jodancain/independent-cellular-ai-glasses/README.md

# 独立蜂窝智能眼镜开发需求

**v0.1 公开讨论稿 · 来源核验日期 2026-11-02**

本项目整理可独立联网的智能眼镜需求，供硬件供应商、系统开发者和集成方共同评审。优先面向汽车服务场景中的现场作业与远程协作，并预留面向车主的功能路线。

目标是找到一套**脱离手机和手机热点、使用机内 SIM 或 eSIM 蜂窝网络、由 ARM 应用主处理器运行自研业务软件**的可维护方案。应用、账号和云服务由项目方自主建设，不以第三方消费级品牌的账号、AI 或云服务作为核心功能前提。

本仓库是需求、证据和方案讨论的协作入口，**不是可直接量产的硬件设计，不是性能承诺、采购订单或最终冻结规格**。具体配置、费用、认证、供货与维护责任须另行确认。

## 从哪里开始

| 文档 | 内容 |
| --- | --- |
| [开发需求](docs/requirements.md) | 硬性边界、场景、硬件选项、系统交付和验证方法 |
| [芯片候选](docs/chips.md) | 已讨论平台的公开信息、项目判断及待核实项 |
| [工程判断](docs/engineering-assessment.md) | 选型依据、系统集成风险及证据边界 |
| [串流终端方向](docs/streaming-direction.md) | v0.7.6：眼镜有脑、有小脑、有手、有脚（脚 = 蜂窝 / Wi-Fi 7 / BLE / USB-C 连接，决定 #25）；默认无线、依赖网络而非手机的串流 AR 眼镜；联网全功能 / 断网手表模式、光波导 + 光机、手机级视频通话与虚拟形象、6DoF 真实画面交互、开放云、8 小时混合续航、续航优先、佩戴无感的重量分配、芯片组合 |
| [技术路线](docs/technical-roadmap.md) | 四颗主芯片按角色分工（主 SoC 与显示与重投影处理器是小脑，RedCap 是脚，常驻 BLE 与听音的低功耗 MCU 是常醒的小脑兼管脚的 BLE）各子系统主选 / 备选与切换条件、软件栈与开放协议、M0 验证 → M1 桌面功能样机 → M2 完全版样机 → M3 优化样机 |
| [在线浏览](https://glasses.youngtuo.win/) | 本仓库文档的网页版与动态架构图，公网可直接访问 |
| [系统架构图](docs/system-architecture.md) | 11 张图：系统全景（脑 / 小脑 / 手 / 脚）、硬件框图（两张）、显示数据通路（含看板态）、软件栈、协议通道、功耗状态机、通话与虚拟形象、部署视图、显示模式与小脑调度、投屏与多路信号；动态版见 `visuals/architecture-motion` |
| [设计开发要求](docs/design-requirements.md) | 218 条可验收要求（SYS / HW / PWR / DISP / NET / SW / HOST / PROT / CALL / APP / CLOUD / ERGO / SEC / DEV），每条含来源、优先级、验证方法、阶段，附 25 条决定追溯表与脑 / 小脑 / 手 / 脚角色映射 |
| [原型经验](docs/prototype-learnings.md) | 应用原型里验证过的核心技术：第一视角投屏与专家标注回传、远程视频通话（路线收敛、六档带宽自适应、会议入会）、头姿与相机–IMU 时间对齐、显示–相机标定、采集质量门、Agent 边界与来源标注 |
| [现成硬件验证计划](docs/validation-plan.md) | 自研前用现成设备做的 6 组验证：串流延迟与兼容、6DoF 交互、RedCap 联网与睡眠、手表模式功耗、视频通话与虚拟形象、佩戴无感基线；含设备清单、步骤、通过标准与记录表 |
| [第 1、3、6 组设备准备清单](docs/equipment-groups-1-3-6.md) | 先做的三组验证的候选设备、共用关系与核实项（不含价格） |
| [测试工具](tools/README.md) | 第 1、3、6 组的计时页、延迟统计、RedCap AT / 测速 / 电流分析、人体工学统计脚本（标准库，含单元测试） |
| [供应商回复模板](docs/supplier-response.md) | 可复制的技术方案回复与偏差表 |
| [硬件初版 v0.1](hardware/v0.1/README.md) | 两块板的 KiCad 原理图与初版 PCB（MCU 常驻板全真实器件、已布线、剩 4 处断线；主板主 SoC 等为占位、只有布局），网站 [硬件页](https://glasses.youngtuo.win/hardware.html) 用 three.js 三维查看；还不能下单 |
| [完整来源](docs/sources.md) | 官方资料、公开参考项目及核验日期 |
| [贡献指南](CONTRIBUTING.md) | Issue、Pull Request 和公开资料边界 |

## 当前合作重点

1. 对比 W527、W5 系列蜂窝SKU及供应商已有量产经验的替代方案，不预先锁定单一芯片。
2. 对基础 HUD 文字箭头与空间 AR 分两档提案和报价，不将 6DoF 作为统一硬性要求（本条针对[开发需求](docs/requirements.md)的轻量眼镜；[串流终端方向](docs/streaming-direction.md)需求方已确认需要 6DoF）。
3. 在相同负载下验证整机功耗、温升、续航、音视频、显示和蜂窝并发能力。
4. 确认 BSP、驱动、系统接口、权限、签名、OTA、许可和长期维护能实际交付。

## 如何公开协作

- 对需求、资料或结论有补充，可先开 Issue，说明具体问题、来源和影响。
- 供应商可复制[回复模板](docs/supplier-response.md)，通过 Pull Request 提交可公开的技术方案；也可直接提出文档修订。
- 每次修改应区分公开事实、项目判断、建议目标和待确认项。参数变化须附来源版本、测试条件或明确的待验证说明。
- Pull Request 由维护者评审后决定是否合并。提交建议不代表获得直接写入权限、方案被选用或采购承诺。
- 商业报价、合同、保密资料和个人联系方式不放入公开 Issue 或 PR，另用双方确认的非公开渠道交流。

## 公开内容边界

本仓库只维护可公开的文本需求和引用。不接收固件、SDK 二进制、解包文件、私钥、令牌、真实设备标识、内部日志或客户数据。不要上传本方内部需求文件的原始副本。

## 许可状态

本项目暂未选择仓库许可证。不要把公开可读或接受 PR 理解为已授予 MIT、Apache 或其他开源许可。引用的第三方项目和资料分别遵循其自身许可与使用条件；本仓库不改变这些条件。
