jodancain/independent-cellular-ai-glasses/docs/chips.md

# 芯片候选与选择依据

**v0.1 公开讨论稿 · 来源核验日期 2026-11-02**

推荐顺序是本项目的工程判断，不是厂商对智能眼镜适用性的认证。优先让供应商对 W527、W5 系列加蜂窝及其成熟替代方案提交同负载整机数据，不提前锁定单一芯片。

## 候选对比

| 候选 | 已核实的公开信息 | 本项目判断与待确认项 |
| --- | --- | --- |
| W527 优先询价 | ARM 1×A75 加 3×A55；LPDDR3/4X、eMMC 5.1；LTE Cat4、VoLTE；1080p30 编解码。[S1](sources.md#s1) | 较贴近独立蜂窝应用主机需求。询问真实可采购 RAM/存储、摄像与显示 BSP。4GB 加 32GB 是询价目标，没有已验证量产配置证据。 |
| W5 与 W5+ Gen 1 优先询价 | SW5100 四核 A53；W5+ 配套 M55 协处理器。公开 LTE Cat1/4；TurboX 板实例为 2GB 加 32GB、Nano SIM。[S2](sources.md#s2)[S3](sources.md#s3) | 须区分 SW5100 蜂窝与 SW5100P 版本。参考板 eSIM 标为 Reserved，不能当成已实现；确认摄像显示并发能力、BSP 和整机热功耗。 |
| RV1126B 功能原型 | 四核 A53、3 TOPS、H.264/H.265、DSI；Luckfox Aura 有 1/2/4GB 板级选项与 Linux 资料。[S4](sources.md#s4)[S5](sources.md#s5) | 便于摄像与 Linux 功能验证；蜂窝需另行集成。不能据开发板认定轻眼镜低功耗，官方 8M30FPS 典型功耗仍为 TBD，不能套用旧 RV1126 数字。 |
| AR1 与 AR1+ 有条件评估 | 公开连接信息以 Wi-Fi、蓝牙为主；提供面向眼镜的媒体和端侧 AI 能力。[S6](sources.md#s6)[S7](sources.md#s7) | 离线小模型能力不等于原生 LTE。独立蜂窝需供应商证明完整架构；RAM、系统开放度、modem 集成和持续并发能力待核实。 |
| W5+ Gen 2 备选询价 | 四核 A53、4nm、LPDDR4，公开有 LTE 平台信息。[S8](sources.md#s8) | 不能自动按 Gen 1 推定 Cat4、RAM 容量或摄像编解码能力。询问供货、BSP、蜂窝版本及是否有可展示的目标整机。 |
| Wear Elite 跟踪新平台 | 3nm、LPDDR5、LTE 与 RedCap、双 CSI；公开 Android 与 Linux 支持信息。[S9](sources.md#s9) | RAM 容量、视频编码能力、持续整机功耗及可获得的 BSP 仍需询证。公开 CPU 信息不支持自行补写核型和核数。 |
| BES2800BP 辅助路线 | 双 M55 加双 STAR-MC1；共享 8.3MB SRAM；PSRAM/Flash 为配置项；公开 Wi-Fi、蓝牙和 DSI。[S10](sources.md#s10) | 更偏 MCU 级路线。未获得官方 LTE、ISP、H.264 完整证据，不宜直接当成所需 ARM 应用主机；采用时须证明外接媒体与蜂窝方案。按方案决定 #24，它是低功耗 MCU 的 B 案候选（片内蓝牙可常驻收手机的气泡 / 看板描述，音频强），与 A 案 STM32N657 + 小 BLE 芯片在 M1 并行评估，见[技术路线](technical-roadmap.md)第 1.5 节。 |
| BES6100 成熟度待核实 | 2026年10月23日三季报披露已进入客户送样阶段。[S11](sources.md#s11) | 不能写成已量产。主核、RAM、系统、视频链路、蜂窝及量产时间均需官方规格和供应商书面确认。 |
| STM32N657 辅助路线 | M55 MCU、4.2MB SRAM，具 ISP 与 H.264 能力。[S12](sources.md#s12) | 不是 Android 应用主机，不能以 SRAM 取代本项目所需应用 RAM。可评估专项采集或辅控，但不直接替代主方案。 |

## 配置与证据边界

- 芯片能力、开发板实例和最终眼镜是三个层级。板上 2GB 或 4GB 既不等于芯片容量上限，也不证明供应商能在目标功耗和结构中交付同等配置。
- W527 的 4GB 加 32GB、Android 的 4GB 加 32–64GB 都只是询价候选，不是已验证的统一量产配置。
- 参考板标注的 eSIM 预留不能写成整机已实现；蜂窝必须同时确认 modem、射频、天线、卡方案、运营商和认证。
- RV1126B 的公开典型功耗项仍为 TBD，不能用旧 RV1126 的数值代替。
- ESP32 系列不满足本项目 ARM 应用主核方向，可作为局部连接或控制参考，不进入主处理器优先名单。
- 任何方案仍需验证目标眼镜上的持续蜂窝上行、音视频、显示并发、功耗、热和资源趋势。

## 供应商补充证据

每条路线请补充可采购型号与版本、RAM/存储选项、媒体和显示能力、系统及 BSP 交付范围、第三方许可、供货及维护状态，以及同口径整机测试。参数缺少证据时标注待确认，不根据相近型号或上一代平台自动补齐。

完整官方链接和参考项目见 [sources.md](sources.md)。
