jodancain/independent-cellular-ai-glasses/docs/design-requirements.md

# 设计开发要求

**v0.3.3 · 2026-11-09 · 依据 方案 v0.7.6（含第 3.11、4.5 节投屏与多路信号）、技术路线 v0.1.4（含第 1.11 节充电盒、第 1.12 节制造与打样、第 2.4 节原型验证的链路与算法）、[原型经验](prototype-learnings.md) v0.1**

本文件把 [方案](streaming-direction.md) v0.7.6 第 0.1 节需求方已确认的 25 条决定、[技术路线](technical-roadmap.md) v0.1.3 的四颗主芯片结构、接口、功耗预算、软件栈、开放协议与 M0–M3 阶段，以及 [验证计划](validation-plan.md) 的闸门 G1–G6，转写为可验收的设计开发要求。除明确标注的公开参照外，不引入仓库外事实；不新增产品需求，不补造数字。

## 0 证据边界与读法

### 0.1 依据与范围

- 产品需求依据只来自上述三份文档；公开边界与仓库约束按任务要求执行（SEC-08、DEV-13）。[系统架构图](system-architecture.md) v0.1.2 与本文件同时发布，图中的接口、通路和状态机与本文件 HW / PWR / PROT / CALL 各节对应；两者冲突时以本文件和技术路线为准。
- 本文件覆盖完全版样机（M2）及之前的开发要求；M2 直接用光波导。更大视场光波导、蜂窝 chip-down、ASIC 替代 FPGA、取消独立显示处理器等属于第二代架构，不在 v0.2 验收范围。
- M1 可在桌面功能样机上验证；M2 在眼镜形态复验；M3 只在 M2 冻结架构内优化功耗、重量和散热，并做认证预测试。

### 0.2 证据边界

文中所有数值均为【设计目标】，**未实测**。厂商公开数字（包括芯片峰值、延迟、功耗宣传值）未经本项目复现，不能当作整机实测结果，也不能替代验收。源文档未给数值、明确写“待定”或写“首轮测基线后确定”的，本文件统一写「待定（M1 定案）」；M1 用验证计划基线定案，定案前不得写成已冻结指标。源文档之间的冲突不在本文件中自行裁决，另在交付说明中列出。

本文件不是冻结规格、性能承诺、采购订单或交期承诺。开发板、商用眼镜和模组评估板的结果只能说明趋势，不能直接当作目标整机数据。

### 0.3 三个编号体系不要混用

| 记号 | 含义 | 用在哪里 |
| --- | --- | --- |
| P0 | 必须；完全版样机必须具备，或放行前必须完成的交付/流程要求 | 本文件“优先级”列 |
| P1 | 应该 | 本文件“优先级”列 |
| P2 | 可选 | 本文件“优先级”列 |
| P1–P4 | 续航方案：P1 机身混合使用、P2 镜腿热插拔电池、P3 线控模块/口袋电池、P4 主机供电 | 方案 §5.3；本文件只在引用续航方案时写“续航 P1”等 |
| M0–M3 | 阶段：M0 现成硬件验证、M1 桌面功能样机、M2 完全版样机（EVT）、M3 优化样机（DVT） | 本文件“阶段”列 |

**优先级 P1 只表示“应该”，与续航方案 P1 无关。** 引用续航方案时必须带“续航”二字，避免与优先级混淆。阶段列只写要求最晚满足的 M1、M2 或 M3。

### 0.4 来源与验证写法

- 「决定#n」指方案 §0.1 的 25 条决定；「方案§x」指 [方案](streaming-direction.md)；「路线§x」指 [技术路线](technical-roadmap.md)；「验证计划 Gx」或「验证计划第 x 组」指 [验证计划](validation-plan.md)。
- 验证方法只使用四类：**测试**（仪器/台架/整机测量）、**分析**（计算、预算、架构核对）、**检查**（审阅文档、配置、清单、供应商答复）、**演示**（在样机上执行可观察的功能流程）。
- 延迟类测试按验证计划 §0.3：p95 用 nearest-rank，每组至少 30 个有效样本；网络类 RTT 至少 300 个样本。测试条件、设备和版本必须记录，原始数据不进公开仓库。

### 0.5 公开边界

本文件只写可公开技术信息，不写公司内部信息、价格、供应商联系人或密钥。测试原始视频、录音、日志、账号、真实设备序列号、SIM 卡号、IMSI/IMEI 和受试者个人信息按验证计划 §0.1 脱敏，不进入公开仓库。

---

## 1 系统与模式（SYS）

| 编号 | 要求 | 来源 | 优先级 | 验证方法 | 阶段 |
| --- | --- | --- | --- | --- | --- |
| SYS-01 | 产品定义两级功能模式：有可用网络且能连上主机或云时为全功能（联网）；无网络，或网络可用但所有主机和云都连不上时为手表模式（断网）。 | 决定#6；方案§2.1 | P0 | 演示：M1 桌面样机分别构造联网、断网、网络在但主机/云不可达三种条件，检查模式进入与功能保留/关闭是否符合定义。 | M1 |
| SYS-02 | 模式判定依据是能不能连上服务，不是有没有连手机；不依赖手机或手机热点完成全功能联网。 | 决定#3、#6；方案§1、§2.1 | P0 | 测试：关闭手机和热点，仅用机身蜂窝/Wi-Fi 建立会话；再断开主机/云，确认进入手表模式。 | M1 |
| SYS-03 | 模式切换无感：断网时当前串流画面淡出并提示“已切换到离线模式”；恢复联网后自动回到上次主机和会话。 | 方案§2.1 | P1 | 演示：M1 桌面样机执行断网→恢复，记录提示、画面淡出和回连结果；M2 整机复验。 | M1 |
| SYS-04 | 默认形态为无线：眼镜本体靠自带电池、机身蜂窝和 Wi-Fi 独立完成全功能；线控模块是可选配件，用于更长续航和更高带宽 5G，不是使用前提。 | 决定#3、#11；方案§1；路线§1.10 | P0 | 演示：M2 整机不接线控模块完成全功能；再接模块验证扩展。 | M2 |
| SYS-05 | 第一版样机为完全版，至少包含有线 A1/A2、Wi-Fi、机身蜂窝、6DoF 交互、视频通话 V1–V3、手表模式与同步接口、分级睡眠、BLE 气泡、看板态、常驻听音、虚拟形象；眼动摄像头当前版本只做预留、不装配。BLE 气泡 / 看板态属于联网或待机通路，断网时手机经 BLE 代为联网待确认（方案 §10），确认前不算手表模式功能。线控模块和换电电池作为配件同步打样。 | 决定#10、#20、#24；方案§9、§10；路线§3 | P0 | 检查：对照 M2 样机配置清单和演示记录逐项核对；确认眼动只预留、未装配；确认 BLE 气泡未算进手表模式；缺项不得判 M2 出口通过。 | M2 |
| SYS-06 | PC、手机、车机、云四类主机全部支持；多主机可用时按“有线 > 同局域网 > 云”优先，断线后自动回到上次主机。 | 决定#4；方案§3.4 | P0 | 演示：M1 依次接入四类主机（可用开发板/云主机替代），演示优先级和回连。 | M1 |
| SYS-07 | 6DoF 追踪、空间锚定、手势交互、平面/物体识别是基础能力；目标是 VR 级能力 + 光学透视 AR 效果，不追求完整 VR 游戏。 | 决定#5；方案§3.1 | P0 | 测试：验证计划第 2 组测锚定漂移、手势成功率/误触；M2 整机复验。 | M1 |
| SYS-08 | 手表模式只保留看时间、拍照、录像、录音和极小本地程序；串流、6DoF 叠加、软件兼容层、云 AI 及其他功能关闭。 | 决定#6；方案§2.1 | P0 | 演示：M1 断网后逐项检查保留/关闭功能；确认不能绕过进入串流或 6DoF。 | M1 |
| SYS-09 | 交互架构按“脑 / 小脑 / 手”分工：眼镜 + 云端 LLM 是脑，理解意图、决定派哪只手、决定显示什么；眼镜自身算力只当小脑，做姿态追踪、解码、多图层合成、重投影、光波导畸变校正、轻量卡片、条件反射、手表模式和显示分配；手机、PC、车机、云主机都是手。渲染规则：手渲染自己的内容；轻内容由小脑本地画；合成 / 锚定 / 重投影由小脑做，目标 ≤5 ms【设计目标】；不属于任何手的重内容交最近的有 GPU 的手（PC 优先，其次云）；重渲染永远不在眼镜上。 | 决定#22；方案§1.1 | P0 | 演示：M1 用手机看板、PC 应用、云虚拟形象各跑一条链路，检查内容由对应手渲染、眼镜只做合成 / 重投影；分析：核对各链路没有把重渲染放回眼镜。 | M1 |
| SYS-10 | 四个角色加器官贯穿全部设计：脑（眼镜 + 云端 LLM）、小脑（眼镜自身算力）、手（所有主机）、**脚（连接：机身蜂窝、Wi-Fi 7、常驻 BLE、有线 USB-C、可选线控模块 5G）**；器官为摄像头、麦克风、扬声器 / 耳机、光波导。每个硬件模块、软件模块、协议通道和验证项都要能说清自己属于哪个角色；脚的选路按“有线 > 同局域网 > 云”，细步（意图、气泡、看板描述）走 BLE、大步（视频、投屏）走 Wi-Fi / 蜂窝 / 有线；四条腿都走不到任何一只手时退化为手表模式。 | 决定#6、#22、#25；方案§1.1 | P0 | 检查：评审时按 §18 角色映射表逐项核对硬件框图、软件栈、协议和验证计划，每项都有角色归属且没有越位（例如重渲染不进小脑、派手不由脚决定）。 | M1 |

---

## 2 硬件（HW）

### 2.1 主 SoC（HW-SOC）

| 编号 | 要求 | 来源 | 优先级 | 验证方法 | 阶段 |
| --- | --- | --- | --- | --- | --- |
| HW-SOC-01 | 眼镜本体按四颗主芯片分工：AR 级主 SoC（联网全功能与 6DoF）、显示与重投影处理器（有线直通与上屏）、RedCap 蜂窝（独立联网）、低功耗 MCU（手表模式、睡眠、BLE 常驻与电源管理）。A 案在 MCU 外另加一颗小 BLE 芯片，B 案蓝牙在 BES2800BP 片内。 | 路线§0、§1；决定#24 | P0 | 检查：审阅硬件框图与接口表，确认四颗主芯片职责、A 案 BLE 芯片、接口和电源域与路线 §1.6 一致。 | M1 |
| HW-SOC-02 | 主 SoC 主选 Snapdragon AR2 Gen 1；AR1+ Gen 1 只在同时满足两个条件时作为备选：显示处理器负责把画面放大到光机分辨率；显示处理器用重投影把 60 Hz 内容补到 90 Hz 以上上屏。 | 路线§1.1 | P0 | 检查：审阅主选/备选评估报告和供应商答复，逐条核对两个条件；不满足不得切 AR1+。 | M1 |
| HW-SOC-03 | 主 SoC 门禁一：能在没有手机或 PC 时独立运行 AOSP 系统、6DoF 和云串流客户端；M1 结束前拿到供应商书面答复或实测结果。 | 路线§1.1 | P0 | 检查：审阅供应商书面答复；用开发板断开手机/PC，启动 AOSP、跑 6DoF 和云串流客户端。 | M1 |
| HW-SOC-04 | 主 SoC 门禁二：支持 H.265 硬解；AV1 是加分项。 | 路线§1.1 | P0 | 检查：核对芯片规格书，并在开发板上用 H.265 码流验证硬解；AV1 只记录是否支持。 | M1 |
| HW-SOC-05 | 主 SoC 门禁三：能把解码帧以 1080p 级、60 Hz 以上送给显示处理器；最终上屏分辨率和刷新率由显示处理器负责。 | 路线§1.1 | P0 | 测试：在开发板上测解码帧输出分辨率、帧率和送显通路；达不到即门禁不通过。 | M1 |
| HW-SOC-06 | 门禁不通过时按顺序切换：AR2 → AR1+（两个条件成立）→ “眼镜 + Reality Elite 计算盒”。走到计算盒形态会改变决定#11（默认无线），必须重新确认，不得直接实施。 | 路线§1.1、§4 | P0 | 检查：审阅切换决策记录；触及决定#11 时核对需求方重新确认记录。 | M1 |
| HW-SOC-07 | 主 SoC 并发能力门禁：主显示 1 路全帧率硬解、通话上行编码、两路追踪相机与主摄 ISP 同时运行；能同时硬解几路、编码解码并发上限以供应商书面答复或 M1 实测为准，不满足按路线 §1.1 切换。 | 方案§3.11；路线§1.1 | P0 | 测试：M1 参考平台跑“主显示解码 + 通话编码 + 两路追踪 + 主摄”并发 30 分钟，记录掉帧、温度与降频；分析：核对供应商规格。 | M1 |

### 2.2 显示与重投影处理器（HW-DP）

| 编号 | 要求 | 来源 | 优先级 | 验证方法 | 阶段 |
| --- | --- | --- | --- | --- | --- |
| HW-DP-01 | DP 接收桥主选龙迅 LT7911UXC 一类芯片：Type-C/DP1.4a 输入，MIPI DSI/CSI 输出，带 DSC 解码；备选为同类 DP 接收桥接芯片。 | 路线§1.2 | P0 | 检查：核对桥接芯片规格与 Linux 驱动；在评估板上打通 DP 输入到 MIPI 输出。 | M2 |
| HW-DP-02 | 原型用 FPGA 按最新姿态对整帧做扭曲，同时完成畸变与色差校正、缩放和 60→90 Hz 以上补帧；FPGA 只用于原型快速迭代，量产形态第二代再定。 | 路线§1.2 | P0 | 测试：M1 用 FPGA 板接现成光波导模组 / 光机评估板，测扭曲、校正、补帧和帧计数。 | M1 |
| HW-DP-03 | A1 有线原始画面支持两档：A1-3DoF 时主 SoC 休眠，显示处理器直读 IMU 只做旋转稳定；A1-6DoF 时主 SoC 运行 VIO 并提供 6DoF 姿态。DP 二维画面按平面虚拟屏合成，3D 内容改走 L1 OpenXR。 | 路线§1.2 | P1 | 演示：M1 分别演示 A1-3DoF 与 A1-6DoF，检查主 SoC 休眠/运行状态和虚拟屏稳定性。 | M1 |
| HW-DP-04 | A2/B/C 编码串流由主 SoC 解码，经 MIPI 交显示处理器扭曲后上屏；扭曲始终放在离屏幕最近的一级，保证头动感知延迟不受网络影响。 | 路线§1.2；方案§3.5 | P0 | 测试：M1 在 A2/B/C 链路测解码→MIPI→扭曲→上屏，确认头动感知延迟与网络延迟解耦。 | M1 |
| HW-DP-05 | 手表模式通过显示开关把显示切到 MCU 的低速显示接口，主 SoC 和显示处理器可断电；面板需支持低刷新、局部点亮。 | 路线§1.2、§1.6 | P0 | 演示：M1 切手表模式，确认主 SoC/显示处理器断电后 MCU 仍能驱动低刷新显示。 | M1 |
| HW-DP-06 | 可选（P2 / M1 次要评估项，不阻塞 M1 出口）：视频与显示处理器带硬解时，串流解码、重投影、上屏由该处理器完成，主 SoC 降为低功耗网络态（GPU / 视频解码 / 显示管线可关闭；CPU 网络部分是否可关取决于方案），只在 6DoF、AI、通话时唤醒。**降级理由：视频不再是主要场景，重渲染仍在手上，眼镜侧 GPU 要求只降不升。** | 路线§1.2、§4、§5#8；决定#24 | P2 | 检查：M1 只在有余力时核对 HX77 类候选的 H.265 / AV1 硬解、收流协议栈位置和双目输出规格；不作为 M1 出口条件，M2 再评估串流功耗收益。 | M1 |
| HW-DP-07 | 显示处理器多层叠加：至少把“DP 画面层 + 1 个叠加层”合成后再扭曲上屏；叠加层由 MCU 或主 SoC 经低速接口 / MIPI 送入，A1 时主 SoC 可睡也能出气泡。 | 方案§4.5；路线§1.2 | P1 | 测试：M1 在 A1-3DoF 下让 MCU 送一个气泡叠加层，检查合成结果与上屏延迟。 | M1 |

### 2.3 光学与显示（HW-OPT）

| 编号 | 要求 | 来源 | 优先级 | 验证方法 | 阶段 |
| --- | --- | --- | --- | --- | --- |
| HW-OPT-01 | 完全版样机（M2）采用**光波导**，且只用光波导；birdbath、自由曲面棱镜等其他方案已放弃，不再考虑。主选几何反射式（阵列）光波导，候选 Lumus Z-30 系列：30° 视场、演示机 720×720、几何反射式；新一代更薄（最薄 0.8 mm）、约轻 30%，70° 宽视场原型未公布量产时间。备选衍射式光波导：开源样机已用单绿衍射波导做出可戴样机（S59），全彩衍射波导仍待调研。 | 决定#21；路线§1.3；S49、S50、S59 | P0 | 检查：审阅光波导选型报告和供应商书面答复，核对主选/备选与量产状态；确认 M2 BOM 只含光波导方案。 | M2 |
| HW-OPT-02 | 显示走光学透视：人眼直接看真实世界，虚拟内容叠加其上，全彩；不以摄像头透视替代。 | 方案§3.1；路线§1.3 | P0 | 演示：M2 在真实桌面上放置虚拟屏，检查透视、遮挡关系和全彩叠加。 | M2 |
| HW-OPT-03 | 显示目标：双目光波导，视场 30–50°（以光机与波导组合定案）；分辨率以所选光机为准（待定，M1 定案）；入眼亮度目标约 4000 尼特以满足户外可读【公开资料】[S52](sources.md#s52)；刷新率 60 Hz 起，显示处理器可补帧到 90 Hz 以上（待光机确认）。 | 决定#21；方案§3.6；路线§1.3；S52 | P0 | 测试：M2 整机测视场、入眼亮度、分辨率、刷新率、全彩显示和双目一致性；分辨率在 M1 定案后回填。 | M2 |
| HW-OPT-04 | 光波导前框重量用验证计划第 6 组测得的鼻托受力基线约束；M2 用实物测鼻托受力，超标时按路线 §4 G6 处理。 | 路线§1.3、§4；验证计划第 6 组 | P0 | 测试：M2 用头模测光波导实物鼻托受力，与对标产品实测值比较。 | M2 |
| HW-OPT-05 | 光机主选 LCoS 或全彩 microLED，M1 定案。LCoS 参照 Meta Ray-Ban Display（Lumus 光波导 + LCoS）【公开资料】[S51](sources.md#s51)；全彩 microLED 参照 JBD Hummingbird（0.13 英寸、640×480、30° 视场可在 25–45° 定制、1.0 g、典型功耗约 260 mW）【公开资料】[S53](sources.md#s53)；高亮度小尺寸 micro-OLED（索尼 0.44 英寸 1080p、10000 尼特）【公开资料】[S46](sources.md#s46) 仅作亮度参照。切换条件：入眼亮度、分辨率、功耗、重量四项。 | 路线§1.3；S46、S51、S53 | P0 | 检查：M1 取得候选光机供应商书面答复，按四项条件评审并定案；记录未选路线的原因。 | M1 |
| HW-OPT-06 | 接受光波导的代价：当前视场明显小于已放弃的 birdbath 方案，虚拟屏面积变小，“Quest 级大屏观影”体验下降；换来前框更轻更透，符合“佩戴无感”（决定#18/#19）。该取舍已由需求方接受，不再把 birdbath 作为备选。 | 决定#18、#19、#21；方案§3.6、§7；路线§1.3 | P0 | 检查：M2 评审虚拟屏尺寸、观影体验与前框重量，确认取舍记录与需求方确认记录一致。 | M2 |
| HW-OPT-07 | 单绿 microLED 光机（640×480）+ 单绿衍射光波导只作 M0 / M1 早期验证件，用来先跑通通知层 / 看板态 HUD 和结构试装；不进 M2 BOM，不替代 HW-OPT-05 的全彩主选，不用于验证视频投屏。 | 路线§1.3；S59 | P2 | 检查：确认 M2 BOM 不含单绿光机；M1 用早期验证件跑通看板态上屏并记录结论。 | M1 |

### 2.4 蜂窝（HW-CELL）

| 编号 | 要求 | 来源 | 优先级 | 验证方法 | 阶段 |
| --- | --- | --- | --- | --- | --- |
| HW-CELL-01 | 机身蜂窝最低要求是满足串流最低网络要求，按 5G RedCap 选型；LTE Cat4 只在实测持续速率满足第 6.3 节三档时作为备选。 | 决定#9；方案§6.3 | P0 | 测试：验证计划第 3 组在强/弱信号下测持续速率和 RTT p95，对照 NET-01–NET-03。 | M1 |
| HW-CELL-02 | 原型主选 Quectel RG255C-GL（基于 Snapdragon X35）；对照/备选 RG255G-GL 或 LTE Cat4。切换条件：持续速率或 RTT 不满足方案 §6.3，或模组本身休眠电流不可接受。 | 路线§1.4 | P0 | 检查：核对模组规格与评估板；按第 3 组用例测速率、RTT 和休眠电流，触发条件时换对照模组。 | M1 |
| HW-CELL-03 | SIM 以 eSIM 为主，M2 期间保留实体卡槽，方便插运营商测试卡。 | 路线§1.4 | P1 | 检查：核对 M2 主板卡槽/eUICC 设计与样机配置。 | M2 |
| HW-CELL-04 | 蜂窝、Wi-Fi、蓝牙三套天线在镜腿内的布局、隔离度、灵敏度下降和 SAR，在 M2 画板前完成天线方案，M2 整机实测，不留到认证阶段。 | 路线§1.8 | P0 | 测试：M2 整机测共存、隔离度、灵敏度和 SAR 摸底；检查画板前天线方案。 | M2 |
| HW-CELL-05 | 机身蜂窝休眠电流是待机功耗最大风险，选型前必须实测；eDRX/PSM 是否生效以电流波形为准，不以 AT 返回“已设置”为准。若换模组仍不达标，高带宽场景交线控模块，机身降为“消息 + 语音 + 低码率”，并需重新确认决定#9。 | 方案§5.2；路线§1.4、§4 | P0 | 测试：验证计划第 3 组测 PSM/eDRX 休眠电流和波形；检查降级方案是否触发决定#9 重新确认。 | M1 |

### 2.5 低功耗 MCU（HW-MCU）

| 编号 | 要求 | 来源 | 优先级 | 验证方法 | 阶段 |
| --- | --- | --- | --- | --- | --- |
| HW-MCU-01 | MCU 按 A/B 两案并行评估，M1 定案：A 案 = STM32N657（Cortex-M55、4.2 MB 片上 SRAM、ISP、H.264）+ 外挂 PSRAM + 小 BLE 芯片，保留已论证的拍照 / 录像通路，代价是多一颗芯片；B 案 = BES2800BP 主选（S10：双 M55 + 双 STAR-MC1、8.3 MB SRAM、Wi-Fi、蓝牙、DSI，音频强），ISP/H.264 证据不完整，手表模式拍录像需短时唤醒主 SoC。主 SoC 平台自带低功耗岛只在开放给自研程序、能单独驱动摄像头和显示时作为共同备选。 | 决定#24；路线§1.5；S10、S12 | P0 | 检查：审阅 A/B 两案的开发板、BOM、重量、功耗和供应商开放性对比；按 HW-MCU-06 闸门定案。 | M1 |
| HW-MCU-02 | MCU 能独立完成拍照、录像、录音和手表模式小程序，不唤醒主 SoC；录像时可按需短时唤醒主处理器 ISP。 | 方案§2.2；路线§1.5 | P0 | 测试：验证计划第 4 组在 MCU 开发板上跑拍照、1080p 录像、录音和小程序，记录是否唤醒主 SoC。 | M1 |
| HW-MCU-03 | 内存预算按 1080p YUV420 一帧约 3.1 MB 计算；4.2 MB 片上 SRAM 放不下录像缓冲加参考帧，录像缓冲必须放外挂 PSRAM。 | 路线§1.5 | P0 | 分析：按录像分辨率、缓冲帧数和参考帧做内存预算；检查 PSRAM 方案。 | M1 |
| HW-MCU-04 | MCU 系统主选 Zephyr RTOS，不满足板级支持门禁则退回 FreeRTOS；MCU 统一调度 S0–S3、看板态、PMIC 和各路负载开关。 | 路线§1.5、§1.9、§2.1 | P0 | 测试：在开发板上跑 Zephyr/FreeRTOS，验证 S0–S3、看板态状态机和电源域通断。 | M1 |
| HW-MCU-05 | MCU 侧常驻收 BLE：手机这只手的气泡与看板描述主要走 BLE，主 SoC 睡着时也要收得到。A 案由外加小 BLE 芯片承担，B 案由 BES2800BP 自带蓝牙承担；STM32N657 本身无无线射频。 | 决定#24；方案§5.4、§6.2；路线§1.5、§1.6 | P0 | 测试：主 SoC 睡眠，手机经 BLE 发气泡和看板描述，确认 MCU 收到并能直接上屏或按需唤醒主 SoC。 | M1 |
| HW-MCU-06 | MCU A/B 闸门：主 SoC 睡眠时，BLE 送来的气泡 ≤0.1 s 上屏【设计目标】；同时评估 B 案手表模式拍录像是否需短时唤醒主 SoC、A 案多一颗芯片的重量与成本。达不到闸门的方案不得定案。 | 决定#24；方案§6.2；验证计划第 4 组 | P0 | 测试：按验证计划第 4 组“BLE 气泡上屏延迟（主 SoC 睡眠）”测 p95，至少 30 个样本；检查 B 案拍录像的唤醒时序与 A 案 BOM。 | M1 |

### 2.6 音频：常驻“耳朵 + 嘴巴”（HW-AUD）

| 编号 | 要求 | 来源 | 优先级 | 验证方法 | 阶段 |
| --- | --- | --- | --- | --- | --- |
| HW-AUD-01 | 唤醒词与人声检测常驻 MCU；麦克风阵列能直接接 MCU，主 SoC 睡着时也能听；主 SoC 醒来后按需接管音频。 | 决定#24；方案§5.4；路线§1.5、§1.6 | P0 | 测试：主 SoC 睡眠时用唤醒词和人声样本触发，记录唤醒率、误唤醒和唤醒到响应时间；检查麦克风阵列直连 MCU 的通路。 | M1 |
| HW-AUD-02 | 音频升级为常驻“耳朵 + 嘴巴”：麦克风负责语音输入与通话上行，扬声器 / 耳机负责下行；开放式扬声器做防漏音，蓝牙耳机切换可用。 | 决定#24；方案§1.1；路线§2.1 | P0 | 测试：M1 测扬声器漏音、耳机切换和通话上下行；检查主 SoC 睡眠时提示音 / 唤醒反馈是否可用。 | M1 |
| HW-AUD-03 | 麦克风阵列、扬声器、蓝牙耳机的器件型号待选型（M1 定案）；不写未核实的型号和指标。 | 决定#24；方案§3.6 | P0 | 检查：审阅选型清单和供应商答复；未定案前不得写成已冻结型号。 | M1 |
| HW-AUD-04 | 下行音频混音：通话 > 助手回复 > 提示音 > 媒体，高优先级到来时低优先级压低音量；回声消除以混音后的输出作参考信号；蓝牙耳机与开放式扬声器切换不丢通话。 | 方案§3.11 | P1 | 测试：M1 同时播放媒体与通话、插入提示音，检查压低与恢复；通话中切蓝牙耳机，检查回声与断音。 | M1 |
| HW-AUD-05 | 下行音频合路：常驻侧（MCU 或其蓝牙音频芯片）与主 SoC 各一路下行，用音频通道选择开关合成一路送功放；默认接常驻侧，主 SoC 醒来接管投屏 / 通话音频时切换，睡前切回；切换不得有明显爆音。 | 路线§1.5；S59 | P1 | 测试：M1 反复让主 SoC 睡眠 / 唤醒，录下扬声器输出，检查切换爆音与切换时延；确认主 SoC 断电时常驻侧音频不中断。 | M1 |

### 2.7 传感器与 6DoF（HW-SENS）

| 编号 | 要求 | 来源 | 优先级 | 验证方法 | 阶段 |
| --- | --- | --- | --- | --- | --- |
| HW-SENS-01 | 2 颗全局快门单色追踪相机放在前框左右两角，6DoF 与手部追踪共用；IMU 为 6 轴、采样率 ≥1 kHz，同时接显示处理器和主 SoC，或由显示处理器转发。 | 路线§1.7、§1.6 | P0 | 测试：M1 开发板验证追踪相机与 IMU 同步、采样率和 6DoF 输入。 | M1 |
| HW-SENS-02 | 1 颗 RGB 主摄，实时编码 1080p30 起，带防抖；本地录像可更高。 | 方案§3.6；路线§1.7 | P0 | 测试：验证计划第 5 组用主摄替身测 1080p30 实时编码、防抖和本地录像。 | M1 |
| HW-SENS-03 | 眼动硬件只做预留（P0）：保留前框结构空间、柔性板走线与连接器、主 SoC 侧 MIPI 接口与电源域；当前版本不装配、不实现，注视交互不在当前版本。装配与功能为 P2 后续版本选配，届时启用预留接口。 | 决定#20；方案§3.6、§3.8；路线§1.7 | P0 | 检查：核对结构图、柔性板走线、连接器及 MIPI / 电源域预留；确认 M2 / M3 未装配眼动相机。测试：后续版本启用时再按眼动功能验收。 | M2 |
| HW-SENS-04 | 佩戴检测用接近或电容传感器接 MCU；主摄用 MIPI CSI 二选一开关，I2C、时钟、复位、电源随开关一起切换，由 MCU 仲裁，同一时刻只给 MCU 或主 SoC 一方使用。 | 路线§1.6、§1.7 | P0 | 测试：M1 验证佩戴检测唤醒；切换主摄归属，确认不会同时被两颗芯片占用。 | M1 |
| HW-SENS-05 | 6DoF/手势算法主选 SoC 厂商随 BSP 提供的感知栈；备选开源 Basalt VIO（Monado 维护分支）+ 开源光学手部追踪；Monado 追踪仍标实验性，移植工作量另评。 | 路线§1.7 | P1 | 测试：M1 分别跑厂商感知栈和备选方案，记录精度、功耗和移植工作量。 | M1 |
| HW-SENS-06 | 虚拟屏锚定漂移、手势成功率、误触率的通过阈值待定（M1 定案）；M1 用验证计划第 2 组建立基线后定案，不得先写成已冻结指标。 | 验证计划第 2 组、§2.6 | P0 | 测试：按第 2 组测静态/转头/走动漂移、点选/拖拽/缩放成功率和误触；M1 评审定阈值。 | M1 |

### 2.8 USB-C 与无线（HW-IO）

| 编号 | 要求 | 来源 | 优先级 | 验证方法 | 阶段 |
| --- | --- | --- | --- | --- | --- |
| HW-IO-01 | A1 有线原始画面：USB-C 4 路 DP，眼镜作为 DP 接收端 + USB 2.0 设备（UVC/UAC 通话）+ 受电。 | 路线§1.8 | P0 | 测试：M1 用 DP 源接眼镜/评估板，确认 4 路 DP、USB 2.0 设备枚举和受电。 | M1 |
| HW-IO-02 | A1 带宽按最终光机分辨率与刷新率核算（M1 定案）；4 路 HBR3 为高分辨率双目留余量，是否需 DSC 也在 M1 核算；主机 DP 不支持 4 路时改为 2 路 DP 加 DSC。 | 路线§1.8 | P0 | 分析：按 M1 定案的光机规格核算带宽；M2 用 4 路和 2 路+DSC 两种配置测显示稳定性。 | M2 |
| HW-IO-03 | A2 有线编码：USB 3 设备（串流 + UVC/UAC）+ 受电，不走 DP；接线控模块用 USB 3（视模块版本加 DP），受电，数据角色由模块决定。 | 路线§1.8 | P0 | 测试：M1 跑 A2 USB 3 串流与 UVC/UAC；M2 接模块验证数据角色和供电。 | M1 |
| HW-IO-04 | 充电由 PD 协商，眼镜作为受电端。 | 路线§1.8 | P0 | 测试：M2 用 PD 电源测充电协商、功率和温升。 | M2 |
| HW-IO-05 | 无线用 Wi-Fi 7，优先用 AR2/AR1+ 平台配套连接芯片；6 GHz 国内可用性必须核实，用不了按 5 GHz 160 MHz 设计；蓝牙 5.3 起，连接耳机、手柄、戒指。 | 路线§1.8 | P1 | 检查：核对连接芯片规格和国内 6 GHz 结论；M2 测 Wi-Fi 7/5 GHz 160 MHz 和蓝牙连接。 | M2 |

### 2.9 电源与电池（HW-PWR）

| 编号 | 要求 | 来源 | 优先级 | 验证方法 | 阶段 |
| --- | --- | --- | --- | --- | --- |
| HW-PWR-01 | 两块电芯分置左右镜腿耳后段，左右重量差 ≤3 g。 | 路线§1.9；方案§7.3 | P0 | 测试：M2 左右镜腿分别称重，差值 ≤3 g；同时记录总重和分段重量。 | M2 |
| HW-PWR-02 | 机身电池按 5–7 Wh 设计；实测超预算时按续航优先加到 8–10 Wh，全部放在耳后，约增加 10–15 g 重量。 | 决定#19；方案§7.2；路线§1.9 | P0 | 测试：M2 测续航 P1 剖面电量；不足时按 8–10 Wh 方案重做重量与热预算。 | M2 |
| HW-PWR-03 | 以下电源域分别可断电，由 MCU 控制：显示、显示处理器、主 SoC；Wi-Fi、蜂窝；追踪相机、眼动相机（仅预留电源域）、主摄。 | 路线§1.9 | P0 | 测试：M1 逐路断开已装配电源域，确认其他域不受影响，MCU 能控制通断；眼动电源域只核对预留。 | M1 |

### 2.10 配件：充电盒（HW-ACC）

| 编号 | 要求 | 来源 | 优先级 | 验证方法 | 阶段 |
| --- | --- | --- | --- | --- | --- |
| HW-ACC-01 | 充电盒（可选配件）同时承担：给眼镜充电 / 备用电池、BLE 输入回传（按键 + 摇杆，走 PROT 的输入回传通道，不另开协议）、显示眼镜电量与连接状态；不增加眼镜本身重量。是否做在 M2 之后定。 | 路线§1.11；S60 | P2 | 演示：M2 之后如立项，用充电盒给眼镜充电、经 BLE 操作看板态、显示电量；检查输入回传与手机走同一协议。 | M2 |

### 2.11 制造与打样（HW-MFG）

| 编号 | 要求 | 来源 | 优先级 | 验证方法 | 阶段 |
| --- | --- | --- | --- | --- | --- |
| HW-MFG-01 | 主板优先评估一块 HDI 板（盘中孔 + 激光盲孔）；与“两块板靠板对板连接器叠起来”的方案比较厚度与成本后定案。M1 末取得 8 层 1 阶、10 层 2 阶两个版本的报价。 | 路线§1.12；S59、S61 | P0 | 检查：M1 末审阅两版报价、叠层与镜腿厚度估算，记录定案理由。 | M1 |
| HW-MFG-02 | 跨铰链的显示链路（MIPI / eDP）FPC 与天线馈线 FPC 必须阻抗受控，交给能做阻抗控制或软硬结合板的 FPC 厂；不支持 FPC 阻抗控制的通用打样厂只做非高速 FPC。 | 路线§1.12；S63 | P0 | 检查：审阅 FPC 厂书面能力答复与阻抗测试报告；测试：M2 测显示链路眼图或误码、铰链弯折后复测。 | M2 |
| HW-MFG-03 | 贴片选标准档工艺（最小 01005、BGA 间距 0.3 mm、带 X-ray）；主 SoC、蜂窝模组、DP 桥接芯片、光机、主摄模组按客供料送贴片（立创 / 嘉立创对部分料有封装条目但无现货），M1 结束前确认采购渠道。 | 路线§1.12；S62 | P0 | 检查：M1 末审阅核心料采购渠道清单；M2 首批贴片审阅 X-ray 报告。 | M1 |
| HW-MFG-04 | NDA 芯片的引脚、封装和参考设计不进公开仓库；公开的原理图和 PCB 对这些芯片只用占位。 | 路线§1.12；本文件§0.5 | P0 | 检查：每次推送公开仓库前核对硬件目录，确认没有 NDA 资料。 | M1 |

---

## 3 功耗、睡眠与续航（PWR）

| 编号 | 要求 | 来源 | 优先级 | 验证方法 | 阶段 |
| --- | --- | --- | --- | --- | --- |
| PWR-01 | 串流使用（1 h）整机平均功耗 ≤2.0 W，对应电量 2.0 Wh。 | 路线§1.9 | P0 | 测试：M2 整机按续航 P1 剖面串流 1 h，功耗分析仪积分取平均；同时记录温度和降频。 | M2 |
| PWR-02 | 视频通话/会议（0.5 h）整机平均功耗 ≤3.0 W，对应电量 1.5 Wh。 | 路线§1.9 | P0 | 测试：M2 整机按续航 P1 剖面通话 0.5 h，含虚拟形象和蜂窝上行，记录平均功耗。 | M2 |
| PWR-03 | 6DoF 叠加交互（0.5 h）整机平均功耗 ≤2.0 W，对应电量 1.0 Wh。 | 路线§1.9 | P0 | 测试：M2 整机按续航 P1 剖面跑 6DoF 叠加 0.5 h，记录平均功耗。 | M2 |
| PWR-04 | 轻度联网（3 h，通知、语音、间歇显示）整机平均功耗 ≤0.4 W，对应电量 1.2 Wh。 | 路线§1.9 | P0 | 测试：M2 整机按续航 P1 剖面跑轻度联网 3 h，记录平均功耗。 | M2 |
| PWR-05 | S0' 手表模式（1 h）整机平均功耗 ≤0.08 W，对应电量 0.08 Wh。 | 方案§5.1；路线§1.9 | P0 | 测试：验证计划第 4 组测手表模式平均功耗；M2 整机在续航 P1 剖面复测。 | M2 |
| PWR-06 | S1/S2（2 h）整机平均功耗 ≤0.08 W，对应电量 0.16 Wh。 | 路线§1.9 | P0 | 测试：M2 整机在 S1/S2 各测平均功耗，按 2 h 合计核对 0.16 Wh。 | M2 |
| PWR-07 | 续航 P1 剖面功耗预算合计约 5.9 Wh。 | 路线§1.9 | P0 | 分析：把 PWR-01–PWR-06 逐项相加，核对约 5.9 Wh；M2 用整机实测替换假设。 | M2 |
| PWR-08 | 续航 P1 混合使用剖面冻结为：串流 1 h、视频通话/会议 0.5 h、6DoF 叠加 0.5 h、轻度联网 3 h、手表模式 1 h、S1/S2 2 h，合计 8 h。 | 决定#17；方案§5.3 | P0 | 测试：M2 整机按六个时段连续执行 8 h，逐段记录功耗、电量和温度。 | M2 |
| PWR-09 | 机身 5–7 Wh 电池按续航 P1 剖面达到 8 小时；M2 整机 8 小时实测是续航最终闸门，不足时按 PWR-17 处理。 | 决定#15、#17；方案§5.3；路线§3 | P0 | 测试：M2 整机按 PWR-08 剖面跑满 8 h；未达标不得判 M2 出口通过。 | M2 |
| PWR-10 | S0 全功能：主处理器与协处理器工作，蜂窝/Wi-Fi 保持连接；功耗由串流、通话、6DoF 等负载决定。 | 方案§5.1 | P0 | 测试：M1 进入 S0，分别跑串流/通话/6DoF，记录主处理器、协处理器和射频功耗。 | M1 |
| PWR-11 | S1 浅睡（摘下/熄屏）：主 SoC 低功耗活跃（关屏、停解码、停追踪），控制连接由 Wi-Fi 芯片保活或蜂窝模组维持；戴上、触摸、按键唤醒；戴上后画面恢复 ≤1 s。 | 决定#1；方案§5.1 | P0 | 测试：M1 桌面/M2 整机触发 S1 后戴上，测戴上到画面恢复时间，至少 30 次取 p95；目标 ≤1 s。 | M1 |
| PWR-12 | S2 待机：主 SoC 挂起到内存；MCU 只跑佩戴检测、IMU、唤醒词；蜂窝 eDRX/PSM；Wi-Fi 关闭或低功耗；戴上、唤醒词、消息推送唤醒。 | 决定#1；方案§5.1 | P0 | 测试：M1 进入 S2，测唤醒源、唤醒时间和待机电流；M2 整机复测。 | M1 |
| PWR-13 | S3 深睡/运输：主 SoC 关闭，MCU 只留实时时钟，射频关闭；长按或充电唤醒；存放数周仍有电，具体时长待定（M1 定案）。 | 决定#1；方案§5.1 | P1 | 测试：M1 进入 S3 测静态电流和唤醒；M2 做存放数周的电量保持测试。 | M1 |
| PWR-14 | S1 会话保持：主 SoC 不完全挂起；服务端保留会话和最后一帧；醒来先显示缓存帧，再重连、等新关键帧；超过保活时间则断开重连。 | 方案§5.1、§5.2；路线§1.9 | P0 | 测试：M1 在 S1 保持会话，唤醒后检查缓存帧、重连和关键帧恢复；超时场景单独测。 | M1 |
| PWR-15 | 机身蜂窝休眠电流必须实测；eDRX/PSM 是否真正生效以电流波形出现与协商周期一致的休眠窗口为准，仅 AT 返回“已设置”不算生效。 | 方案§5.2；验证计划§3.5.1 | P0 | 测试：验证计划第 3 组用 µA 级功耗分析仪记录 PSM/eDRX 波形，覆盖至少 10 分钟和 ≥3 个周期。 | M1 |
| PWR-16 | 自研串流服务加入后台白名单，避免熄屏断网或后台服务被杀；验收必须覆盖这一点。 | 方案§5.2 | P0 | 测试：M1 熄屏/切后台后保持串流控制连接，确认服务不被杀、唤醒可回连。 | M1 |
| PWR-17 | 实测超预算时先压功耗（降刷新率、追踪帧率、调蜂窝策略）；仍不够再按决定#19把电池加到 8–10 Wh，全部放耳后；不得放宽 8 小时指标。 | 方案§5.3；路线§1.9 | P0 | 分析：M2 用实测功耗代入预算，按“先压功耗、再加电池”的顺序出方案；检查是否擅自放宽 8 h。 | M2 |
| PWR-18 | 新增看板态低功耗通路：只显示看板时，主 SoC 只做“按描述画卡片 + 重投影”，降刷新率、关解码、关追踪；只有气泡时走 MCU 现有低速显示通路，主 SoC 可睡。 | 决定#24；方案§5.4；路线§1.9 | P0 | 测试：按验证计划第 4 组“看板态功耗”分别测只看板、只气泡、看板 + 气泡三种状态的主 SoC / MCU 电流和上屏延迟。 | M1 |
| PWR-19 | 按新使用方式重算功耗剖面：新增看板（预计时长最多）、实时拍照 / 识别（摄像头上行 + ISP）、气泡待机；调低串流 / 视频时长。具体时长和功耗待定（M1 定案），不得先填数字。 | 决定#24；方案§5.5；路线§1.9 | P0 | 分析：M1 用实测值填新剖面；检查是否与旧剖面混用、是否出现未标注来源的数字。 | M1 |
| PWR-20 | 5–7 Wh 是否够按决定 #19 重新核算：新剖面替代旧续航 P1 剖面做预算；不足时先压功耗，再按续航优先加电池到 8–10 Wh。旧剖面已算好的数字不改，作为对照保留；M1 定案前旧剖面仍是验收口径。 | 决定#19、#24；方案§5.3、§5.5；路线§1.9 | P0 | 分析：M1 用新剖面重算电量，给出“够 / 不够 / 待定”结论；不够时按 PWR-17 处理。 | M1 |

---

## 4 显示与延迟（DISP）

| 编号 | 要求 | 来源 | 优先级 | 验证方法 | 阶段 |
| --- | --- | --- | --- | --- | --- |
| DISP-01 | A1 有线原始画面延迟预算：编码无；传输线路级；解码无；重投影 + 显示 ≤5 ms；头动感知延迟由本地追踪 + 重投影决定。 | 方案§3.5 | P0 | 测试：验证计划第 1 组用高速相机/光电传感器测 A1 显示链路；运动到光子按第 1 组方法测。 | M1 |
| DISP-02 | A2 有线编码延迟预算：编码 ≤5 ms；传输 ≤2 ms；解码 ≤5 ms；重投影 + 显示 ≤5 ms。 | 方案§3.5 | P0 | 测试：第 1 组用 USB 网络 + Moonlight 近似 A2，逐环节记录；结论标注“近似，不外推为 A2 已验证”。 | M1 |
| DISP-03 | B Wi-Fi 7 延迟预算：编码 ≤5 ms；传输 ≤5 ms（p95）；解码 ≤5 ms；重投影 + 显示 ≤5 ms。 | 方案§3.5 | P0 | 测试：第 1 组在 Wi-Fi 链路逐环节测 p50/p95，至少 30 个样本；30 分钟看 p95 漂移和降频。 | M1 |
| DISP-04 | C 蜂窝延迟预算：编码 ≤5 ms；传输依网络、待测；解码 ≤5 ms；重投影 + 显示 ≤5 ms。 | 方案§3.5 | P0 | 测试：第 1 组/第 3 组在强弱信号下测蜂窝链路，传输段单独记录，不把 RTT 当端到端内容延迟。 | M1 |
| DISP-05 | 头动感知延迟与网络延迟解耦：叠加内容不随网络抖动漂移；端到端内容延迟合计阈值待定（M1 定案），不得把各环节预算相加冒充实测总延迟。 | 方案§3.5；验证计划§1.6 | P0 | 测试：用转台/头模给角运动阶跃，测运动到光子；内容延迟按 p50/p95 记录，M1 定合计阈值。 | M1 |

---

## 5 网络指标（NET）

| 编号 | 要求 | 来源 | 优先级 | 验证方法 | 阶段 |
| --- | --- | --- | --- | --- | --- |
| NET-01 | 云串流（1080p60，H.265/AV1）：下行持续 ≥30 Mbps、上行持续 ≥2 Mbps、RTT p95 ≤50 ms，三项同时满足。 | 方案§6.3 | P0 | 测试：验证计划第 3 组强/弱信号各测 60 s 持续下行/上行和 RTT p95（≥300 样本）；M2 整机复测。 | M1 |
| NET-02 | 视频通话/会议（1080p30 上行）：下行持续 ≥5 Mbps、上行持续 ≥5 Mbps、RTT p95 ≤100 ms，三项同时满足。 | 方案§6.3 | P0 | 测试：第 3 组按通话档测持续速率和 RTT；第 5 组在真实通话软件上复验。 | M1 |
| NET-03 | 串流 + 通话并发：下行持续 ≥35 Mbps、上行持续 ≥8 Mbps、RTT p95 ≤50 ms（取较严的云串流值）。 | 方案§6.3 | P0 | 测试：第 3 组做双向并发 60 s，同时记录下行、上行、RTT p95 和丢包；M2 整机复测。 | M1 |
| NET-04 | 三档都必须同时看下行、上行、RTT，不用单一速率指标代替；以 60 s 持续速率和 p95 RTT 为准，峰值只作参考，强/弱信号分别报告。 | 方案§6.3；验证计划§3.5.5、§3.8 | P0 | 分析：逐档核对三项指标；检查报告是否用峰值或最好一次代替持续值。 | M1 |
| NET-05 | 弱信号下是否允许降级、降级后是否仍算满足方案 §6.3，待定（M1 定案）；弱信号结果单独报告，不与强信号混合。 | 验证计划§3.5.5 | P0 | 检查：M1 评审弱信号数据和降级策略，形成书面结论；未定案前不得宣称弱信号达标。 | M1 |

---

## 6 眼镜端软件（SW）

| 编号 | 要求 | 来源 | 优先级 | 验证方法 | 阶段 |
| --- | --- | --- | --- | --- | --- |
| SW-01 | 眼镜主 SoC 系统采用 SoC 厂商 BSP 中的 AOSP；Android XR 仅在取得合作资格后评估，不作为 v0.2 前提。 | 路线§2.1 | P0 | 检查：核对 BSP 的 Android/内核版本和开发者资格；确认系统镜像能在目标开发板启动。 | M1 |
| SW-02 | 自研空间合成器：把各路串流、本地卡片、通话画面作为虚拟屏锚定在真实空间，交显示处理器上屏。 | 路线§2.1 | P0 | 演示：M1 在桌面样机摆放多块虚拟屏、本地卡片和通话画面，检查空间锚定和上屏。 | M1 |
| SW-03 | OpenXR 运行时用厂商方案；备选基于 Monado；Monado 追踪仍标实验性，移植到眼镜 SoC 的工作量另评。 | 路线§2.1、§1.7 | P1 | 测试：M1 跑厂商 OpenXR 运行时和一个最小 OpenXR 场景；备选方案只做可行性评估。 | M1 |
| SW-04 | 串流客户端支持硬解、最新帧优先、关键帧恢复。 | 路线§2.1 | P0 | 测试：M1 在丢包/抖动下验证最新帧优先和关键帧恢复，记录恢复时间。 | M1 |
| SW-05 | 当前版本虚拟形象驱动不用眼动：本地用语音驱动口型与表情，并结合 IMU / 6DoF 头部姿态；眼动软件只保留接口定义，不开发。后续版本启用眼动时，眼部图像仍只在本地处理，只上传参数。 | 决定#20；路线§2.1；方案§3.8 | P0 | 测试：M1 用语音和头部姿态驱动虚拟形象，检查口型、表情和点头/转头；检查眼动仅有接口定义、无驱动实现。 | M1 |
| SW-06 | 兼容层包含 L3 看板（语义卡片）渲染、L4 看板兜底（像素 / 图片）接收端。 | 路线§2.1；方案§4.2 | P1 | 测试：M2 用可读界面结构的应用和只能画面捕获的应用各测一条路径。 | M2 |
| SW-07 | 特殊投屏算法：主机渲染 + 视频 + 眼镜薄解码；ROI 在原始分辨率上先裁剪再缩放；不在眼镜做重渲染。 | 方案§4.1 | P0 | 演示：M1 演示主机渲染、眼镜薄解码和 ROI 局部放大，确认眼镜不做重渲染。 | M1 |
| SW-08 | 串流纪律：只保留最新帧；同时只有一块数据在传；对端忙丢帧不排队；回执逐项核对累计值；采集、编码、发送、解码、上屏分别计数；不以“已发送”当成“已显示”；断流不显示花屏，等关键帧恢复。 | 方案§4.1 | P0 | 测试：M1 在人为拥塞/丢包下检查丢帧不排队、逐环节计数和关键帧恢复；检查诊断记录。 | M1 |
| SW-09 | 语义转化为主、像素转化为兜底；导航、字幕、状态等矢量与画面分开，眼镜本地绘制，视频断开时仍能显示。 | 方案§4.1 | P0 | 演示：M1 断开视频面，确认导航/字幕/状态仍由本地绘制显示。 | M1 |
| SW-10 | 兼容分层以 L0 系统级虚拟显示器为主路（对应投屏 / 接管），L1 OpenXR、L2 标准投屏 / 车机协议、L3 看板、L4 看板兜底按场景使用。 | 方案§4.2 | P0 | 测试：M1 按 L0 主路跑软件类别清单；其他层只做对照，不混入同一通过率。 | M1 |
| SW-11 | DRM/HDCP 内容、反作弊、安全窗口为已知边界，不承诺可用、不绕过。 | 方案§4.2 | P0 | 检查：核对兼容清单中的“预期失败”项和测试记录，确认没有绕过尝试。 | M1 |
| SW-12 | 诊断以 JSON 记录各环节计数与时间戳，不保存画面内容。 | 方案§4.3 | P0 | 检查：抓取诊断日志，确认字段含计数/时间戳、无画面内容；检查日志脱敏。 | M1 |
| SW-13 | 兼容率按“软件类别清单 + 实测通过率”衡量；具体通过率待定（M1 定案）。 | 方案§4.2；验证计划§1.5.6 | P1 | 测试：第 1 组按办公、开发、影音、游戏、手机应用、安全窗口分类测通过/部分通过/失败/预期失败；M1 定通过率。 | M2 |
| SW-14 | 小脑调度器：维护六种显示模式的状态机，决定谁产出、谁上屏、何时出现；同屏最多 1 个主显示 + 最多 2 个气泡（30–50° 视场）【设计目标】。 | 决定#23；方案§3.9 | P0 | 演示：M1 在桌面样机依次进入六种模式，检查状态机和同屏数量。 | M1 |
| SW-15 | 六种显示模式：看板（含气泡）、图片、视频、投屏、实时拍照、视频通话；各模式的产出方、上屏方、出现条件和链路按方案 §3.9 表。投屏只在用户要求接管时出现。 | 决定#23；方案§3.9 | P0 | 演示：M1 逐模式跑通；检查投屏只在接管时出现，不默认打开。 | M1 |
| SW-16 | 显示优先级：视频通话 > 投屏（接管）> 视频 > 实时拍照 > 看板 > 气泡；高优先级到来时，低优先级缩到边上或收成气泡。 | 决定#23；方案§3.9 | P0 | 演示：M1 从低到高逐级触发，记录缩边 / 收气泡行为；检查没有同时出现两个主显示。 | M1 |
| SW-17 | 气泡 → 看板 → 投屏就地变形，不关一个再开一个；焦点跟语音走，说到哪张哪张到前面。 | 决定#23；方案§3.9 | P0 | 演示：M1 走“打开 QQ”典型流程，检查气泡变看板、看板变投屏的连续性和焦点切换。 | M1 |
| SW-18 | 检测到行走时主显示缩小移到边缘，不遮挡前方；行走检测用 IMU / 6DoF，不新增专用传感器。 | 决定#23；方案§3.9 | P0 | 演示：M1 在行走台架或佩戴状态下触发，检查主显示缩边和恢复。 | M1 |
| SW-19 | 安全页黑屏：投屏中遇到付款、密码等安全页，眼镜上显示黑屏并提示到手机上处理；不在眼镜上渲染、不采集、不转发。 | 决定#23；方案§3.9；SEC-06 | P0 | 演示：M1 在投屏中打开安全页，确认黑屏提示、手机侧可继续；检查没有画面留痕。 | M1 |
| SW-20 | 看板描述光栅化：小脑按手发来的描述（文字、头像、按钮、布局）本地画卡片；描述表达不了时显示手发来的图片兜底；KB 级描述优先，不默认传整屏像素。 | 决定#22、#23；方案§3.9、§4.1 | P0 | 测试：M1 用手机发一条描述和一条兜底图片，检查光栅化结果、带宽和断网时已缓存看板的显示。 | M1 |
| SW-21 | 脑的端侧部分：眼镜上提供语音（唤醒词后）与手势的意图入口，把意图交给云端 LLM；按手的能力位和脚的可达性生成派手决定（发给哪只手、用手协议的哪个目标），显示决定交给小脑调度器执行；派手与显示两类决定分别写审计记录，不记录画面内容。断网时只保留端侧极小意图集（时间、拍照、录像、录音）。 | 决定#6、#22、#25；方案§1.1、§3.9 | P1 | 演示：M1 走通“打开 QQ”全流程，检查意图 → 派手 → 看板 → 确认 → 发送各步的审计记录；断网时检查只剩端侧意图集。 | M1 |
| SW-22 | 多路信号调度：实时视频只解 1 路全帧率（主显示），被挤到边上或收成气泡的流改用手发来的低帧率缩略图图层；主摄一次采集分给取景、识别、通话编码；IMU 同时供显示处理器与主 SoC；多只手可同时连接，视频会话同一时刻只服务主显示的那只手。 | 方案§3.9、§3.11 | P0 | 演示：M1 投屏中来视频通话，检查投屏降为缩略图、通话成为主显示、全帧率解码不超过 1 路；主摄同时供取景与通话。 | M1 |
| SW-23 | 投屏处理链路与操作回传：投屏图层支持 ROI、对比度适配、空间锚定与安全页黑屏；手势指针、点击、滚动、文字转成带时间戳与帧序号的输入事件经控制面回传，按眼镜所见帧坐标换算回虚拟显示坐标；有线时可作为 USB HID。操作回传延迟阈值待定（M1 定案）。 | 方案§4.5 | P0 | 测试：M1 在 PC 投屏上点选、滚动、输入文字，测“手势到主机画面变化”的延迟（p50 / p95，≥30 样本）；检查坐标换算误差。 | M1 |
| SW-24 | 头姿与时间对齐：IMU 方向进环形缓冲（球面插值），能求「任一帧拍下时 → 现在」的头部旋转，供重投影和锚定使用；相机–IMU 时间偏移用陀螺角速度与图像运动互相关估计；新板上线先做轴向三步自检（转头 / 点头 / 歪头）。 | 原型经验§3.4；路线§1.7、§2.4 | P0 | 测试：M1 用转头样本核对轴向；估计时间偏移并与人工标注比对；把旋转喂给重投影，对比有 / 无时间对齐时的画面抖动。 | M1 |
| SW-25 | 显示–相机标定：佩戴者对准屏上若干点，求焦距、主点、旋转、平移（DLT 初值 + Huber 鲁棒 LM，主点弱先验，剔除离群点）；标定结果用于把相机坐标里的框、圈、专家标注换算到显示坐标，消除相机与人眼视差。双目各标一次。 | 原型经验§3.4；路线§2.4 | P1 | 测试：M1 每人标定后在 0.5 / 1 / 2 m 放标记，测叠加框与实物的偏差；记录重标定频率。 | M1 |
| SW-26 | 采集质量门：自动拍照或上传前先判模糊、再判遮挡（模糊在任何模式下都不合格）；陀螺静止门判定头部稳定后才触发自动拍；轻量对准用 CLAHE 光照归一化 + ORB 特征 + 单应投影，作为厂商感知栈之外的备选（看板态、主 SoC 睡眠时）。 | 原型经验§3.1–3.3；路线§2.4 | P1 | 测试：M1 用糊图、遮挡、晃动样本集测误拍率与漏拍率；在不同光照下测对准成功率。 | M1 |
| SW-27 | 结果来源与 Agent 边界：每个识别或结果标明「实时 / 含模拟 / 预录」，AI 只出「候选」由人确认；接入的 Agent 只能说文字、显示卡片、结束、继续听，不能直接拍照、发消息、改设置；一句话一个请求，绝不自动重试；有超时时限，超时留在当前步骤并给出明确备选，不静默替换。 | 原型经验§3.1、§4、§5；方案§1.1；路线§2.4 | P0 | 检查：审阅看板卡片与日志的来源字段；测试：模拟 Agent 返回操作指令、超时与失败，确认眼镜不执行、不重试、提示清楚。 | M1 |

---

## 7 主机侧软件（HOST）

| 编号 | 要求 | 来源 | 优先级 | 验证方法 | 阶段 |
| --- | --- | --- | --- | --- | --- |
| HOST-01 | 主机侧统一串流服务覆盖 PC、手机、车机、云，使用同一套协议；不是四套互不兼容的实现。 | 决定#4；方案§3.4；路线§2.1 | P0 | 检查：核对四类主机的服务端代码/配置和协议版本；M1 按路线 §2.2 表逐格跑通，M2 整机复验。 | M1 |
| HOST-02 | 四类主机虚拟显示：Windows 间接显示驱动（IddCx）、Linux 合成器、Android VirtualDisplay、macOS 扩展显示。 | 路线§2.1 | P0 | 测试：M2 逐平台安装虚拟显示驱动，确认眼镜作为显示器/虚拟屏出现。 | M2 |
| HOST-03 | 编码与发送调用硬件编码（NVENC/AMF/QSV/手机硬编），并实现方案 §4.1 的串流纪律。 | 路线§2.1 | P0 | 测试：M1 在 PC 上分别用 NVENC/AMF/QSV 编码，核对丢帧不排队和逐环节计数。 | M1 |
| HOST-04 | OpenXR 运行时在主机侧做远端渲染，供 L1 空间应用使用。 | 路线§2.1 | P1 | 测试：M1 用 ALVR/WiVRn 或厂商运行时跑一个 OpenXR 场景，记录延迟和稳定性。 | M1 |
| HOST-05 | V1 通话接入：虚拟摄像头 + 虚拟麦克风驱动；有线时眼镜本身作为标准 UVC/UAC 设备。 | 路线§2.1、§2.2 | P0 | 测试：第 5 组在 PC 上验证虚拟摄像头/麦克风被通话软件识别；有线 UVC 单独测。 | M1 |
| HOST-06 | 虚拟形象渲染在主机/云 GPU 上完成，输出一路视频；V1 作为虚拟摄像头，V2/V3 作为视频轨。 | 路线§2.1；方案§3.8 | P0 | 测试：第 5 组用 Audio2Face 类链路渲染并接入通话软件，检查 V1 和 V2/V3 两种输出。 | M1 |
| HOST-07 | 主机发现与切换：有线 > 同局域网 > 云；断线后自动回到上次主机。 | 方案§3.4；路线§2.3 | P0 | 演示：M1 同时提供有线和 Wi-Fi 主机，断开当前链路，确认按优先级切换并回连。 | M1 |
| HOST-08 | 四类主机通话主路：PC V1；手机 V2/V3；车机 V2；云 V3；任何通话软件至少有一条能走通的路径。V1 实测清单含微信 PC、腾讯会议、Teams、Zoom；全走不通的软件列入兼容清单并向需求方说明。 | 路线§2.2；验证计划第 5 组 | P0 | 测试：第 5 组逐软件测 V1；手机/车机/云按主路补测；M2 整机复验。 | M2 |
| HOST-09 | L2 标准投屏/车机协议接收端作为可选补充，不替代 L0 主路；协议授权、认证硬件和厂商条款须另行确认，本仓库不提供这类实现。 | 方案§4.2 | P2 | 检查：只做协议可行性与授权边界评审，不在本仓库实现或分发受限制的协议代码。 | M2 |
| HOST-10 | 手机这只手主选参考 Mika（Apache-2.0，Kotlin）的改造版：用虚拟显示后台操作、无障碍树读屏、目标化输入注入、统一执行入口（守卫 → 锁屏检查 → 不可逆检查 → 确认）；提供远程 MCP / REST 任务接口（发目标、查状态、等待、回答、引导、取消）。 | 决定#22；方案§3.10 | P0 | 检查：审阅 Mika 改造方案、许可证和远程接口清单；演示：M1 手机后台打开一个应用并生成看板。 | M1 |
| HOST-11 | 眼镜通道：Mika 没有蓝牙，在其 Channel 接口挂一个“眼镜通道”，用 BLE 发意图、气泡、看板描述；必要时走蓝牙 PAN 或 Wi-Fi 到 Mika 的局域网接口；视频 / 投屏走 Wi-Fi。 | 决定#22、#24；方案§3.10；路线§2.3 | P0 | 测试：M1 用 BLE 发一条意图和一条看板描述，确认 Mika 收到并回状态；再测 Wi-Fi 视频。 | M1 |
| HOST-12 | 安全：发消息前也要在眼镜上确认（Mika 的 ask 模式只在付款前问，需加强）；远程发起的任务不能批准付款和确认；付款、密码页只在手机上完成。 | 决定#22；方案§3.10；SEC-06 | P0 | 演示：M1 远程发起发消息任务，确认眼镜上出现确认；尝试远程批准付款 / 确认，确认被拒。 | M1 |
| HOST-13 | 手侧的多路合一：PC 多块虚拟屏打包成一路视频并附每块位置信息；多人通话宫格由主机或云合成一路；被降级的流改发低帧率缩略图；按输入回传事件在虚拟显示上注入输入。 | 方案§3.11、§4.5 | P1 | 演示：M1 PC 开三块虚拟屏，眼镜只解一路并拆成三层分别锚定；会议多人宫格只解一路。 | M1 |

---

## 8 开放协议（PROT）

| 编号 | 要求 | 来源 | 优先级 | 验证方法 | 阶段 |
| --- | --- | --- | --- | --- | --- |
| PROT-01 | 串流会话控制面：能力位握手（分辨率、刷新率、编码格式、追踪模式）；主机发现与切换，顺序为有线 > 局域网 > 云；传输用 QUIC 可靠流，或 TCP + TLS。 | 方案§4.3；路线§2.3 | P0 | 测试：M1 用协议一致性用例测握手、能力位和主机切换；抓包确认传输类型。 | M1 |
| PROT-02 | 视频面必须走不可靠传输：QUIC DATAGRAM（RFC 9221）或 RTP/UDP；按帧可选前向纠错，不做整帧重传；不能用 QUIC 的普通流，普通流可靠有序会被队头阻塞，违背“最新帧优先”。 | 路线§2.3 | P0 | 测试：M1 抓包确认视频面为 DATAGRAM/RTP/UDP；人为丢包下验证不重传整帧、不队头阻塞。 | M1 |
| PROT-03 | 姿态上行：6DoF 姿态 + 时间戳，供主机做预测渲染；和视频面一样走不可靠传输，单独作为高频小包通道。 | 路线§2.3 | P0 | 测试：M1 抓包确认姿态通道独立、不可靠、带时间戳；测高频小包吞吐和丢失行为。 | M1 |
| PROT-04 | 时钟同步：类似 NTP 的往返测量，持续估算主机与眼镜时钟偏差；精度目标在 M1 用实测确定。 | 路线§2.3 | P0 | 测试：M1 做往返测量，记录偏差分布；M1 评审确定精度目标。 | M1 |
| PROT-05 | 矢量通道：导航、字幕、状态、L3 看板走控制面，由眼镜本地绘制。 | 路线§2.3；方案§4.3 | P0 | 测试：M1 断开视频面，确认矢量通道仍能更新并在本地绘制。 | M1 |
| PROT-06 | 同步接口：上传目标插件走 HTTPS；只传用户选中的内容，记录同步日志，失败可重试。 | 路线§2.3；方案§2.4 | P0 | 测试：M1 用 WebDAV/S3 插件各跑一次上传、失败重试和日志检查。 | M1 |
| PROT-07 | 小程序分发：签名包 + 权限清单，走 HTTPS。 | 路线§2.3 | P0 | 测试：M1 分发一个签名包和一个未签名包，确认未签名被拒、权限清单随包生效。 | M1 |
| PROT-08 | 控制面和视频面至少要分开拥塞控制，避免视频突发把按键和模式切换拖慢。 | 路线§2.3 | P0 | 分析：M1 在视频面拥塞时测控制面按键/模式切换延迟，确认不受视频突发拖累。 | M1 |
| PROT-09 | 协议规范和参考实现一起公开；官方云与自建服务端用同一份规范；用一致性测试套件验证第三方实现。 | 路线§2.3；方案§4.4 | P0 | 检查：审阅公开的规范、参考实现和一致性测试套件；用套件跑一遍参考实现。 | M1 |
| PROT-10 | 协议 v0 在 M1 冻结。 | 路线§2.3、§3 | P0 | 检查：核对 M1 出口的协议版本、变更记录和冻结评审记录。 | M1 |
| PROT-11 | 视频面“最新帧优先 + 关键帧恢复 + 自适应码率”；Wi-Fi 与蜂窝下按 p95 延迟动态降分辨率或帧率。 | 方案§4.3；路线§2.3 | P0 | 测试：M1 在 Wi-Fi/蜂窝弱网下测码率/分辨率/帧率调整和关键帧恢复。 | M1 |
| PROT-12 | 看板描述 v0：手 → 小脑的结构化描述，含版本、看板 ID、元素类型（文本 / 图片 / 按钮 / 列表）、布局约束、增量 / 整版更新、过期时间、兜底图片引用；默认不传整屏像素。 | 决定#22；方案§3.9、§4.1；路线§2.3 | P0 | 检查：审阅 v0 规范和一致性用例；测试：M1 用手机和小脑各实现一份，互通一条看板。 | M1 |
| PROT-13 | 手协议 v0：发目标、查状态、等待、回答、引导、取消；含任务 ID、状态机、能力位、确认请求和审计字段；远程任务只能请求确认，不能代替用户批准付款 / 密码。 | 决定#22；方案§3.10；路线§2.3 | P0 | 检查：审阅协议草案；测试：M1 用 MCP / REST 发一个任务，走完状态机和确认边界。 | M1 |
| PROT-14 | BLE 控制面：低功耗常连，承载意图、气泡、看板描述；主 SoC 睡眠时由 MCU 收；视频 / 投屏不走 BLE。与串流控制面 / 视频面分离一致。 | 决定#22、#24；方案§3.10、§4.3；路线§2.3 | P0 | 测试：M1 抓包确认 BLE 只承载控制面；主 SoC 睡眠时仍能收气泡；视频走 Wi-Fi。 | M1 |
| PROT-15 | 输入回传通道：投屏接管时小脑 → 手的输入事件（指针、点击、滚动、按键、文字），带时间戳与帧序号；走控制面可靠传输，不走视频面；v0 字段在 M1 冻结。 | 方案§4.5；路线§2.3 | P0 | 检查：协议 v0 文档含字段定义；测试：视频面拥塞时输入事件仍按序送达。 | M1 |
| PROT-16 | 脚的带宽优先级：控制面与姿态 > 音频 > 通话视频 > 投屏 / 视频 > 同步上传；Wi-Fi 下用 WMM 队列，蜂窝下按码率自适应；视频突发不得拖慢控制面。 | 方案§3.11、§4.3 | P1 | 测试：M1 在受限带宽下同时跑投屏、通话和同步上传，检查控制面与音频不受影响、投屏先降码率。 | M1 |

---

## 9 视频通话与虚拟形象（CALL）

| 编号 | 要求 | 来源 | 优先级 | 验证方法 | 阶段 |
| --- | --- | --- | --- | --- | --- |
| CALL-01 | 视频通话拉满：像正常手机视频电话、视频会议一样，包括投屏视频；不是只做语音或单向视频。 | 决定#12；方案§3.7 | P0 | 演示：M2 用主流通话软件完成双向视频、会议和投屏视频，按手机通话体验对照。 | M2 |
| CALL-02 | 看对方：来电视频和会议画面作为虚拟屏锚定在空间里，可放大、多人宫格。 | 方案§3.7 | P1 | 演示：M1 把通话画面锚定在桌面，演示放大和多人宫格。 | M1 |
| CALL-03 | 让对方看到我所见：眼镜前向摄像头作为通话摄像头，第一人称视角。 | 方案§3.7 | P0 | 演示：M1 把前向摄像头画面接入通话，对端确认看到第一人称视角。 | M1 |
| CALL-04 | 让对方看到我本人：默认使用虚拟形象；也可手动切换为主机摄像头。眼镜看不到佩戴者的脸，不能假装是真人人脸画面。 | 决定#13；方案§3.7、§3.8 | P0 | 测试：M1 默认虚拟形象通话，手动切主机摄像头；检查角标和切换行为。 | M1 |
| CALL-05 | 共享画面：共享眼镜里的任一虚拟屏，或“真实画面 + 叠加内容”的合成画面（投屏视频）。 | 方案§3.7 | P0 | 演示：M1 在通话中共享虚拟屏和合成画面，对端确认可见。 | M1 |
| CALL-06 | 通话音频与会议控制：多麦克风波束成形、降噪、回声消除；开放式扬声器；接听、挂断、静音、切摄像头、举手可用手势、语音、按键完成。 | 方案§3.7 | P0 | 测试：第 5 组测音频；M1 演示三种控制方式，记录误触和成功率。 | M1 |
| CALL-07 | V1 主机通话：通话软件在 PC 运行（手机主路为 V2 / V3，见 HOST-08），画面经 L0 虚拟显示器到眼镜；眼镜摄像头和麦克风注册为主机设备；有线 UVC，无线由主机端虚拟摄像头/虚拟音频驱动接收。 | 方案§3.7；路线§2.2 | P0 | 测试：第 5 组在 PC 上逐软件测虚拟摄像头/麦克风；手机 V1 可行性单独记录。 | M1 |
| CALL-08 | V2 眼镜独立通话：本地运行 WebRTC 通话客户端，直接经蜂窝或 Wi-Fi 通话，不需要主机。 | 方案§3.7；路线§2.1 | P0 | 测试：M1 用 WebRTC 客户端经蜂窝/Wi-Fi 通话，记录建立时间、延迟和断线恢复。 | M1 |
| CALL-09 | V3 云端通话：通话软件在云端主机运行，经蜂窝串流到眼镜，眼镜摄像头和麦克风回传云端。 | 方案§3.7；路线§2.2 | P0 | 测试：M1 用云主机跑通话软件，经蜂窝串流，验证上下行和延迟。 | M1 |
| CALL-10 | 上行视频 1080p30 起；弱网自动降到 720p/480p 保持流畅；音频优先于视频。 | 方案§3.7 | P0 | 测试：第 5 组限速到上行 2 Mbps、1 Mbps，记录分辨率、卡顿、断线和恢复。 | M2 |
| CALL-11 | 口到耳延迟和画面延迟按主流视频通话体验设定；具体阈值待定（M1 定案），M1 测基线并测一组普通手机视频通话对照。 | 方案§3.7 | P0 | 测试：第 5 组用拍手 + 双端录音、毫秒计时器测口到耳/画面延迟，p50/p95；M1 定阈值。 | M1 |
| CALL-12 | 通话 + 串流 + 6DoF + 蜂窝上行并发时不降频、不过热；这是整机最重负载，必须作为验收主场景。 | 方案§3.7 | P0 | 测试：M2 整机并发跑通话、串流、6DoF 和蜂窝上行，记录帧率、功耗、温度和降频。 | M2 |
| CALL-13 | 虚拟形象建模：首次用手机摄像头扫描或选模板生成本人形象；只允许本人或卡通形象，不允许用他人形象；画面角标注明“虚拟形象”。 | 方案§3.8 | P0 | 演示：M1 走完建模/模板、角标显示；检查是否允许导入他人形象。 | M1 |
| CALL-14 | 虚拟形象驱动信号：语音驱动口型与表情、6DoF/IMU 头姿；手势为可选。当前版本不用眼动，眼神、眨眼由语音驱动模型或程序化动画补足。 | 决定#20；方案§3.8 | P0 | 测试：M1 用语音和头部姿态驱动，逐项检查口型、表情、点头/转头和眨眼补足效果；确认未使用眼动。 | M1 |
| CALL-15 | 虚拟形象渲染：在主机或云端 GPU 上渲染为一路视频；V1 注册为主机虚拟摄像头，V2/V3 作为通话视频轨。 | 方案§3.8；路线§2.1 | P0 | 测试：第 5 组分别测 V1 虚拟摄像头和 V2/V3 视频轨。 | M1 |
| CALL-16 | 眼动隐私约束（预留）：当前版本不采集眼动图像；预留接口定义明确眼动图像只在本地处理，只上传眼动、头姿等轻量参数，不上传眼部图像；音频照常上传。 | 决定#20；方案§3.8；路线§2.1 | P0 | 检查：审阅预留接口定义，确认隐私约束写入；确认当前版本无眼动图像采集和上行。 | M1 |
| CALL-17 | 通话软件的端到端加密、账号、录制和第三方平台规则由各软件自身决定；V1 虚拟设备限制按清单实测，个别软件限制记录为已知边界。 | 方案§3.8 | P1 | 检查：核对兼容清单和测试记录；不承诺替第三方解密、录制或绕过平台规则。 | M2 |
| CALL-18 | 没有可用 GPU 主机或云时，虚拟形象降级为静态头像 + 口型动画；降级不改变“虚拟形象”标识和隐私边界。 | 方案§3.8；路线§2.1 | P2 | 演示：M2 断开 GPU 渲染，确认自动降级为静态头像 + 口型，角标仍显示。 | M2 |
| CALL-19 | 通话弱网自适应细化 CALL-10：按丢包、RTT、CPU、带宽估计分档降级，立即降、稳升（连续 3 次良好才升，降档后 20 秒内不升），起步不取最低档以免锁死；走 TCP 中继或过热时封顶；最低档仍差 10 秒转纯语音，不冻屏；ICE 断开 3 秒重启，信令自动重连；UI 线程不碰网络和编解码；眼镜只订阅一路远端视频。 | 原型经验§2.2–2.3；路线§2.4 | P0 | 测试：第 5 组按限速、丢包、延迟脚本逐级加压，记录档位变化、恢复时间、卡顿合计；5 分钟基线：进房与首帧 ≤ 3 s、卡顿合计 ≤ 1 s、丢包 ≤ 1%（原型基线，M1 按本机重定）。 | M1 |
| CALL-20 | 会议入会：会议编号（8 位，4-4 显示）与真实房间号分离；进房票据每次现签、短时效，上行权限写在票据里；编号有有效期与防爆破限速；眼镜入会支持扫码、说编号（离线识别后单击确认）、最近邀请三种；不开云端录制，只记编号、成员、进出时间与角色。媒体层「一条托管 RTC 主路线 + 一条会议应用保底」。 | 原型经验§2.1、§2.4；路线§2.4 | P1 | 测试：M1 三种入会方式各 10 次成功率与耗时；过期编号、错误编号、超人数被拒；检查日志无音视频内容。 | M1 |
| CALL-21 | 第一视角投屏（眼镜 → 观看端）：默认关闭，佩戴者开启；扫码 + PIN 配对，最多 3 个观看者，PIN 限速，30 分钟或退出自动关闭；无人观看不编码；只发最新帧不积压；分析优先——端侧分析帧率下降超过 15% 时先降投屏帧率、再降分辨率，分析档位不降。 | 原型经验§1；方案§3.7；路线§2.4 | P1 | 测试：按原型经验 §1.4 六项验收：玻璃到玻璃延迟 p50/p95、拥塞恢复、熄屏摘下折叠、1 / 3 人对分析帧率影响、30 分钟功耗温度、错 PIN 与第 4 人。 | M1 |
| CALL-22 | 远程专家标注回传：专家在观看页圈画、选预设短句，眼镜 HUD 显示圈和句子 8 秒并播语音；佩戴者单击暂停 / 恢复；摘下、折叠、离开时禁用，恢复后不重播旧标注；圈画坐标经 SW-25 标定换算，未标定时标注「位置为近似」；作为投屏图层的叠加层实现（HW-DP-07 扩展）。 | 原型经验§1.3；方案§4.5；路线§2.4 | P1 | 测试：M1 圈画位置偏差、8 秒消失、暂停恢复、摘下后不重播；与 DP 层 + 气泡层同时叠加。 | M1 |

---

## 10 手表模式与小程序、同步接口（APP）

| 编号 | 要求 | 来源 | 优先级 | 验证方法 | 阶段 |
| --- | --- | --- | --- | --- | --- |
| APP-01 | 手表模式内置程序至少包括：时钟/闹钟/计时/秒表、相机、录音/语音备忘、提词卡/离线备忘、离线扫码（只识别并显示内容，不打开网址）、状态（电量、存储、网络、待同步数量）。 | 方案§2.3；决定#7 | P0 | 演示：M1 在 MCU 开发板上逐项运行内置程序，检查离线可用和资源占用。 | M1 |
| APP-02 | 第三方小程序运行在 MCU 受限运行时；WebAssembly（如 WAMR）与 Lua 都支持，共用同一套权限、签名和设备接口，并对开发者开放 SDK、文档和模拟器。 | 决定#14；方案§2.3 | P0 | 测试：第 4 组用 WebAssembly 和 Lua 各实现计时器/清单小程序，验证启动、内存和权限。 | M1 |
| APP-03 | 小程序沙箱限制：不能联网；内存、存储、CPU 时间有上限；摄像头和麦克风需用户每次确认；签名后才能安装；联网时通过主 SoC 下发和更新。 | 方案§2.3 | P0 | 测试：第 4 组验证断网、内存超限、未签名安装、摄像头确认和联网更新。 | M1 |
| APP-04 | 提供显示、按键、触控、传感器和本地存储接口，让第三方能写计时、计数、清单、单位换算类小工具。 | 方案§2.3 | P1 | 检查：审阅 SDK 接口清单和示例；用两个示例小程序验证接口可用。 | M1 |
| APP-05 | 离线内容同步：默认不上传；首次让用户选择目标与方式。目标含不同步、局域网电脑/主机、用户云（WebDAV、S3 兼容）、官方云、自建同构服务端；方式含联网自动、仅 Wi-Fi、手动；统一上传目标插件；记录日志、失败重试；同步成功且用户允许后才删本地。 | 决定#8；方案§2.4 | P0 | 测试：M1 逐个目标/方式跑上传、失败重试、日志和删除策略；确认默认不上传。 | M1 |

---

## 11 云与自建（CLOUD）

| 编号 | 要求 | 来源 | 优先级 | 验证方法 | 阶段 |
| --- | --- | --- | --- | --- | --- |
| CLOUD-01 | 云服务全开放：用户可以用官方云，也可以自己搭建。 | 决定#16；方案§4.4 | P0 | 演示：M1 分别在官方云和自建服务端建立会话，确认功能同构。 | M1 |
| CLOUD-02 | 协议公开文档化：串流协议、同步接口、通话信令、设备管理、小程序分发接口规范全部公开。 | 方案§4.4 | P0 | 检查：审阅公开文档清单，逐项确认有规范、版本和示例。 | M1 |
| CLOUD-03 | 提供可自行部署的参考服务端容器镜像，功能与官方云同构；眼镜在设置里填写服务器地址即可切换，不锁定官方云。 | 方案§4.4 | P0 | 测试：M1 部署参考服务端，眼镜改服务器地址后完成串流/同步/通话。 | M1 |
| CLOUD-04 | 组件可替换：通话可接开源实时音视频服务（如 LiveKit，Apache-2.0）；同步可接 WebDAV/S3；云串流主机可用任何能跑串流服务端的 GPU 机器。 | 方案§4.4 | P1 | 检查：M1 用 LiveKit、WebDAV/S3 和另一台 GPU 主机各跑一次替换验证。 | M1 |
| CLOUD-05 | 官方云与自建服务端使用同一套开放身份接口；数据存放位置由用户选择；官方云不得成为使用眼镜的前提。 | 方案§4.4 | P0 | 检查：核对身份接口文档和设置项；断开官方云，仅用自建服务端完成全功能。 | M1 |
| CLOUD-06 | 官方云与自建均提供：云串流主机、V2/V3 通话、虚拟形象渲染、离线内容同步、小程序分发；自建小程序私有源需签名。 | 方案§4.4；路线§2.1 | P1 | 检查：对照服务表逐项验证官方/自建两条路径；私有源测签名校验。 | M2 |
| CLOUD-07 | 脑的云端部分：云端 LLM 端点可在设置里配置（官方或自建，与 CLOUD-01 同构），不锁定单一模型或厂商；端点不可达时眼镜不因此失去小脑与手表模式能力。 | 决定#16、#22；方案§1.1、§4.4 | P1 | 检查：切换官方 / 自建两个端点，各跑一次派手流程；断开端点，检查手表模式与本地气泡仍可用。 | M1 |

---

## 12 重量与人体工学（ERGO）

| 编号 | 要求 | 来源 | 优先级 | 验证方法 | 阶段 |
| --- | --- | --- | --- | --- | --- |
| ERGO-01 | 整机重量与目前主流产品相当，重量分配均匀、符合人体工学；总重量不设硬上限，以“佩戴无感”验收。 | 决定#18、#19；方案§7.2 | P0 | 测试：M2 称总重和分段重量，按 ERGO-03–ERGO-05 验收佩戴感，不用总重单独判失败。 | M2 |
| ERGO-02 | 重量与续航冲突时续航为主；电池按满足 8 小时剖面加余量配置；不因减重牺牲 8 小时指标。 | 决定#19；方案§7.2 | P0 | 分析：核对电池容量与 8 h 实测；检查是否用减重方案换续航。 | M2 |
| ERGO-03 | 鼻托受力 ≤ 对标产品实测值；用同一测量台对比本机与对标产品（如 Ray-Ban Meta、XREAL One）。 | 方案§7.3；验证计划 G6 | P0 | 测试：第 6 组头模测鼻托受力，5 次平均；M2 用光波导实物复测。 | M2 |
| ERGO-04 | 左右镜腿重量差 ≤3 g；处理器、射频、电池两侧对称分布。 | 方案§7.3；路线§1.9 | P0 | 测试：左右镜腿分别称重，0.1 g 精度；差值 ≤3 g。 | M2 |
| ERGO-05 | 连续佩戴 2 小时多人主观评分不低于对标主流产品；无明显鼻梁压痕、耳后疼痛。 | 方案§7.3 | P0 | 测试：第 6 组至少 5 人连续佩戴 2 h，每 30 分钟 5 分制评分，记录压痕和疼痛。 | M2 |
| ERGO-06 | 前框只放光学、显示和必要摄像头；主板、射频、电池全部后移到耳后；重心靠近耳朵支点；低头、抬头、走动时不下滑。 | 方案§7.3 | P0 | 测试：M2 测分段重量/重心和动态下滑距离；检查前框器件清单。 | M2 |
| ERGO-07 | 压力分散：镜腿耳后段加宽贴合头型、软质包覆、夹持力低且可调；评估镁合金、钛合金、碳纤维等轻质材料；至少两档镜框、瞳距适配、处方镜片插片。 | 方案§7.3 | P1 | 检查：M2 不同头型试戴、夹持力测量、材料与重量预算评审。 | M2 |
| ERGO-08 | 热舒适：主 SoC、蜂窝放镜腿外侧，远离太阳穴；电池充放电发热导向外侧；表面温度按适用标准设上限，具体阈值待定（M1 定案）。 | 方案§7.3 | P0 | 测试：M2 测前框、左右镜腿、显示面温度；M1 定适用标准和上限。 | M2 |
| ERGO-09 | M2 前做逐项重量预算；每超出 1 g 都要在重量预算表中说明用途。 | 方案§7.2；路线§6 | P0 | 检查：审阅重量预算表，逐项核对器件、电池、结构件和超重说明。 | M1 |
| ERGO-10 | 可选后脑软绑带，用于运动或长时间串流时增加稳定；不作为默认佩戴件。 | 方案§7.3 | P2 | 演示：M2 在运动/长时间串流场景试用绑带，记录下滑和主观舒适；默认形态不装。 | M2 |

---

## 13 隐私与安全（SEC）

| 编号 | 要求 | 来源 | 优先级 | 验证方法 | 阶段 |
| --- | --- | --- | --- | --- | --- |
| SEC-01 | 小程序调用摄像头、麦克风需用户每次确认；不能长时间占用摄像头和麦克风。 | 方案§2.3 | P0 | 测试：第 4 组在小程序里调用摄像头/麦克风，确认每次弹确认、拒绝后不可用、超时释放。 | M1 |
| SEC-02 | 眼动隐私（预留）：当前版本不采集眼动图像；预留接口定义要求眼动图像只在本地处理、不上传，只上传注视、眨眼、头姿等轻量参数。 | 决定#20；方案§3.8；路线§2.1 | P0 | 检查：审阅预留接口定义；抓包和日志确认当前版本无眼动图像上行。 | M1 |
| SEC-03 | 断网时录制的照片、录像、录音默认不上传；是否上传、传到哪里由用户选择；只传用户选中的内容。 | 决定#8；方案§2.4 | P0 | 测试：M1 默认配置下检查无上传；用户选择目标后只传选中内容。 | M1 |
| SEC-04 | 诊断 JSON 不保存画面内容；原始视频、录音、日志不进公开仓库；测试记录脱敏，不写序列号、SIM 卡号、账号、IMSI/IMEI、受试者个人信息。 | 方案§4.3；验证计划§0.1 | P0 | 检查：抽查诊断日志和公开仓库文件，确认无画面、无标识、无个人信息。 | M1 |
| SEC-05 | 小程序不能联网；内存、存储、CPU 时间受限；签名后才能安装；权限清单随包。 | 方案§2.3；路线§2.3 | P0 | 测试：第 4 组验证断网、资源超限被终止、未签名被拒、权限清单生效。 | M1 |
| SEC-06 | DRM/HDCP 保护内容、反作弊、安全窗口不绕过；按已知边界记录，不承诺可用。 | 方案§4.2；路线§1.8 | P0 | 检查：核对测试记录，确认没有绕过 DRM、反作弊或安全机制。 | M1 |
| SEC-07 | 通话软件的端到端加密、账号、录制和平台规则由软件自身决定；本方案不承诺替第三方解密、录制或改变其规则。 | 方案§3.8 | P1 | 检查：审阅通话接入说明和兼容清单，确认边界写清。 | M2 |
| SEC-08 | 公开仓库只写可公开技术信息；不写公司内部信息、价格、供应商联系人、密钥；不提交固件、SDK 二进制、私钥、令牌、真实设备标识、内部日志或客户数据。 | 任务约束；验证计划§0.1 | P0 | 检查：提交前扫描文件、附件和提交信息，确认无上述内容。 | M1 |
| SEC-09 | 局域网明文投屏只用于开发与演示，只在可信隔离网络、禁止公网转发；正式版对外投屏与远程协助走加密通话链路（CALL-19、CALL-20）；会话自动关闭；原图、哈希与来源留本地，日志不存图片、Base64、密钥或模型原始响应。 | 原型经验§1.5、§5 | P0 | 检查：审阅正式版构建里局域网投屏的开关与默认值；渗透测试公网转发不可用；抽查日志内容。 | M2 |

---

## 14 开发流程与交付（DEV）

| 编号 | 要求 | 来源 | 优先级 | 验证方法 | 阶段 |
| --- | --- | --- | --- | --- | --- |
| DEV-01 | 主 SoC 的 BSP 与开发者文档可获得：Android/内核版本、开发者资格、H.265/AV1 硬解、显示输出、6DoF/手部追踪、平台协处理器开放性；不能只凭公开资料。 | 路线§1.1、§5#1；方案§9 | P0 | 检查：审阅供应商书面答复和 BSP 文档；确认开发板能拿到并启动。 | M1 |
| DEV-02 | 关键选型必须有供应商书面答复或实测结果：主 SoC 三条门禁、DP 桥、光波导/光机、RedCap、MCU、视频与显示处理器、天线/射频；M1 结束前完成。 | 路线§1.1、§5 | P0 | 检查：建立问题清单和答复记录，逐项核对“书面答复/实测/未答复”。 | M1 |
| DEV-03 | DP 桥供应商确认：4 路/2 路 DP1.4a 输入、双目光波导/光机目标分辨率与刷新率输出（具体值 M1 定案）、DSC、延迟、Linux 驱动；光波导/光机/面板供应商确认视场、入眼亮度、分辨率、功耗、重量，以及低刷新/局部刷新、低速显示输入/显示开关。 | 路线§5#3、§5#4 | P0 | 检查：审阅供应商答复和评估板实测记录。 | M1 |
| DEV-04 | RedCap 供应商确认国内 5G SA 频段、eDRX/PSM AT 命令、休眠电流、发射峰值电流；MCU 供应商确认摄像头 MIPI 切换参考、外挂 PSRAM 1080p 录像参考、Zephyr 板级支持；天线供应商确认共存、隔离度、灵敏度下降、SAR 预估。 | 路线§5#5、§5#6、§5#7 | P0 | 检查：审阅三份供应商答复；缺项列为 M1 出口风险。 | M1 |
| DEV-05 | 协议规范和参考实现一起公开；官方云与自建服务端同一份规范；提供一致性测试套件验证第三方实现。 | 路线§2.3；方案§4.4 | P0 | 检查：审阅公开仓库中的规范、参考实现和测试套件；跑通参考实现。 | M1 |
| DEV-06 | 小程序签名与分发：签名包、权限清单、HTTPS 分发；未签名包拒绝安装；联网时经主 SoC 下发更新。 | 方案§2.3；路线§2.3 | P0 | 测试：M1 分发签名/未签名包，验证安装、权限和更新。 | M1 |
| DEV-07 | 系统/固件 OTA、回滚、救砖、镜像签名与安全启动：待定（M1 定案）。源文档只明确小程序签名/更新，系统 OTA 需在 M1 补定，不得写成已具备。 | 路线§2.1、§2.3 | P1 | 检查：M1 出口前补齐 OTA/回滚/救砖/签名方案；未补齐列为出口风险。 | M1 |
| DEV-08 | 开源许可：使用开源组件前核实许可证；LiveKit 为 Apache-2.0；Audio2Face 许可未核实前只做内部技术验证，不对外分发生成内容。 | 方案§4.4、§3.8；验证计划§5.8 | P0 | 检查：审阅许可证清单和使用边界；未核实许可的组件不得进入对外交付。 | M1 |
| DEV-09 | M1 出口：按路线 §2.2 表逐格跑通；A1 两档、A2、B、C 跑通；虚拟形象用语音 + 头部姿态驱动跑通；眼动接口预留核对；手表模式与 S0–S3 切换含 S1 会话保持；各电源域功耗实测；协议 v0 冻结；主 SoC 门禁定案；天线方案完成。 | 路线§3 | P0 | 检查：逐项核对 M1 出口清单和演示/测试记录。 | M1 |
| DEV-10 | M2 出口：全部功能在眼镜形态可用；续航 P1 剖面整机 8 小时；光波导实物鼻托受力对标；并发主场景温升；射频共存与 SAR 摸底。 | 路线§3 | P0 | 测试：M2 整机按出口清单逐项测试；8 h 和鼻托受力为硬闸门。 | M2 |
| DEV-11 | M3：只在 M2 冻结架构内优化功耗、重量和散热；做无线电型号核准、进网、SAR、电池安全预测试；认证预测试无阻断项。 | 路线§3 | P0 | 测试：M3 做认证预测试并记录阻断项；改架构项目不得放进 M3。 | M3 |
| DEV-12 | 文档：BSP/设备 API/协议/小程序 SDK 文档和模拟器对开发者开放；协议规范与参考实现公开；文档随版本更新。 | 方案§2.3、§4.4；路线§2.3 | P0 | 检查：审阅文档清单、版本号和开发者可访问性。 | M1 |
| DEV-13 | 仓库：设计文档、协议规范、参考实现、一致性测试套件纳入版本化公开仓库；变更可追溯；不放入内部资料。 | 方案§4.4；路线§2.3；任务约束 | P0 | 检查：核对仓库目录、版本记录和提交内容边界。 | M1 |

---

## 15 关键数字索引

| 关键内容 | 要求原文 | 对应编号 |
| --- | --- | --- |
| 网络三档 | 30/2 Mbps、RTT p95 ≤50 ms；5/5 Mbps、≤100 ms；35/8 Mbps、≤50 ms | NET-01、NET-02、NET-03 |
| 功耗预算 | 串流 ≤2.0 W、通话 ≤3.0 W、6DoF ≤2.0 W、轻度 ≤0.4 W、手表 ≤0.08 W、S1/S2 ≤0.08 W，合计约 5.9 Wh | PWR-01–PWR-07 |
| 电池与续航 | 5–7 Wh；超预算加到 8–10 Wh；8 小时续航 P1 混合剖面 | HW-PWR-02、PWR-08、PWR-09 |
| S1 唤醒 | 戴上恢复 ≤1 s | PWR-11 |
| 延迟预算 | 方案 §3.5 各环节 | DISP-01–DISP-05 |
| 显示 | 双目光波导，视场 30–50°；分辨率待定（M1 定案）；入眼亮度目标约 4000 尼特；刷新 60 Hz 起、可补帧到 90 Hz 以上 | HW-OPT-01、HW-OPT-03 |
| 人体工学 | 鼻托受力 ≤ 对标实测值；左右重量差 ≤3 g；2 小时主观评分不低于对标 | ERGO-03、ERGO-04、ERGO-05 |
| USB-C 通道分配 | A1 4 路 DP + USB 2.0 + 受电；A2 USB 3 + 受电；模块 USB 3（视版本加 DP） | HW-IO-01、HW-IO-02、HW-IO-03 |
| 主 SoC 三条门禁 | 独立运行、H.265 硬解、1080p 级 60 Hz 以上送显 | HW-SOC-03、HW-SOC-04、HW-SOC-05 |
| 协议视频面 | 必须不可靠传输：QUIC DATAGRAM 或 RTP/UDP | PROT-02 |
| 气泡上屏 | 主 SoC 睡眠时，BLE 气泡 ≤0.1 s 上屏【设计目标】 | HW-MCU-06、PWR-18、SW-15 |
| 小脑合成 | 多图层合成、锚定、重投影 ≤5 ms【设计目标】 | SYS-09、SW-02 |
| 同屏数量 | 最多 1 个主显示 + 最多 2 个气泡（30–50° 视场）【设计目标】 | SW-14、SW-16 |

---

## 16 需求变更规则

### 16.1 变更分级

| 级别 | 触发条件 | 确认要求 | 记录 |
| --- | --- | --- | --- |
| A 类：触及需求方决定 | 改变方案 §0.1 的 25 条决定之一 | **必须由需求方重新确认**；未确认前不得按新方向排期、采购或验收 | 记录确认日期、确认人、变更理由和影响范围 |
| B 类：改变要求但不触及 25 条决定 | 改变 P0/P1/P2、关键数字、验证方法、阶段或验收闸门 | 项目技术负责人评审；涉及对外交付的，需求方知会 | 版本号 +0.1，更新追溯表和验证计划 |
| C 类：文字/来源/编号修订 | 不改变要求含义和验收口径 | 编辑修订 | 记录修订说明，不改变编号 |

### 16.2 变更流程

1. 提变更单：写原要求编号、拟改内容、理由、依据、影响范围（硬件/软件/结构/验证/认证）、验证代价、是否触及 25 条决定。
2. 判定级别：A 类先停，交需求方重新确认；B 类交技术评审；C 类直接编辑。
3. 更新文件：修改要求表、关键数字索引和追溯表；版本行注明新版本和依据。
4. 通知与回读：通知硬件、软件、结构、验证和认证负责人；修改后回读确认没有遗漏旧编号。

**实测不达标不等于要求自动改变。** 先记录偏差、原因和候选对策，再按上表走变更；不得在验证报告里直接放宽指标。

### 16.3 路线 §4 中会改变决定的情形

| 路线 §4 的结果 | 路线变化 | 是否改变需求方决定 | 本文件处理 |
| --- | --- | --- | --- |
| G1 有线延迟达标、Wi-Fi 不达标 | 先调编码参数和信道再测；仍不达标，把游戏和空间应用优先放到有线 | **改变第 11 条（默认无线全功能）的体验范围，需要重新确认** | 暂停按“全场景无线优先”排期，走 A 类变更 |
| G2 锚定或手势不达标 | 先提高追踪相机规格或算法；仍不达标，考虑把 6DoF 简化为“虚拟屏锚定 + 简化手势” | **简化会改变第 5 条，需要重新确认** | 走 A 类变更，不得直接降级 |
| G3 RedCap 不达标 | 换对照模组；仍不达标，高带宽交给线控模块 | **改变第 9 条，需要重新确认** | 走 A 类变更，机身蜂窝降级方案不得直接实施 |
| G4（暂定）子系统功耗代入后超出路线 §1.9 预算 | 先压功耗，再按续航优先把电池加到 8–10 Wh；G4 只是早期预警，最终以 M2 整机 8 小时实测为准 | 不改变第 19 条（续航优先），但重量上升 | 走 B 类变更，更新重量预算和 PWR 要求 |
| G5 部分通话软件 V1 不通过 | 按路线 §2.2 改走 V2/V3 | 不改变第 12 条，前提是每个软件至少有一条路径；都不通的列入清单，向需求方说明 | 走 B 类变更；出现“全不通”时升级为 A 类说明 |
| G6 配重样架基线 | 只验证“重量后移”假设；光波导前框是否超标在 M2 用实物测；超标就前框换轻材料或调整重量分配 | 不改变 | 走 B 类变更，更新 ERGO 和重量预算 |
| 主 SoC 门禁不通过 | 按路线 §1.1 顺序切换；走到“眼镜 + 计算盒”形态时 | **改变第 11 条，需要重新确认** | 走 A 类变更，不得直接切成计算盒形态 |

---

## 17 追溯表：25 条决定 → 需求编号

| 决定# | 决定要点（摘自方案 §0.1） | 对应需求编号 |
| --- | --- | --- |
| 1 | 睡眠能力 = 低功耗待机 + 快速唤醒 + 恢复原状态 | PWR-11、PWR-12、PWR-13、PWR-14 |
| 2 | “特殊投屏算法”理解基本正确，细节可后续补充 | SW-22、SW-23、PROT-15、SW-07、SW-08、SW-09、SW-10 |
| 3 | 5G 放线控模块和做一体式“两种都要” | SYS-04、HW-CELL-01、HW-CELL-02 |
| 4 | 主要外部主机 PC、手机、车机、云全部要 | SYS-06、HOST-01、HOST-08、HOST-09 |
| 5 | 需要 6DoF，重点是 VR 级能力 + AR 效果，不强调完整 VR 游戏 | SYS-07、HW-SENS-01、HW-SENS-05、HW-SENS-06、DISP-05 |
| 6 | 断网退化为手表级设备，联网才是全功能，依赖网络不只依赖手机 | SYS-01、SYS-02、SYS-03、SYS-08、PWR-12 |
| 7 | 手表模式本地程序由项目方结合资料定 | APP-01、APP-02、APP-03、APP-04 |
| 8 | 断网录制内容保留一个接口，由使用者自己选择 | APP-05、SEC-03 |
| 9 | 机身蜂窝最低要求 = 满足串流最低要求 | HW-CELL-01、HW-CELL-02、HW-CELL-05、NET-01、NET-02、NET-03、NET-04、NET-05 |
| 10 | 第一版样机范围 = 完全版 | SYS-05 |
| 11 | 默认形态 = 默认无线 | SYS-04、HW-SOC-06、HW-CELL-02 |
| 12 | 视频通话拉满，包括投屏视频 | CALL-01、CALL-02、CALL-03、CALL-04、CALL-05、CALL-06、CALL-07、CALL-08、CALL-09、CALL-10、CALL-11、CALL-12、HOST-08 |
| 13 | 通话中让对方看到“我本人” = 虚拟形象（当前版本语音 + 头部姿态驱动，不用眼动） | CALL-04、CALL-13、CALL-14、CALL-15、CALL-16、CALL-17、CALL-18 |
| 14 | 小程序运行时 WebAssembly 与 Lua 都支持，对开发者开放 | APP-02、APP-03、APP-04 |
| 15 | 续航至少 8 小时，按机身混合使用计算（续航 P1） | PWR-08、PWR-09、HW-PWR-02 |
| 16 | 云服务全开放：可用官方云，也可自建 | CLOUD-01、CLOUD-02、CLOUD-03、CLOUD-04、CLOUD-05、CLOUD-06 |
| 17 | 8 小时混合使用剖面认可，冻结为续航验收条件 | PWR-08、PWR-09 |
| 18 | 重量与主流产品相当，重量分配均匀、符合人体工学 | ERGO-01、ERGO-03、ERGO-04、ERGO-05、ERGO-06、ERGO-07、ERGO-08、ERGO-09、ERGO-10 |
| 19 | 重量与续航冲突时续航为主；重量分配好，让人尽量无感 | ERGO-01、ERGO-02、HW-PWR-02、PWR-17 |
| 20 | 眼动追踪当前版本只做预留、不上：结构空间、走线、连接器、MIPI 接口与电源域预留；软件只保留接口定义 | SYS-05、HW-SENS-03、HW-PWR-03、SW-05、CALL-14、CALL-16、SEC-02、DEV-09 |
| 21 | 显示方案只用光波导，其他都不行；M2 直接用光波导 | HW-OPT-01、HW-OPT-02、HW-OPT-03、HW-OPT-04、HW-OPT-05、HW-OPT-06、HW-DP-02、ERGO-03、DEV-10 |
| 22 | 脑、小脑、手：眼镜 + 云端 LLM = 脑；眼镜算力只当小脑；所有主机都是手；谁的手谁渲染，重渲染不在眼镜；看板默认发描述 | SYS-09、SYS-10、SW-21、CLOUD-07、SW-14、SW-20、HOST-10、HOST-11、HOST-12、PROT-12、PROT-13、PROT-14 |
| 23 | 六种显示模式与小脑调度：1 主 + 2 气泡、优先级、就地变形、行走缩边、焦点跟语音；投屏只在接管时出现，安全页黑屏；L0 = 投屏、L3 = 看板、L4 = 看板兜底 | SW-22、HOST-13、HW-DP-07、SW-14、SW-15、SW-16、SW-17、SW-18、SW-19、SW-20、PROT-12 |
| 24 | 硬件跟随调整：MCU 常驻 BLE（A/B 两案）、看板态、音频常驻“耳朵 + 嘴巴”、新使用剖面；HW-DP-06 降为 P2 | SYS-05、HW-SOC-01、HW-DP-06、HW-MCU-01、HW-MCU-05、HW-MCU-06、HW-AUD-01、HW-AUD-02、HW-AUD-03、PWR-18、PWR-19、PWR-20、PROT-14 |
| 25 | 脑、小脑、手、脚：连接就是脚（机身蜂窝、Wi-Fi 7、BLE、有线 USB-C、可选线控模块 5G）；四个角色加器官贯穿全部设计 | SYS-02、SYS-06、SYS-10、SW-21、CLOUD-07、HW-CELL-01、HW-IO-01、HW-IO-05、HW-MCU-05、NET-01、HOST-07、PROT-01、PROT-14 |

---

## 18 角色映射：脑、小脑、手、脚 → 需求编号

按方案 §1.1（决定 #22、#25）把全部需求归到角色上。一条需求可以属于多个角色；SEC、DEV 贯穿全部角色，不单列。

| 角色 | 是什么 | 主要需求编号 |
| --- | --- | --- |
| **脑** | 眼镜 + 云端 LLM：理解意图、派哪只手、决定显示什么。没有独立芯片，端侧入口跑在小脑上 | SYS-09、SYS-10、SW-21、SW-27、CLOUD-07 |
| **小脑** | 主 SoC、显示与重投影处理器、MCU：追踪、解码、合成、重投影、轻卡片、条件反射、手表模式、显示分配 | HW-SOC-01–07、HW-DP-01–07、HW-MCU-01–04、HW-SENS-01–06、DISP-01–05、SW-01–05、SW-14–20、SW-22–SW-26、PWR-01–20、APP-01–05 |
| **手** | 手机、PC、车机、云主机：运行应用、按自己的界面渲染 | HOST-01–13、SW-06–13、CALL-01–22（主机侧与云侧部分）、CLOUD-01–06 |
| **脚** | 机身蜂窝、Wi-Fi 7、常驻 BLE、有线 USB-C、可选线控模块 5G：把脑带到手那里 | SYS-02、SYS-04、SYS-06、HW-CELL-01–05、HW-IO-01–05、HW-MCU-05–06、HW-ACC-01、CALL-19、CALL-20、NET-01–05、HOST-07、PROT-01–05、PROT-08、PROT-11、PROT-14、PROT-15、PROT-16 |
| **器官** | 摄像头（眼睛）、麦克风（嘴巴）、扬声器 / 耳机（耳朵）、光波导 + 光机（视网膜） | HW-OPT-01–07、HW-AUD-01–05、HW-SENS（主摄与眼动预留）、CALL（摄像头与音频上行） |
| **身体** | 电池、结构、重量分配、散热 | HW-PWR-01–03、ERGO-01–10、HW-MFG-01–04 |
| 手 ↔ 小脑之间的约定 | 看板描述、手协议与输入回传：手产出、脚运送、小脑画、脑发起 | PROT-12、PROT-13、PROT-15 |
| 贯穿全部角色 | 开放与交付：协议公开、v0 冻结、同步与小程序分发通道、隐私安全、开发流程 | PROT-06、PROT-07、PROT-09、PROT-10、SEC-01–09、DEV-01–13 |

【项目判断】**脑的需求最少**：脑的推理在云端，端侧只是意图入口和派手路由，所以集中在 SW-21 与 CLOUD-07；它的效果主要靠 M1 的“打开 QQ”全流程来验证。
