jodancain/independent-cellular-ai-glasses/docs/streaming-direction.md

# 串流终端方向：Quest 级体验的 AR 眼镜版

**v0.7.6 方向稿 · 2026-11-05 · 来源核验日期 2026-11-04**

本页把“自研眼镜”的目标整理成一套可评审的技术路线：**联网后靠网络获得 Quest 级串流体验；通过投屏转化兼容尽量多的软件；与人眼看到的真实画面交互；断网时退化为手表级设备；视频通话与会议达到手机水平；具备强睡眠能力。**

> **证据边界**：本页区分三类内容——【公开资料】有来源链接的厂商或项目公开信息；【项目判断】本项目的推理与取舍；【设计目标】希望达到但尚未测量的指标。厂商宣传数字（如延迟、功耗）未经本项目复现，不能当作整机实测结果。本页不是冻结规格。

与 [开发需求](requirements.md) 的关系：需求文档面向“独立蜂窝 + 现场作业”的轻量眼镜；本页是另一条**串流终端**产品方向，两者共用“ARM 应用平台 + 自主软件 + 可维护 BSP + 不依赖手机独立联网”的边界。冲突时以需求文档的硬性边界为准。

---

## 0 一句话方案

**眼镜依赖网络而不是依赖手机：机身自带蜂窝和 Wi-Fi，联网时把重渲染交给任意主机（PC、手机、车机、云），眼镜只做“看清真实世界 + 定位追踪 + 低延迟解码 + 叠加显示 + 交互”；断网时只保留时间、拍照、录像、录音和极小本地程序，像一块戴在脸上的智能手表；不用时深度睡眠、秒级唤醒。**

**用一句话概括整套架构：眼镜有脑、有小脑、有手、有脚。** 脑（眼镜 + 云端 LLM）理解意图、决定派哪只手、决定显示什么；小脑（眼镜自身算力）负责贴身、实时、条件反射的事；手（手机、PC、车机、云主机）运行应用并渲染自己的内容；脚（机身蜂窝、Wi-Fi 7、BLE、有线 USB-C）让脑不靠手机就能走到任何一只手那里。四个角色贯穿方案、硬件、软件、协议、功耗与验证，对照表见第 1.1 节。

### 0.1 需求方已确认的决定（2026-11-03，第 21 条补充于 2026-11-04，第 22–24 条补充于 2026-11-04，第 25 条补充于 2026-11-05）

| # | 问题 | 确认结果 | 对方案的影响 |
| --- | --- | --- | --- |
| 1 | 睡眠能力的含义 | 低功耗待机 + 快速唤醒 + 恢复原状态 | 第 5 节 |
| 2 | “特殊投屏算法”的理解 | 基本正确 | 第 4.1 节保留，细节可后续补充 |
| 3 | 5G 放线控模块还是做一体式 | **两种都要** | 机身内置蜂窝保证独立联网；线控模块提供大电池和更高带宽（第 1、6 节） |
| 4 | 主要外部主机 | **PC、手机、车机、云全部要** | 串流服务端做成多平台；主机发现与切换（第 3.4 节） |
| 5 | 是否需要 6DoF | **需要**，但不强调完整 VR 游戏；重点是 VR 级能力 + AR 效果，与人眼看到的画面交互 | 6DoF 追踪、空间锚定、手势交互成为基础能力（第 3 节） |
| 6 | 断网行为 | 断网时退化为手表级设备，其他功能全部砍掉；联网才是全功能；依赖网络，不只依赖手机 | 新增两级功能模式与双处理器设计（第 2 节） |
| 7 | 手表模式本地程序 | 由项目方结合资料定 | 内置程序清单 + 受限沙箱小程序接口（第 2.3 节） |
| 8 | 断网录制内容的上传 | **保留一个接口，由使用者自己选择** | 同步接口可选目标与方式，默认不上传，首次使用时让用户选（第 2.4 节） |
| 9 | 机身蜂窝最低要求 | **满足串流最低要求** | 定义串流最低网络指标，机身蜂窝按此选型（第 6.3 节） |
| 10 | 第一版样机范围 | **完全版** | 有线、Wi-Fi、蜂窝、6DoF、视频通话、手表模式全部进第一版样机（第 9 节） |
| 11 | 默认形态 | **默认无线** | 眼镜本体自带电池独立全功能；线控模块为可选配件（第 1 节） |
| 12 | 视频通话 | **拉满**：像正常手机视频电话、视频会议一样，包括投屏视频 | 新增视频通话与会议能力（第 3.7 节） |
| 13 | 通话中让对方看到“我本人” | **虚拟形象** | 语音 + 头部姿态驱动的虚拟形象；眼动摄像头仅预留 |
| 14 | 小程序运行时 | **WebAssembly 与 Lua 都支持**，对开发者开放 | 第 2.3 节 |
| 15 | 续航 | **至少 8 小时，按机身混合使用计算**（P1） | 第 5.3 节；连续全功能靠换电或线控模块补充 |
| 16 | 云服务 | **全开放**：可用官方云，也可自建 | 开放协议 + 可自建服务端（第 4.4 节） |
| 17 | 8 小时混合使用剖面 | **认可**第 5.3 节剖面 | 剖面冻结为续航验收条件 |
| 18 | 重量 | 与目前主流产品相当，重量分配均匀、符合人体工学 | 新增结构与人体工学要求（第 7 节） |
| 19 | 重量与续航冲突时 | **续航为主**；重量分配好，让人尽量无感 | 电池按满足 8 小时剖面加余量配置；重量不设硬上限，改以“佩戴无感”验收（第 7 节） |
| 20 | 眼动追踪 | **当前版本只做预留，不上** | 第 3.6、3.8 节 |
| 21 | 显示方案 | **只用光波导，其他都不行** | 第 3.6、7 节 |
| 22 | 脑、小脑、手怎么分 | **眼镜 + 云端 LLM = 脑；眼镜自身算力只当小脑；所有主机（手机、PC、车机、云主机）都是手**。脑理解意图、决定派哪只手、决定显示什么；小脑做姿态追踪、解码、多图层合成、重投影、光波导畸变校正、轻量卡片、条件反射、手表模式和显示分配；**“算法就是视频渲染”，谁的手谁渲染，重渲染永远不在眼镜上** | 第 1.1、3.9、3.10 节 |
| 23 | 显示模式与小脑调度 | **六种显示模式**（看板含气泡、图片、视频、投屏、实时拍照、视频通话）；同屏最多 1 个主显示 + 2 个气泡；优先级视频通话 > 投屏（接管）> 视频 > 实时拍照 > 看板 > 气泡；气泡→看板→投屏就地变形；行走时主显示缩到边缘；焦点跟语音走。投屏只在用户要求接管时出现，付款、密码等安全页黑屏 | 第 3.9 节；第 4.1、4.2 节 |
| 24 | 硬件跟随调整 | 四芯片骨架、光波导、蜂窝、Wi-Fi 7、USB-C、传感器和主 SoC 门禁都不改。改 4 处：MCU 侧常驻收 BLE（A/B 两案并行）；新增看板态低功耗通路；音频升级为常驻“耳朵 + 嘴巴”；按新使用方式重算功耗剖面。视频不再是主要场景，HW-DP-06 降为 P2 / M1 次要评估项 | 第 5.4、5.5、6.2 节；[技术路线](technical-roadmap.md)第 1.5、1.6、1.9 节 |
| 25 | 脚 | **眼镜有脑、有小脑、有手、有脚**（需求方 2026-11-05 提出“脑脚手”）。**脚 = 连接**：机身 RedCap 蜂窝、Wi-Fi 7、常驻 BLE、有线 USB-C（A1 / A2），以及可选线控模块的全功能 5G。脚让脑不靠手机就能走到任何一只手；选路按“有线 > 同局域网 > 云”，BLE 常连做细步（意图、气泡、看板描述），Wi-Fi / 蜂窝做大步（视频、投屏）；四条腿都断时等于没有脚，退化为手表模式 | 第 0、1.1、3.3、5、6.3 节；[技术路线](technical-roadmap.md)第 0、1.8 节 |

### 0.2 相对 v0.2 的变化（v0.3）

| 变化 | v0.2 | v0.3 |
| --- | --- | --- |
| 联网方式 | 5G 只在线控模块里 | **机身内置低功耗蜂窝（RedCap / LTE）+ Wi-Fi**；线控模块可选，增加电池和高带宽 5G |
| 功能分级 | 未定义断网行为 | **联网全功能 / 断网手表模式** 两级 |
| 处理器 | 单颗眼镜 SoC | **主处理器 + 低功耗协处理器**：断网模式和待机由协处理器负责 |
| 追踪 | 3DoF 起步，6DoF 另报 | **6DoF 为基础能力**，重点做真实场景锚定与手势交互，不追求完整 VR 游戏 |
| 主机 | 主机待定 | PC、手机、车机、云四类全部支持 |

### 0.3 v0.7.5 变化（2026-11-04）

- 新增需求方决定 #22–#24：脑 / 小脑 / 手、六种显示模式与小脑调度、4 处硬件跟随调整。
- 新增第 1.1 节“脑、小脑、手”，第 3.9 节“显示模式与小脑调度”，第 3.10 节“手的统一接入”。
- 第 4.1、4.2 节同步看板描述与 L0 / L3 / L4 的对应；第 5.4、5.5 节新增看板态与新使用剖面；第 6.2 节补 BLE 要求。
- 第 9、10 节补待验证与仍待确认。旧剖面与已算好的功耗数字不改，新剖面单列并标“待定（M1 定案）”。

### 0.4 v0.7.6 变化（2026-11-05）

- 新增需求方决定 #25：在“脑、小脑、手”之外正式加入**脚（连接）**，四个角色加器官贯穿全方案。
- 第 0 节加一句话总述；第 1 节框图标出各部分角色；第 1.1 节扩为“脑、小脑、手、脚”，新增脚的规则与“四个角色贯穿全方案”对照表。
- 第 3.3、5.2、6.3 节点明各自讲的是脚。
- 新增第 3.11 节“多路信号与并发”和第 4.5 节“投屏处理链路”：实时视频只解 1 路全帧率、多屏打包成一路、多人通话由手合成、一次采集多处使用、脚的带宽优先级、A1 时显示处理器叠加气泡、投屏操作回传。没有新增数字，原有数值不改；路数与延迟阈值待 M1。

---

## 1 整体架构

```
       ┌─────────────────── 外部主机（手，重渲染，可任选）───────────────────┐
       │   PC / 笔记本   │   手机   │   车机   │   云端渲染 / 远程桌面      │
       │ 虚拟显示器驱动 + 编码器 + 自研串流服务（多平台统一协议）             │
       └──────┬────────────────┬──────────────────┬──────────────────────┘
脚：① 有线 DP Alt / USB    ② Wi-Fi 7 / 6E       ③ 蜂窝（机身 RedCap / 模块 5G）
              │                │                  │
 ┌────────────▼────────────────▼──────────────────▼─────────────────────────┐
 │ 眼镜本体：脑的端侧 + 小脑 + 器官 + 脚                                     │
 │  主处理器（小脑 · 联网全功能时工作）                                         │
 │   • 视频入口：DP 接收 或 硬件解码（H.265 / AV1，视芯片）                       │
 │   • 6DoF 追踪 + 手势 + 本地重投影：叠加内容锚定在真实世界                       │
 │   • 光学透视显示（AR 效果）：人眼直接看真实画面，虚拟内容叠加其上                │
 │   • 脚：Wi-Fi 7 + 机身蜂窝（RedCap / LTE，eSIM 或 SIM）                      │
 │  低功耗协处理器（小脑常驻 · 始终在线）                                       │
 │   • 断网手表模式：时间、拍照、录像、录音、极小本地程序                           │
 │   • 睡眠与唤醒：佩戴检测、IMU、按键、唤醒词                                    │
 │   • 脚的 BLE 常驻 + 耳 / 嘴的音频前级：收气泡、听唤醒词                          │
 │  小电池（保证手表模式与短时联网）                                            │
 └──────────────────────────────┬────────────────────────────────────────────┘
                                │ USB-C（供电 + 数据 + 视频）
                  ┌─────────────▼──────────────┐
                  │ 可选线控模块（扩展仓）        │
                  │ 大电池 + 高带宽 5G 模组       │
                  │ 可选：主机 USB-C 直通、存储    │
                  └────────────────────────────┘
```

【项目判断】**默认形态是无线**：眼镜本体靠自带电池、机身蜂窝和 Wi-Fi 独立完成全功能；线控模块只是可选配件，用于更长续航和更高带宽，不是使用前提。

为什么这样分：

- **依赖网络，不依赖手机**：机身自带蜂窝和 Wi-Fi，任何能上网的地方都能直接连云端或远程主机；手机只是主机之一。
- **机身蜂窝选低功耗档**：RedCap / LTE 足够做独立上网、消息、语音和中等码率云串流，功耗和发热比全功能 5G 小；需要高码率云串流、长时间户外使用时再接线控模块。
- **断网与睡眠交给协处理器**：主处理器、解码、追踪、显示都可以断电，只留协处理器跑手表模式，这是续航和睡眠能力的关键。
- **代价**：默认无线意味着机身要同时放蜂窝天线、两颗处理器、摄像头和足够的电池，重量、散热和成本上升；无线全功能（尤其是串流 + 视频通话并发）的续航是本方向最大的工程风险，必须用整机实测证明可接受。

### 1.1 脑、小脑、手、脚（决定 #22、#25）

需求方确认：**眼镜 + 云端 LLM = 脑；眼镜自身算力只当小脑；所有主机都是手**（决定 #22，2026-11-04）；**连接就是脚**（决定 #25，2026-11-05）。这不是把算力全部搬走，而是把“理解、决策、重渲染”、“必须贴身、对延迟敏感的事”和“怎么走到那只手”三件事分开。

| 角色 | 由谁承担 | 负责什么 | 不负责什么 |
| --- | --- | --- | --- |
| **脑** | 眼镜 + 云端 LLM | 理解意图、决定派哪只手、决定显示什么 | 不做逐帧渲染，不承担头动补偿 |
| **小脑** | 眼镜主 SoC + 显示处理器 + MCU | 姿态追踪、解码、多图层合成、重投影（头动补偿）、光波导畸变校正、画轻量卡片、条件反射（例如立刻弹“正在打开”气泡）、手表模式、显示分配 | 不做重渲染 |
| **手** | 手机、PC、车机、云主机 | 运行应用、产出内容、按自己的界面渲染；云端 GPU 是手，云端 LLM 是脑 | 不替脑决定“显示什么”的最终语义 |
| **脚** | 机身 RedCap 蜂窝、Wi-Fi 7、常驻 BLE、有线 USB-C（A1 / A2）、可选线控模块 5G | 把脑带到手那里：发现主机、选路、保持会话、切换、断线回到上次主机；BLE 常连走细步，Wi-Fi / 蜂窝 / 有线走大步 | 不决定派哪只手（脑决定），不渲染内容（手渲染），不做头动补偿（小脑做） |

器官对应：

| 器官 | 器件 | 说明 |
| --- | --- | --- |
| 眼睛 | 摄像头 | 取景、拍照、识别；采集什么、是否上传由用户和场景决定 |
| 嘴巴 | 麦克风 | 语音输入、通话上行 |
| 耳朵 | 耳机 / 扬声器 | 听语音回复、通话下行、提示音 |
| 视网膜 | 屏幕（光波导） | 只负责把光送进眼睛，不做重渲染 |

渲染规则【项目判断】：“算法就是视频渲染”，谁是手谁渲染。

1. **手渲染自己的内容**：QQ 看板由手机渲染，PC 应用由 PC 渲染。
2. **轻内容由小脑本地画**：气泡、状态、简单卡片。
3. **多图层合成、锚定、重投影由小脑做**，目标 ≤5 ms【设计目标】。
4. **不属于任何一手的重内容**（虚拟形象、3D 标注）交给最近的有 GPU 的手：PC 优先，其次云。
5. **重渲染永远不在眼镜上。**

**脚的规则**【项目判断】（决定 #25）：

1. **依赖网络，不依赖手机**：脚长在眼镜身上。手机只是手之一，不是眼镜的腿；手机不在身边，眼镜照样走到云或 PC。
2. **选路**：有线 > 同局域网 > 云；断线后自动回到上次的手（第 3.4 节）。
3. **细步与大步分开**：意图、气泡、看板描述走 BLE 常连（主 SoC 睡着也能收，第 5.4 节）；视频、投屏走 Wi-Fi、蜂窝或有线。与第 4.3 节“控制面与视频面分离”是同一条规则。
4. **脚也要睡**：蜂窝 eDRX / PSM、Wi-Fi 保活、BLE 常驻的电流决定待机续航；机身蜂窝休眠电流是最大风险（第 5.2 节）。
5. **没有脚就是手表**：四条腿都走不到任何一只手时，按决定 #6 退化为手表模式；判断依据是“走不走得到服务”，不是“有没有连手机”。

**四个角色贯穿全方案**（器官单列）：

| 角色 | 硬件 | 软件 | 协议 / 链路 | 功耗状态 | 验证 |
| --- | --- | --- | --- | --- | --- |
| **脑** | 无独立芯片：端侧意图入口跑在小脑上（MCU 唤醒词、主 SoC），推理在云端 LLM | 意图识别、派手路由、显示决策 | 手协议的发起方（发目标、请求确认） | 断网时只剩端侧极小意图集（时间、拍照、录音） | M1 演示“打开 QQ”全流程 |
| **小脑** | 主 SoC、显示与重投影处理器、MCU | 空间合成器、小脑调度器、看板描述光栅化、MCU 状态机 | 看板描述的接收方；姿态上行 | S0 / S0'' / S1 由主 SoC 与 MCU 承担，S0' / S2 只剩 MCU | 第 2、4 组 |
| **手** | 手机、PC、车机、云主机（不在眼镜上） | 统一串流服务、虚拟显示、Mika 改造版、各类 agent | 手协议执行方；视频面发送方 | 不计入眼镜功耗 | 第 1、5 组 |
| **脚** | RedCap 模组 + eSIM、Wi-Fi 7 / 蓝牙、MCU 侧 BLE、USB-C、天线 | 主机发现与切换、会话保持、选路 | 控制面、视频面、BLE 控制面、有线 DP / USB | 蜂窝 eDRX / PSM、Wi-Fi 保活、BLE 常驻 | 第 1、3 组，第 4 组 BLE 气泡 |
| **器官** | 摄像头（眼睛）、麦克风（嘴巴）、扬声器 / 耳机（耳朵）、光波导 + 光机（视网膜） | 拍照取景、唤醒词、通话音频、上屏 | 摄像头和麦克风上行 | 常驻听音在 MCU | 第 4、5 组 |

【项目判断】**看板传输建议**：手决定看板内容与版式，默认发“看板描述”（文字、头像、按钮、布局，KB 级），小脑按描述光栅化；描述表达不了时，手直接发图片作为兜底。看板仍由手决定内容与版式，只是把“画像素”换成“发描述”，不违背“谁的手谁渲染”。这样省电，断网时已缓存的看板仍能显示。看板描述与第 4.1 节“矢量与画面分开”是同一条思路。

---

## 2 两级功能模式

### 2.1 模式定义

| 模式 | 进入条件 | 保留功能 | 关闭功能 | 主要运行硬件 |
| --- | --- | --- | --- | --- |
| **全功能（联网）** | 有可用网络（Wi-Fi、机身蜂窝或模块 5G）并能连上主机或云 | 串流显示、6DoF 叠加交互、全部软件兼容、云端 AI、远程协作，以及手表模式全部功能 | — | 主处理器 + 协处理器 |
| **手表模式（断网）** | 无网络，或网络可用但所有主机和云都连不上 | 看时间、拍照、录像、录音、极小本地程序（如计时、备忘、离线提示卡、简单计算） | 串流、6DoF 叠加、软件兼容层、云 AI、其他全部功能 | 主要由协处理器；拍录像时按需唤醒摄像与编码 |

【项目判断】规则：

- 判断依据是**能不能连上服务**，不是“有没有连手机”。网络在但主机和云都不可达，也按断网处理。
- 断网期间拍的照片、录像、录音存在本地，恢复联网后自动上传或同步（用户可关闭）。
- 模式切换要无感：断网时当前串流画面淡出并提示“已切换到离线模式”；联网恢复后自动回到上次的主机和会话。
- 极小本地程序需要一个受限运行环境（例如脚本或小型应用容器），有内存、存储和权限上限，不能访问网络，不能长时间占用摄像头和麦克风。

### 2.2 手表模式的硬件要求

| 功能 | 要求 | 说明 |
| --- | --- | --- |
| 时间 | 实时时钟 + 低功耗显示刷新 | 显示可只点亮局部，低刷新 |
| 拍照 | 摄像头 + ISP | 协处理器需带 ISP，或能快速唤醒主处理器的 ISP |
| 录像 | 硬件 H.264 / H.265 编码 | 协处理器带编码最好；否则录像时唤醒主处理器 |
| 录音 | 麦克风 + 音频编码 | 协处理器即可 |
| 本地程序 | 小型运行时 | 内存以 MB 计，不要求跑完整操作系统应用 |
| 存储 | 本地闪存 | 容量按录像时长定 |

公开参照：STM32N657 为 M55 MCU，具 ISP 与 H.264 能力【公开资料】[S12](sources.md#s12)；W5+ Gen 1 配套 M55 协处理器【公开资料】[S2](sources.md#s2)；AR1+ Gen 1 有双 ISP【公开资料】[S18](sources.md#s18)。这些说明“协处理器负责低功耗功能、主处理器按需唤醒”的分工有现成芯片参照，但本项目所需的具体组合仍需供应商证明。

### 2.3 手表模式的本地程序（项目建议）

【项目判断】结合手表模式“只保留最小功能”的原则和协处理器的资源（内存以 MB 计），建议分两类：

**内置程序（出厂自带）**

| 程序 | 用途 | 依赖 |
| --- | --- | --- |
| 时钟 / 闹钟 / 计时 / 秒表 | 基本手表功能 | 实时时钟 |
| 相机 | 拍照、录像，查看最近几张 | 摄像头、ISP、编码 |
| 录音 / 语音备忘 | 录音、按时间列表回放 | 麦克风 |
| 提词卡 / 离线备忘 | 显示预先同步到本地的文字（清单、提词、操作步骤） | 本地存储 |
| 离线扫码 | 识别二维码并显示内容（不打开网址） | 摄像头 |
| 状态 | 电量、存储、网络状态、待同步数量 | — |

**第三方小程序（受限沙箱）**

- 运行在协处理器上的受限运行时：**WebAssembly（如 WAMR）与 Lua 两者都支持**（需求方已确认），共用同一套权限、签名和设备接口，并对开发者开放 SDK、文档和模拟器。Halo 眼镜固件已采用 Lua 运行时承载设备端应用并支持 OTA【公开资料】[S14](sources.md#s14)；WAMR 是小体积的 WebAssembly 运行时【公开资料】[S29](sources.md#s29)。
- 限制：不能联网；内存、存储、CPU 时间有上限；摄像头和麦克风需用户每次确认；签名后才能安装；联网时通过主处理器下发和更新。
- 提供简单的显示、按键、触控、传感器和本地存储接口，让第三方能写计时、计数、清单、单位换算这类小工具。

### 2.4 离线内容同步接口（使用者选择）

需求方确认：断网时录制的照片、录像、录音，联网后是否上传、传到哪里，**保留一个接口，由使用者自己选择**。

【项目判断】设计：

- **默认不上传**。首次使用时让用户选择同步方式，之后可随时修改。
- 同步目标可选：不同步 / 局域网内的电脑或主机 / 用户自己的云存储（如 WebDAV、S3 兼容存储）/ 官方云 / 用户自建的同构服务端（第 4.4 节）。
- 同步方式可选：联网自动同步 / 仅 Wi-Fi 时自动同步 / 手动同步。
- 对外提供统一的**同步接口**（上传目标插件），第三方或企业可接自己的存储；接口只传用户选中的内容，记录同步日志，失败可重试。
- 本地内容在同步成功并经用户设置允许后才删除，避免断网录制内容丢失。

---

## 3 目标一：联网后的串流与真实画面交互

### 3.1 定位：VR 级能力，AR 效果

- 不追求完整 VR 游戏。重点是**和人眼看到的真实画面交互**：虚拟屏幕、信息卡、指引箭头、标注等稳定地“贴”在真实物体或空间位置上，用手势来操作。
- 需要的能力：**6DoF 追踪**（头在空间里移动，叠加内容不漂移）、**空间锚定**（内容固定在真实位置）、**手势交互**、**平面 / 物体识别**（知道桌面、墙、设备在哪）。
- 显示走**光学透视**：人眼直接看真实世界，虚拟内容叠加其上。与摄像头透视的头显相比，真实画面没有延迟和画质损失，但叠加内容的亮度、对比度、视场受光学方案限制。

### 3.2 算力分工

| 环节 | 在哪里做 | 原因 |
| --- | --- | --- |
| 6DoF 追踪、手势、重投影 | **眼镜本地** | 对延迟极敏感，不能走网络 |
| 场景理解（平面、物体识别） | 本地轻量 + 主机 / 云重计算 | 结果可以慢一点，但需要持续更新 |
| 内容渲染（虚拟屏、3D 内容） | **主机或云** | 重计算，串流回眼镜 |
| 合成上屏 | 眼镜本地 | 用最新姿态把串流画面贴到正确位置 |

公开参照：AR2 Gen 1 采用多芯片分布式架构，把感知与低延迟环节留在眼镜端、重计算交给主机，并宣称 Wi-Fi 7 持续延迟 < 2 ms【公开资料】[S17](sources.md#s17)。

### 3.3 连接方式

这一节讲的是**脚**（决定 #25）：四种连接就是脚的四条腿，BLE 常连控制面见第 3.10、5.4 节。

| 模式 | 链路 | 体验定位 | 主要前提 |
| --- | --- | --- | --- |
| **A1 有线原始画面** | USB-C DP Alt Mode | 最低延迟、无压缩画质；固定场景“超强体验”上限 | 主机支持 DP 视频输出 |
| **A2 有线编码串流** | USB 3.x 数据通道 | 接近 A1，兼容没有 DP 输出的手机或主机 | 主机能硬件编码 |
| **B Wi-Fi 串流** | Wi-Fi 7 / 6E | 日常移动使用 | 主机有线接路由器或直连 |
| **C 蜂窝串流** | 机身 RedCap / 模块 5G | 离开主机时连云端或远程主机 | 运营商上行带宽与时延；云端渲染资源 |

公开参照：XR2（第一代，Quest 2 所用平台）5G 为可选集成【公开资料】[S19](sources.md#s19)；XREAL One 系列以 USB-C DP 输入并在眼镜端芯片做稳定与畸变校正，宣称约 3 ms【公开资料】[S20](sources.md#s20)；ALVR、WiVRn 是成熟的开源 PC → 一体机串流方案【公开资料】[S24](sources.md#s24)[S25](sources.md#s25)；Sunshine / Moonlight 支持 H.264、HEVC、AV1 平面串流【公开资料】[S26](sources.md#s26)。

### 3.4 四类主机统一接入

| 主机 | 接入方式 | 适合内容 | 说明 |
| --- | --- | --- | --- |
| PC / 笔记本 | 虚拟显示器驱动 + 串流服务；或 DP 有线 | 办公、开发、游戏、3D 内容 | 体验上限最高 |
| 手机 | 手机这只手：Mika 改造版（任务接口 · 看板生成 · 虚拟显示 + 编码，见第 3.10 节）；或 DP 有线 | 手机应用、消息、导航 | 安卓与 iOS 能力不同，需分别评估 |
| 车机 | 车机侧串流服务或标准车机协议 | 导航、车辆信息、娱乐 | 行车安全需单独评估；不承诺驾驶中所有功能可用 |
| 云 | 云端渲染 + 蜂窝 / Wi-Fi 串流 | 离开本地主机时的全功能 | 时延和流量成本是主要约束 |

【项目判断】四类主机用**同一套串流协议**：会话握手带能力位、控制面与视频面分离、断线后自动回到上次主机；多个主机同时可用时按“有线 > 同局域网 > 云”的顺序优先。

按决定 #22，这四类主机都是**手**：手机负责移动应用、通知和 QQ 一类看板；PC 负责办公、开发、游戏和 3D 内容；车机负责导航和车辆信息；云主机负责云端 GPU 重内容和虚拟形象。手只渲染自己的内容，脑决定派哪只手、显示什么，小脑负责合成与上屏。手机这只手的接入细节见第 3.10 节。

### 3.5 延迟预算（设计目标，待实测）

| 环节 | A1 有线原始 | A2 有线编码 | B Wi-Fi 7 | C 蜂窝 | 说明 |
| --- | --- | --- | --- | --- | --- |
| 编码 | 无 | ≤ 5 ms | ≤ 5 ms | ≤ 5 ms | 无 B 帧、切片编码、帧内刷新 |
| 传输 | 线路级 | ≤ 2 ms | ≤ 5 ms（p95） | 依网络，待测 | 蜂窝时延波动最大 |
| 解码 | 无 | ≤ 5 ms | ≤ 5 ms | ≤ 5 ms | 视芯片硬解能力 |
| 重投影 + 显示 | ≤ 5 ms | ≤ 5 ms | ≤ 5 ms | ≤ 5 ms | XREAL 宣称约 3 ms，未见独立实测 [S20](sources.md#s20) |
| **头动感知延迟** | 由本地追踪 + 重投影决定 | 同左 | 同左 | 同左 | 与网络延迟解耦，叠加内容不随网络抖动漂移 |

【项目判断】以上只是拆账用的设计目标。测试方法：高速相机或光电传感器测运动到光子；内容延迟测 p50 / p95（每组 ≥ 30 样本）；30 分钟连续运行看 p95 漂移和温度降频；蜂窝链路在强弱信号下分别测。

### 3.6 眼镜端能力要求（含视频通话）

| 能力 | 要求 | 状态 |
| --- | --- | --- |
| 6DoF 追踪 | 追踪摄像头 + IMU，本地运行 | 待选型 |
| 手势交互 | 本地手部追踪；注视交互不在当前版本 | 待选型 |
| 视频解码 | 硬件 H.265 必选；AV1 优先 | 依芯片核实 |
| DP 输入 | A1 模式需 DP 接收与显示桥接 | 待选型 |
| 显示 | **双目光波导**，视场 30–50°（以光机与波导组合定案）；分辨率以所选光机为准（待定，M1 定案）；入眼亮度目标约 4000 尼特以满足户外可读【公开资料】[S52](sources.md#s52)；刷新率 60 Hz 起，显示处理器可补帧到 90 Hz 以上（待光机确认） | 主选几何反射式（阵列）光波导；备选衍射式（待调研） |
| 无线 | Wi-Fi 7 优先，蓝牙 5.3 | AR1+ / AR2 平台公开支持 Wi-Fi 7 [S17](sources.md#s17)[S18](sources.md#s18) |
| 机身蜂窝 | 满足串流最低网络要求（第 6.3 节），eSIM / SIM | 见第 6 节 |
| 通话摄像头 | 前向主摄支持 1080p30 起实时编码上行，带防抖；本地录像可更高 | 待选型 |
| 通话音频 | 多麦克风波束成形、降噪、回声消除；开放式扬声器；蓝牙耳机可选 | 待选型 |
| 眼动摄像头 | 当前版本只做预留、不装配：前框结构空间、柔性板走线与连接器、主 SoC 侧 MIPI 接口与电源域 | 预留 |

【项目判断】**光波导的代价要写清楚**：光波导当前视场明显小于已放弃的 birdbath 方案，虚拟屏面积会变小，“Quest 级大屏观影”体验会下降；换来的是前框更轻、更透，更符合“佩戴无感”（决定 #18/#19）。这是需求方已接受的取舍（决定 #21）。

### 3.7 视频通话与会议（拉满）

需求方确认：视频通话能力要拉满，包括投屏视频，**体验像正常手机视频电话、视频会议一样**。

**能力清单**

| 能力 | 做法 | 说明 |
| --- | --- | --- |
| 看对方 | 来电视频和会议画面作为虚拟屏锚定在空间里，可放大、多人宫格 | 走串流或本地解码 |
| 让对方看到我所见 | 眼镜前向摄像头作为通话摄像头（第一人称视角） | 适合远程协作、指导 |
| 让对方看到我本人 | **默认使用虚拟形象**（需求方确认），见第 3.8 节；也可手动切换为主机摄像头 | 眼镜看不到佩戴者的脸 |
| 共享画面 | 共享眼镜里的任一虚拟屏，或“真实画面 + 叠加内容”的合成画面 | 即“投屏视频” |
| 语音 | 波束成形麦克风 + 降噪 + 回声消除；静音、音量、耳机切换 | 开放式扬声器需防漏音 |
| 会议控制 | 接听、挂断、静音、切摄像头、举手，均可用手势、语音、按键完成 | — |

**三种通话接入方式（覆盖所有通话软件）**

| 方式 | 原理 | 覆盖 | 依据 |
| --- | --- | --- | --- |
| **V1 主机通话（兼容任何通话软件）** | 通话软件（微信、腾讯会议、Teams、Zoom 等）在 PC 上运行（手机上的通话软件一般不能选外接虚拟摄像头，手机主路为 V2 / V3，见[技术路线](technical-roadmap.md)第 2.2 节），画面经 L0 虚拟显示器到眼镜；**眼镜摄像头和麦克风注册为主机的摄像头和麦克风** | 主机上能跑的全部通话软件，不需要软件适配 | 有线时眼镜可作为标准 USB 摄像头（UVC），Linux USB gadget 已有 UVC 功能实现【公开资料】[S30](sources.md#s30)；无线时由主机端虚拟摄像头 / 虚拟音频驱动接收 |
| **V2 眼镜独立通话** | 眼镜本地运行 WebRTC 通话客户端，直接经蜂窝或 Wi-Fi 通话，不需要主机 | 自研通话、远程协作、支持网页接入的会议 | WebRTC 为开源实时音视频框架【公开资料】[S31](sources.md#s31) |
| **V3 云端通话** | 通话软件在云端主机运行，经蜂窝串流到眼镜，眼镜摄像头和麦克风回传云端 | 离开本地主机时使用任意通话软件 | 依赖云主机与上行带宽 |

**设计目标（待实测）**

- 上行视频：1080p30 起，弱网自动降到 720p / 480p 保持流畅；音频优先于视频。
- 口到耳延迟和画面延迟按主流视频通话体验设定，具体阈值需结合实测基线确定。
- 通话与串流、6DoF 同时运行（解码 + 编码 + 追踪 + 蜂窝上行并发）时不降频、不过热——**这是整机最重的负载，必须作为验收主场景**。

### 3.8 虚拟形象（通话中代表“我本人”）

需求方确认：通话中对方看到的“我本人”使用**虚拟形象**（决定#13 保留）。

【项目判断】眼镜看不到佩戴者的脸，所以虚拟形象要靠眼镜能采到的信号来驱动。当前版本（完全版样机 M2 及 M3）不用眼动，改为**语音驱动口型与表情 + IMU / 6DoF 头部姿态**：

| 驱动信号 | 来源 | 驱动什么 |
| --- | --- | --- |
| 口型与表情 | **语音驱动**：由通话音频推算口型和情绪 | 嘴部、下半脸表情 |
| 眼神、眨眼 | 语音驱动模型或程序化动画补足；眼动摄像头仅预留，当前版本不装配 | 眼神、眨眼、部分眉部动作 |
| 头部姿态 | 6DoF 追踪 / IMU | 点头、转头 |
| 手势 | 手部追踪 | 挥手、比划（可选） |

眼动追踪（向内眼动相机 + 红外补光）在当前版本只做预留：前框结构空间、柔性板走线与连接器、主 SoC 侧 MIPI 接口与电源域；软件只保留接口定义，不开发。注视交互不在当前版本；眼动作为后续版本选配，届时再启用预留接口。

链路：

1. **建模**：首次使用时用手机摄像头扫描或选择形象模板，生成用户本人的虚拟形象；只允许用本人的形象或卡通形象，不允许用他人形象。
2. **驱动**：眼镜上传头部姿态等轻量参数，音频照常上传；当前版本不采集、不上传眼动参数。
3. **渲染**：在主机或云端 GPU 上渲染虚拟形象，输出为一路视频：V1 模式注册为主机的虚拟摄像头，V2 / V3 模式作为通话的视频轨。
4. **标识**：画面角标注明“虚拟形象”，避免被误认为真人画面。

公开参照：NVIDIA 已于 2025 年开源 Audio2Face（语音驱动口型与情绪）SDK，为 C++ / CUDA 实现，需在带 NVIDIA GPU 的主机或云端运行；许可条款未经本项目核实【公开资料】[S32](sources.md#s32)。

**边界与代价**：语音驱动的表情不等于真实表情，眼神和眨眼只能靠语音驱动模型或程序化动画补足，效果有限；眼动摄像头当前版本不装配，相关功耗、重量和隐私处理留到后续版本（启用时眼部图像仍只在本地处理）；没有可用 GPU 主机或云时，降级为静态头像 + 口型动画。

**边界**：通话软件的端到端加密、账号、录制和第三方平台规则由各软件自身决定；V1 依赖主机能识别虚拟摄像头和虚拟麦克风，个别软件可能限制虚拟设备，需要按清单实测。

### 3.9 显示模式与小脑调度（决定 #23，2026-11-04）

**典型流程**：用户说“打开 QQ” → 小脑立即本地弹气泡“正在打开 QQ”（≤0.1 s，条件反射【设计目标】）→ 脑把请求派给手机这只手 → 手机后台打开 QQ、生成 QQ 看板（手渲染）→ 小脑把气泡就地变形为 QQ 看板 → 用户说“看张三那条 / 回他……”看板更新 → 用户说“我来操作”才切到投屏（接管）。

**六种显示模式**

| 模式 | 内容谁产出 | 谁画上屏 | 何时出现 | 链路 |
| --- | --- | --- | --- | --- |
| **看板** | 手产出内容与版式；小脑决定位置和大小 | 小脑按“看板描述”光栅化；描述表达不了时显示手发来的图片 | 打开应用、查信息时的主要形态 | BLE（描述 / 控制）；图片兜底走 Wi-Fi |
| **气泡**（看板的一种） | 小脑或手 | 小脑 | 正在打开、进度、通知、确认；自动消失 | BLE |
| **图片** | 手（聊天图片）或眼镜摄像头 | 小脑解码显示 | 聊天图片、拍摄回看 | Wi-Fi（手发来的图片）；摄像头图片本地处理 |
| **视频**（就是视频） | 手编码 | 小脑解码 | 播放视频、会议共享视频 | Wi-Fi 或蜂窝 |
| **投屏** | 手渲染整块应用画面（手上为眼镜开的虚拟显示） | 小脑贴进视野 | **只在用户要求接管时出现**；可直接操作；付款、密码等安全页显示黑屏并提示到手机上处理 | Wi-Fi（有线 A1 即有线投屏） |
| **实时拍照** | 眼镜摄像头 | 小脑本地画 | 取景、拍照；不联网；可把帧交给脑识别 | 本地，不上网 |
| **视频通话** | 摄像头和麦克风上行、对方画面下行；虚拟形象由有 GPU 的手渲染（PC 优先，其次云） | 小脑排布 | 来电、去电、会议 | Wi-Fi 或蜂窝 |

表中“气泡”是“看板”的子形态，不另算一种；六种模式为看板（含气泡）、图片、视频、投屏、实时拍照、视频通话。

**小脑调度规则**

- **同屏数量**：最多 1 个主显示 + 最多 2 个气泡（30–50° 视场）【设计目标】。
- **优先级**：视频通话 > 投屏（接管）> 视频 > 实时拍照 > 看板 > 气泡。高优先级来时，低优先级缩到边上或收成气泡。
- **就地变形**：气泡 → 看板 → 投屏就地变形，不关一个再开一个。
- **行走安全**：检测到行走时，主显示缩小并移到边缘，不遮挡前方。
- **焦点跟语音走**：说到哪张，哪张到前面。
- **交互参考**：“Muse 那样的交互逻辑”具体指什么，需求方尚未说明；本节不猜测、不据此设计，列入第 10 节“仍待确认”。

【项目判断】这套调度的关键是把“立刻有反馈”和“重内容稍后到”分开：气泡由小脑本地画，不等网络；看板由手产出、小脑按描述画；投屏是用户明确接管后的形态，不默认打开。这样既保住条件反射的时延，又避免眼镜承担重渲染。

### 3.10 手的统一接入（以手机这只手为主，决定 #22、#24）

手机是主要的手之一：它跑着用户日常的应用，也最适合在后台打开应用、读屏、生成看板。PC、车机、云主机按同一套“手协议”接入，只是能力位和渲染内容不同。

**参考项目**（[S57](sources.md#s57)、[S58](sources.md#s58)，2026-11-04 读源码评估；能力未在本项目复现）

| 项目 | 许可 | 可用能力 | 本项目用法 |
| --- | --- | --- | --- |
| **Mika** | Apache-2.0，Kotlin | 用虚拟显示后台操作、无障碍树读屏、目标化输入注入、统一执行入口（守卫 → 锁屏检查 → 不可逆检查 → 确认）；提供远程 MCP / REST 任务接口（发目标、查状态、等待、回答、引导、取消）；远程发起的任务不能批准付款和确认；局域网监听接受私网地址；自建中转经 WSS 外连，TLS 在网关终止、不是端到端加密；**没有蓝牙**，其 Channel 接口可挂一个“眼镜通道” | **主选参考**：改造为手机这只手的执行端，挂“眼镜通道”接 BLE |
| **dsh-Go** | AGPL-3.0 | 低层工具只在本机 127.0.0.1 / unix socket 提供；默认操作主屏；确认偏保守 | **只作参考**，不作为主选依赖 |

**控制面与视频面分开**（与第 4.3 节一致）：

| 通道 | 承载 | 用途 | 说明 |
| --- | --- | --- | --- |
| **BLE** | 控制面，低功耗常连 | 发意图、气泡、看板描述 | 主 SoC 睡着时由 MCU 收；见第 5.4、6.2 节 |
| 蓝牙 PAN 或 Wi-Fi 局域网 | Mika 的局域网接口 | 任务下发、状态查询、较大的看板描述 | 必要时使用；局域网监听只接受私网地址 |
| Wi-Fi | 视频面 | 视频、投屏 | 不把视频塞进 BLE |

**安全边界**【项目判断】：

- **发消息前也要在眼镜上确认**。Mika 的 ask 模式只在付款前问，不够；发消息、发文件、删除等不可逆动作都要在眼镜上出现确认。
- **远程发起的任务不能批准付款和确认**；付款、密码页只在手机上完成，眼镜上不渲染、不采集、不转发。
- 自建中转的 TLS 在网关终止，不是端到端加密；传输敏感内容时要在协议层另加保护，或明确告知用户边界。
- dsh-Go 只在本机回环 / unix socket 提供工具，默认操作主屏、确认偏保守，这些做法可借鉴，但不直接把 AGPL 代码并入主选链路。

### 3.11 多路信号与并发（小脑同时处理多少路）

眼镜同一时刻会有很多路信号：视频（投屏、视频、通话下行）、相机（两路追踪、主摄）、音频（麦克风阵列、通话下行、提示音、媒体）、传感（IMU、姿态上行）、控制（BLE 意图 / 气泡 / 看板描述、手协议任务）。这一节规定小脑怎么同时处理它们、脚怎么同时运送它们。【项目判断】，具体路数与带宽待 M1 按所选芯片实测。

**信号分类与去向**

| 信号 | 典型路数 | 谁产出 | 小脑怎么处理 | 走哪条脚 |
| --- | --- | --- | --- | --- |
| 视频（投屏 / 视频 / 通话下行） | 主显示 1 路实时视频 | 手编码 | 主 SoC 硬解 → 合成 → 显示处理器扭曲上屏；A1 有线原始画面不解码 | Wi-Fi、蜂窝、有线 |
| 看板、气泡、图片 | 最多 2 个气泡 + 若干缓存看板 | 手发描述或图片；小脑本地画 | 本地光栅化成图层，不占视频解码 | BLE、Wi-Fi |
| 追踪相机 | 2 路 | 眼镜 | 6DoF 与手势，本地处理，不上传画面 | 不出眼镜 |
| 主摄 | 1 路 | 眼镜 | 一次采集多处使用：取景显示、交给脑识别、通话上行编码 | 本地；上行走 Wi-Fi / 蜂窝 |
| 麦克风阵列 | 1 组 | 眼镜 | MCU 常驻听唤醒词；醒来后主 SoC 接管做波束成形、降噪、回声消除 | 上行走 Wi-Fi / 蜂窝；V1 时作为主机麦克风 |
| 下行音频 | 通话、助手回复、提示音、媒体 | 手或脑 | 小脑混音：通话 > 助手回复 > 提示音 > 媒体，高优先级来时低优先级压低音量 | Wi-Fi、蜂窝、BLE（蓝牙耳机） |
| IMU / 姿态 | 1 路高频 | 眼镜 | 同时给显示处理器（重投影）和主 SoC（6DoF）；姿态上行给手做预测渲染 | 不可靠小包，Wi-Fi / 蜂窝 |
| 控制 | 多只手同时 | 脑、手 | 手协议任务与看板描述按任务 ID 区分来源 | BLE、局域网、WSS |

**并发规则**

1. **实时视频只解 1 路全帧率**：只有主显示（第 3.9 节的 1 主）是全帧率实时视频。被高优先级挤到边上或收成气泡的视频，由手改发低帧率缩略图，走看板 / 图片通道，不占第二路全帧率硬解。具体能同时硬解几路，按主 SoC 规格在 M1 核实，见[技术路线](technical-roadmap.md)第 1.1 节门禁 4。
2. **多屏打包成一路**：PC 同时开多块虚拟屏时，手把多块屏打包进一路视频（分块排布，附带每块的位置信息）；小脑解一路，再拆成多个图层分别锚定、分别重投影。多块屏不变成多路解码。
3. **多人通话由手合成**：多人宫格由主机或云端合成成一路下行视频；眼镜只解一路。
4. **一次采集多处使用**：主摄画面在主 SoC 内复制给取景、识别、通话编码三个用途，不重复打开相机。
5. **多只手可以同时连，视频会话同一时刻只有一个**：BLE 常连手机、Wi-Fi 连 PC、蜂窝连云端 LLM 可以同时存在；视频面只服务当前主显示的那只手，其余手的视频会话暂停，切回时等关键帧恢复（第 4.1 节串流纪律）。
6. **脚的带宽按优先级分**：控制面与姿态 > 音频 > 通话视频 > 投屏 / 视频 > 同步上传。Wi-Fi 下用 WMM 优先级队列，蜂窝下按承载与码率自适应；视频突发不得拖慢控制面（第 4.3 节）。
7. **最重负载**：主显示视频解码 + 通话上行编码 + 两路追踪 + 主摄 ISP + 蜂窝上行同时运行，就是第 3.7 节说的整机验收主场景。

---

## 4 目标二：通过投屏转化算法兼容尽可能多的软件

### 4.1 “特殊投屏算法”（需求方确认：基本正确）

本项目所说的“特殊投屏算法”是以下组合，而不是某一种编码格式：

1. **主机侧渲染 + 视频 + 眼镜薄解码**：主机把内容画到一块虚拟画布，硬件编码后推给眼镜，眼镜只负责解码显示。
2. **串流纪律**：画面只保留最新一帧；同时只有一块数据在传；对端忙就丢帧而不是排队；回执逐项核对累计值；采集、编码、发送、解码、上屏分别计数，不把“已发送”当成“已显示”；断流时不显示花屏，等关键帧再恢复。
3. **ROI 局部放大**：在原始分辨率上先裁剪再缩放，让小屏也能看清局部内容。
4. **语义转化（主）+ 像素转化（兜底）**：能读到界面结构的应用，把内容重新排版成适合眼镜的卡片；读不到的再用画面捕获 + 裁剪 + 对比度适配。
5. **矢量与画面分开**：导航、字幕、状态等结构化数据单独传，由眼镜本地绘制，视频断开时仍能显示。这与第 3.9 节的“看板描述”是同一条思路：手只发结构化描述，小脑本地光栅化，不把整屏像素当默认通路。

### 4.2 兼容分层

“兼容所有软件”最有效的做法不是逐个适配应用，而是**在操作系统显示层接入**：主机系统把眼镜当成一台显示器，任何能在这台显示器上显示的软件就自然兼容。

按决定 #23，兼容分层与显示模式的对应关系是：**L0 虚拟显示器 = 投屏（接管）**，只在用户要求接管时出现；**L3 语义转化 = 看板**，手把界面结构转成看板描述，小脑按描述画；**L4 像素转化 = 看板的兜底**，描述表达不了时手直接发图片或低码率画面。

| 层 | 方法 | 覆盖范围 | 开源参考 | 边界 |
| --- | --- | --- | --- | --- |
| **L0 系统级虚拟显示器（主路，对应投屏 / 接管）** | Windows 间接显示驱动（IddCx）；Linux 合成器 / Vulkan 层；Android VirtualDisplay / 屏幕捕获；Mac 系统扩展显示 | 所有桌面与普通应用，含多窗口、多屏 | Windows 虚拟显示驱动 [S27](sources.md#s27)；Breezy Desktop / XRLinuxDriver [S28](sources.md#s28) | 只在用户要求接管时贴进视野；DRM / HDCP 内容、安全窗口不可捕获；驱动签名与系统版本 |
| **L1 OpenXR / 空间应用** | 主机运行 OpenXR 运行时，眼镜作为显示与追踪端 | 空间应用、3D 内容 | ALVR、WiVRn [S24](sources.md#s24)[S25](sources.md#s25) | 光学透视下的显示效果与 VR 头显不同 |
| **L2 标准投屏 / 车机协议** | 眼镜作为接收端 | 手机生态的地图、音乐、语音 | 此前调研的车机接收端开源实现 | 协议授权、认证硬件和厂商条款须另行确认；本仓库不提供这类实现 |
| **L3 语义转化（对应看板）** | 读应用界面结构，重排为眼镜看板；默认发“看板描述”，由小脑光栅化 | 消息、文章、通知、列表 | 无障碍界面树读取思路 | 需用户授权；规则随应用更新失效；不做未经确认的自动操作 |
| **L4 像素转化（看板的兜底）** | 看板描述表达不了时，画面捕获 + ROI + 对比度适配 + 低码率编码，或直接发图片 | L3 读不到的图片、小程序等 | 第 4.1 节串流纪律 | 低带宽兜底；受安全窗口限制；付款、密码等安全页仍按第 3.9 节黑屏 |

【项目判断】由于第 3 节以空间交互为核心，L0 的虚拟显示器在眼镜里不是固定在眼前，而是**作为虚拟屏幕锚定在真实空间**（如摆在桌面上方），可以多屏摆放。投屏是“接管”形态，不能默认打开；用户不接管时，优先用看板而不是整块应用画面。兼容率按“软件类别清单 + 实测通过率”衡量；DRM 保护内容、反作弊、仅限特定硬件的软件属于已知边界，不承诺可用，也不绕过。

### 4.3 自研串流协议要点（开放）

- 会话握手带能力位（分辨率、刷新率、编码格式、追踪模式），并做时钟同步。
- 控制面与视频面分离：视频断开时，按键、模式切换、诊断仍可走控制通道。
- 视频面“最新帧优先 + 关键帧恢复 + 自适应码率”；Wi-Fi 与蜂窝下按 p95 延迟动态降分辨率或帧率。
- 姿态数据单独上行，供主机做预测渲染。
- 诊断以 JSON 记录各环节计数与时间戳，不保存画面内容。

### 4.4 云服务：全开放，可用官方，也可自建

需求方确认：云服务**全开放**，用户可以用官方云，也可以自己搭建。

【项目判断】设计原则：

- **协议公开**：串流协议、同步接口、通话信令、设备管理、小程序分发的接口规范全部公开文档化。
- **服务端可自建**：提供可自行部署的参考服务端（容器镜像），功能与官方云同构；眼镜在设置里填写服务器地址即可切换，不锁定官方云。
- **组件可替换**：通话可接开源实时音视频服务（如 LiveKit，Apache-2.0）【公开资料】[S33](sources.md#s33)；同步可接 WebDAV / S3 兼容存储；云串流主机可用任何能跑串流服务端的 GPU 机器。
- **账号与数据**：官方云与自建服务端使用同一套开放身份接口；数据存放位置由用户选择，官方云不得成为使用眼镜的前提。

| 服务 | 官方云 | 自建 |
| --- | --- | --- |
| 云串流主机 | 提供 | 任意 GPU 主机 + 开源串流服务端 |
| 视频通话（V2 / V3） | 提供 | 自建实时音视频服务 |
| 虚拟形象渲染 | 提供 | 自有 GPU 主机 |
| 离线内容同步 | 提供 | WebDAV / S3 / 局域网主机 |
| 小程序分发 | 官方商店 | 企业或个人私有源（需签名） |

### 4.5 投屏处理链路（接管时小脑做什么）

投屏是用户要求“我来操作”时才出现的形态（第 3.9 节）。【项目判断】从手到眼睛的完整链路：

| 环节 | 在哪做 | 做什么 | 角色 |
| --- | --- | --- | --- |
| 1 画面产生 | 手 | 为眼镜开一块虚拟显示（L0），按眼镜的分辨率与刷新率渲染；多块屏打包成一路（第 3.11 节） | 手 |
| 2 编码与发送 | 手 | 硬件编码，最新帧优先、切片编码、帧内刷新（第 3.5、4.1 节） | 手 |
| 3 运送 | 脚 | A1：DP 原始画面；A2：USB 3；B：Wi-Fi；C：蜂窝 | 脚 |
| 4 接收与解码 | 小脑（主 SoC） | 解包、硬解；A1 原始画面不解码，直接进显示处理器 | 小脑 |
| 5 局部放大与适配 | 小脑 | ROI 先裁剪再缩放；对比度适配光波导（第 4.1 节） | 小脑 |
| 6 合成 | 小脑 | 投屏作为一个图层锚定在空间里，与气泡、状态等图层合成；安全页按第 3.9 节黑屏 | 小脑 |
| 7 重投影上屏 | 小脑（显示处理器） | 按最新姿态扭曲、畸变与色差校正、补帧，送光波导 | 小脑 → 视网膜 |
| 8 操作回传 | 小脑 → 脚 → 手 | 手势指针、点击、滚动、键盘文字、语音命令转成输入事件，带时间戳经控制面回传；有线时眼镜也可作为标准 USB HID 设备；手在虚拟显示上注入输入 | 小脑、脚、手 |

**两条要特别写清的**：

- **A1 有线时的叠加**：A1 下主 SoC 可以睡（A1-3DoF），DP 画面直接进显示处理器。此时气泡、状态卡由 MCU 或主 SoC 作为叠加层送给显示处理器，显示处理器至少要能把“DP 画面层 + 1 个叠加层”合成后再扭曲上屏，否则 A1 时气泡无法出现。
- **操作回传**：投屏能直接操作的前提是输入能回到手。输入事件走控制面（可靠、低延迟），不走视频面；指针位置按眼镜看到的那一帧的坐标换算回虚拟显示坐标。操作回传延迟阈值待定（M1 定案）。

---

## 5 目标三：强睡眠能力（已确认：低功耗待机 + 快速唤醒）

### 5.1 分级功耗状态（设计目标）

| 状态 | 主处理器 | 协处理器 | 机身蜂窝 / Wi-Fi | 唤醒条件 | 设计目标 |
| --- | --- | --- | --- | --- | --- |
| S0 全功能 | 工作 | 工作 | 连接 | — | 由串流负载决定 |
| S0' 手表模式 | 关闭（拍录像时按需唤醒） | 工作 | 周期性尝试联网 | — | 续航以天计（待定） |
| **S0'' 看板态**（新增，决定 #24） | **低功耗活跃**：只做“按描述画卡片 + 重投影”，降刷新率、关解码、关追踪；只有气泡时交给 MCU，主 SoC 可睡 | 工作，BLE 常驻 | BLE 保持；Wi-Fi / 蜂窝按需 | 看板更新、气泡、用户操作 | 只看板时优先于 S0；功耗待 M1 实测 |
| S1 浅睡（摘下 / 熄屏） | 低功耗活跃（关屏、停解码、停追踪），控制连接由 Wi-Fi 芯片保活或蜂窝模组维持 | 工作 | 保持连接 | 戴上、触摸、按键 | 戴上后画面恢复 **≤ 1 s**（待实测） |
| S2 待机 | 挂起到内存 | 只跑佩戴检测、IMU、唤醒词 | 蜂窝 eDRX / PSM；Wi-Fi 关闭或低功耗 | 戴上、唤醒词、消息推送 | 待机功耗以整机实测为准 |
| S3 深睡 / 运输 | 关闭 | 只留实时时钟 | 关闭射频 | 长按或充电 | 存放数周仍有电（待定） |

### 5.2 技术要点

- **协处理器常驻**：佩戴检测、抬头动作、唤醒词、时钟和手表模式都在协处理器上，主处理器不醒也能判断“要不要醒”。
- **分电源域**：显示、解码、追踪摄像头、Wi-Fi、蜂窝分别断电。
- **会话保持**：S1 时主处理器不完全挂起，控制连接由 Wi-Fi 芯片的网络卸载 / 保活或蜂窝模组维持；串流服务端保留会话和最后一帧；眼镜醒来先显示缓存帧，再重连、等新关键帧；超过保活时间则断开重连（见 [技术路线](technical-roadmap.md) 第 1.9 节）。
- **脚也要睡**（决定 #25）：蜂窝、Wi-Fi、BLE 的待机电流决定待机续航。
- **蜂窝节能**：依赖模组和运营商对 eDRX / PSM 的支持。公开论坛中已有用户反映某 RedCap 模组未进入 eDRX、休眠电流偏高，且厂商未公布 eDRX 电流【公开资料·用户反馈，未经本项目复现】[S23](sources.md#s23)。**机身蜂窝是待机功耗的最大风险，选型前必须实测休眠电流。**
- **系统策略**：自研串流服务须加入后台白名单，避免熄屏断网或后台服务被杀；验收必须覆盖这一点。

### 5.3 续航：至少 8 小时

需求方确认：续航**至少 8 小时**。

**公开参照**：Meta Ray-Ban Display 镜框电池 960 mWh，官方标称混合使用最长约 6 小时（另有充电盒补电）【公开资料】[S34](sources.md#s34)。它的功能远轻于本方案（无 6DoF、无持续串流、无机身蜂窝）。

**功耗预算（项目估算，假设值待实测）**：

| 使用状态 | 假设整机平均功耗 | 8 小时所需电量 |
| --- | --- | --- |
| 手表模式 | 约 0.05–0.1 W | 约 0.4–0.8 Wh |
| 轻度联网（通知、语音、间歇显示） | 约 0.3–0.5 W | 约 2.4–4 Wh |
| 全功能（串流 + 6DoF + 无线） | 约 1.5–3 W | 约 12–24 Wh |
| 全功能 + 视频通话 + 蜂窝上行 | 约 2.5–4 W | 约 20–32 Wh |

【项目判断】结论很直接：**只靠眼镜机身电池，做不到“连续 8 小时全功能”**——所需电量是 Ray-Ban Display 镜框电池的十几到三十几倍，重量和发热都不允许。要满足“至少 8 小时”，需要按下面的方式组合：

| 方案 | 做法 | 8 小时含义 | 代价 |
| --- | --- | --- | --- |
| **P1 机身混合使用 8 小时（推荐作为默认无线指标）** | 机身电池按 5–7 Wh 设计（第 7.2 节，续航优先）；协处理器常驻、主处理器按需唤醒 | 典型一天：约 1–2 小时全功能串流 / 通话 + 其余为轻度联网和手表模式 | 机身重量上升，需结构验证 |
| **P2 镜腿热插拔电池** | 两侧镜腿电池可更换，内置小电池维持更换期间不断电 | 换 1–2 次电池后达到 8 小时全功能 | 需携带备用电池；结构复杂 |
| **P3 线控模块 / 口袋电池** | 接线控模块（大电池）后连续全功能 | 连续 8 小时全功能 | 有线，非默认无线形态 |
| **P4 主机供电** | 有线 A1 / A2 模式由主机供电 | 接主机期间不耗电池 | 仅限有线场景 |

**需求方已确认（2026-11-03）：8 小时按 P1“机身混合使用”计算**，作为默认无线形态的续航验收指标。P2 换电、P3 线控模块作为“连续全功能”的补充方案保留。

**P1 验收用的混合使用剖面（需求方已认可，冻结为续航验收条件）**：

| 时段 | 状态 | 时长 |
| --- | --- | --- |
| 串流使用（虚拟屏办公 / 观影，Wi-Fi） | 全功能 | 1 小时 |
| 视频通话 / 会议（含虚拟形象，蜂窝或 Wi-Fi） | 全功能 + 上行 | 0.5 小时 |
| 6DoF 叠加交互（指引、标注） | 全功能 | 0.5 小时 |
| 通知、语音助手、间歇显示 | 轻度联网 | 3 小时 |
| 拍照、录音、看时间 | 手表模式 | 1 小时 |
| 佩戴待机 / 摘下浅睡 | S1 / S2 | 2 小时 |

按第 5.3 节功耗假设逐行相加（S1 / S2 按 0.05–0.1 W 计），该剖面约需 **4.5–8.3 Wh**（v0.7.2 改正：此前写的“4–6 Wh”算错）。机身电池按续航优先取 5–7 Wh（第 7.2 节），只有整机功耗落在假设区间中下段时才够；[技术路线](technical-roadmap.md) 第 1.9 节据此给出约 5.9 Wh 的功耗预算，实测超出则先压功耗、再把电池加到 8–10 Wh。**仍须靠整机实测和功耗优化确认**；若实测不足，优先压缩全功能时长或降低显示刷新率，而不是放宽 8 小时指标。 若需求是“纯无线、不换电、连续 8 小时全功能”，以当前公开的电池和芯片水平没有证据支持，需要降低全功能负载（如降低刷新率、关闭 6DoF、缩短串流时长）才能接近。

### 5.4 看板态低功耗通路（决定 #24，2026-11-04）

新增一条以看板为主的低功耗通路：

- **只看板**：主 SoC 只做“按描述画卡片 + 重投影”，降刷新率、关解码、关追踪；显示仍走显示处理器 / 光波导。
- **只有气泡**：走 MCU 现有低速显示通路，主 SoC 可睡；气泡由小脑或手产出，MCU 直接上屏。
- **看板 + 气泡**：主 SoC 进看板态，MCU 保持 BLE 常驻；两者按第 3.9 节的 1 主 + 2 气泡规则合成。
- **BLE 常驻**：手机这只手的气泡与看板描述主要走 BLE，主 SoC 睡着时也要收得到；A 案由外加小 BLE 芯片承担，B 案由 BES2800BP 自带蓝牙承担（第 6.2 节）。

【项目判断】这条通路的意义是：看板预计会成为使用时长最长的形态，如果每次看板更新都唤醒主 SoC、开解码和追踪，8 小时续航很难成立。看板态把“画卡片 + 重投影”留在低功耗域，是决定 #24 里对功耗影响最大的一处。做成 M1 测试项，具体功耗和时长待 M1 实测。

**边界**：BLE 气泡和看板态属于联网全功能或待机通路，不自动算进手表模式。断网但手机经 BLE 可达时，是否让手机代为联网，列入第 10 节待确认；确认前不把 BLE 气泡写成手表模式功能。

### 5.5 新使用剖面（待 M1 定案）

决定 #24 要求按新的使用方式重算功耗剖面。**第 5.3 节已算好的旧剖面数字不改**，继续作为已认可的基线；下表是替代候选，M1 定案后再替换。

| 使用状态 | 相对旧剖面 | 预计时长 | 平均功耗 | 说明 |
| --- | --- | --- | --- | --- |
| 看板（含气泡） | 新增，预计时长最多 | 待定（M1 定案） | 待定（M1 定案） | 手发描述、小脑光栅化；只看板走看板态 |
| 实时拍照 / 识别 | 新增 | 待定（M1 定案） | 待定（M1 定案） | 摄像头上行 + ISP；短时使用 |
| 气泡待机 | 新增 | 待定（M1 定案） | 待定（M1 定案） | 仅 MCU + 低速显示，主 SoC 睡 |
| 串流 / 视频 | 调低 | 待定（M1 定案） | 待定（M1 定案）；旧预算上限仅作对照 | 视频不再是主要场景 |
| 视频通话 / 会议 | 保留 | 待定（M1 定案） | 待定（M1 定案） | 仍是最重负载之一 |
| 6DoF 叠加、轻度联网、手表模式、S1 / S2 | 保留 | 待定（M1 定案） | 待定（M1 定案） | 口径同旧剖面 |

【项目判断】**替代关系与结论**：新剖面用于 M1 的功耗预算和 MCU A/B 评估；在 M1 定案前，旧剖面仍是续航验收口径。**5–7 Wh 是否够，要按决定 #19（续航优先）用新剖面重新核算**，结论待 M1；不足时先压功耗，再按第 7.2 节把电池加到 8–10 Wh，不直接放宽 8 小时指标。

---

## 6 芯片组合

【项目判断】按“主处理器（联网全功能）+ 低功耗协处理器（手表模式与睡眠）+ 机身蜂窝 + 可选模块 5G”四块评估。落地选型（含新增的显示与重投影处理器、主选 / 备选与切换条件）见 [技术路线](technical-roadmap.md) 第 1 节。

决定 #24 不改四芯片骨架，只改 MCU 侧的连接与音频：A 案在 MCU 外再加一颗小 BLE 芯片，框图按“四颗主芯片 + 1 颗小 BLE”表示；B 案改用 BES2800BP，蓝牙在片内。两种方案都要满足“主 SoC 睡眠时，BLE 送来的气泡 ≤0.1 s 上屏【设计目标】”这条闸门。

### 6.1 主处理器候选

| 候选 | 已核实的公开信息 | 判断 |
| --- | --- | --- |
| **Snapdragon AR2 Gen 1** | 多芯片分布式（AR 处理器 + 协处理器 + 连接芯片），4 nm；Wi-Fi 7，宣称眼镜—主机持续延迟 < 2 ms；与手机或 PC 分担计算。[S17](sources.md#s17) | **最贴合“本地追踪 + 主机渲染”**，优先询价。无蜂窝；内存、显示规格、开发者可获得的 BSP 需询证。 |
| **Snapdragon AR1+ Gen 1** | Wi-Fi 7、蓝牙 5.3；每眼最高 1280×1280 @ 60 Hz；双 ISP；端侧小模型。[S18](sources.md#s18) | 轻量方案；60 Hz 与 6DoF 能力对本方向偏弱，需确认。 |
| **Snapdragon XR2 Gen 2 / XR2+ Gen 2** | XR2+ Gen 2 公开每眼最高 4.3K、Wi-Fi 7、全彩透视 12 ms。[S21](sources.md#s21) | 头显级，适合**参考样机**验证 6DoF 交互，不适合轻量眼镜本体。 |
| **显示 / 空间计算专用芯片路线** | XREAL One 系列以自研 X1 芯片做姿态预测、显示稳定和畸变校正，USB-C DP 输入。[S20](sources.md#s20) | 证明 DP 有线 + 眼镜端重投影可行；X1 为厂商自用，需找可采购的同类方案。 |
| W527 / W5 系列 | LTE、1080p30 编解码级别。[S1](sources.md#s1)[S2](sources.md#s2) | 视频能力不足以支撑强串流，不作为主处理器；W5+ 的协处理器思路可借鉴。 |
| Wear Elite | 公开支持 LTE 与 RedCap。[S9](sources.md#s9) | 若希望蜂窝与主处理器集成可跟踪；视频与 6DoF 能力待核实。 |

### 6.2 协处理器候选（手表模式与睡眠）

| 候选 | 已核实的公开信息 | 判断 |
| --- | --- | --- |
| STM32N657（A 案） | M55 MCU，4.2 MB SRAM，ISP 与 H.264；**无无线射频**。[S12](sources.md#s12) | 能覆盖拍照、录像、录音和小程序，保留已论证的拍录像通路；需**外加一颗小 BLE 芯片**才能常驻收手机气泡 / 看板描述，代价是多一颗芯片；需验证与主处理器共享摄像头的方案。 |
| BES2800BP（B 案） | 双 M55 + 双 STAR-MC1，共享 8.3 MB SRAM，Wi-Fi、蓝牙、DSI。[S10](sources.md#s10) | 低功耗、音频强，蓝牙在片内，B 案可省掉外加 BLE 芯片；**ISP、H.264 能力未见完整官方证据**，手表模式拍录像需短时唤醒主 SoC。 |
| 主处理器平台自带低功耗岛 | W5+ 配套 M55 协处理器 [S2](sources.md#s2)；AR2 为多芯片含协处理器 [S17](sources.md#s17) | 集成度高；需确认协处理器是否开放给自研程序、能否单独驱动摄像头。 |

【项目判断】**MCU 两案并行，M1 定案**：

- **A 案 = STM32N657 + 外加小 BLE 芯片**：保留已论证的拍照、录像通路；多一颗芯片，框图写“四颗主芯片 + 1 颗小 BLE”。
- **B 案 = BES2800BP 主选**：S10 已有 Wi-Fi、蓝牙、DSI，音频强；ISP / H.264 证据不完整，手表模式拍录像要短时唤醒主 SoC。
- **闸门**：主 SoC 睡眠时，BLE 送来的气泡 ≤0.1 s 上屏【设计目标】。达不到闸门的方案不得定案。

音频同时升级为常驻“耳朵 + 嘴巴”：唤醒词与人声检测常驻 MCU，麦克风阵列能直接接 MCU，主 SoC 睡时也能听；扬声器防漏音、蓝牙耳机切换写清楚；器件型号仍待选型（M1 定案）。

### 6.3 蜂窝候选（按“满足串流最低要求”选型）

机身蜂窝是脚里离开主机后唯一能走远路的那条腿（决定 #25）。

需求方确认：机身蜂窝的最低要求是**满足串流最低要求**。

【项目判断】串流最低网络要求（设计目标，需按实际编码参数实测修正）：

| 场景 | 下行持续 | 上行持续 | 时延 | 说明 |
| --- | --- | --- | --- | --- |
| 云串流（1080p60，H.265 / AV1） | ≥ 30 Mbps | ≥ 2 Mbps（姿态与控制） | RTT p95 ≤ 50 ms | 头动由本地重投影承担，网络时延只影响内容响应 |
| 视频通话 / 会议（1080p30 上行） | ≥ 5 Mbps | ≥ 5 Mbps | RTT p95 ≤ 100 ms | 弱网降分辨率 |
| 串流 + 通话并发 | ≥ 35 Mbps | ≥ 8 Mbps | RTT p95 ≤ 50 ms（取较严的云串流值） | 最重负载 |

据此：**机身蜂窝最低按 5G RedCap 选型**（公开峰值下行约 220 Mbps、上行约 120 Mbps，见下表），峰值有余量，但**持续速率、上行和时延必须在强弱信号下实测**；LTE Cat4 只在实测持续速率满足上表时作为备选。

| 位置 | 候选 | 已核实的公开信息 | 判断 |
| --- | --- | --- | --- |
| 机身（最低档） | Snapdragon X35（RedCap） | 高通称其为最低功耗芯片，目标含可穿戴与 XR 眼镜；下行峰值约 220 Mbps；5G PowerSave Gen 4。[S22](sources.md#s22) | 带宽足够独立上网与中等码率云串流；**首选评估**。 |
| 机身 | Quectel RG255C 系列（RedCap 模组） | R17 RedCap，5G SA，下行约 223 Mbps、上行约 123 Mbps；列出可穿戴应用。[S23](sources.md#s23) | 便于原型；有 eDRX 不生效、休眠电流偏高的用户反馈，需实测。 |
| 机身 | LTE Cat4 级（如 W527 自带） | 见 [S1](sources.md#s1) | RedCap 网络覆盖或模组不成熟时的备选。 |
| 线控模块 | 全功能 5G 模组 | — | 高码率云串流与长时间户外；靠模块大电池承担功耗。 |

---

## 7 重量与人体工学：续航优先，佩戴无感

需求方确认：

- 整机重量与目前主流产品相当，重量分配要均匀、符合人体工学（2026-11-03）。
- **重量与续航冲突时，续航为主；重量分配好，让人尽量无感**（2026-11-03）。

### 7.1 主流产品重量参照

| 产品 | 类型 | 公开重量 | 来源 |
| --- | --- | --- | --- |
| Ray-Ban Meta（Gen 2） | 无显示 AI 眼镜，带电池 | 约 48–52 g（各来源不一） | [S35](sources.md#s35) |
| Meta Ray-Ban Display | 单目显示 AI 眼镜，带电池 960 mWh | 约 69 g | [S36](sources.md#s36)[S34](sources.md#s34) |
| XREAL One / One Pro | 双目显示眼镜，**无电池**，靠线供电 | 约 84 g / 87 g | [S37](sources.md#s37) |

本方案是“双目显示 + 6DoF + 机身蜂窝 + 机身电池”，功能比上面任何一款都多；眼动只预留结构空间，当前版本不装配。

### 7.2 优先级与指标

【项目判断】按“续航为主”调整后的指标：

| 指标 | 定位 | 目标 |
| --- | --- | --- |
| **续航** | **硬指标** | 第 5.3 节 8 小时混合剖面必须达到 |
| 电池容量 | 由续航倒推 | 按技术路线功耗预算约 5.9 Wh、留约 15% 余量，**机身电池按 5–7 Wh 设计**；实测超预算时按续航优先加到 8–10 Wh |
| **佩戴无感** | **硬指标** | 见第 7.3 节，用对标测试验收 |
| 总重量 | 参考指标，不设硬上限 | 尽量接近双目显示眼镜主流水平（约 85 g）；每超出 1 g 都要在重量预算表中说明用途 |

按小型锂聚合物电芯约 200–250 Wh/kg 估算（假设值，以选定电芯规格为准），5–7 Wh 电池约重 20–35 g。【项目估算】XREAL One 约 84 g 且不含电池、主处理器和蜂窝，加上电池与主板、天线后，整机更可能落在**约 115–130 g**（v0.7.2 修正，此前估 95–110 g 偏低；电池加到 8–10 Wh 再加约 10–15 g），高于主流双目显示眼镜；**多出来的重量主要是电池，全部放到耳后**，靠重量分配让佩戴感接近主流产品。

【项目判断】**前框光学减重**：显示改为光波导后，前框光学部分比原方案更轻。**本节重量估算的数字不改**，仍按约 115–130 g 作为预算；实际重量与前框受力最终以 M2 实测为准。省下的前框重量优先用于前后平衡，不改变“续航为主”的排序。

### 7.3 “佩戴无感”的设计与验收

“无感”的关键不是总重，而是**压在鼻梁和前额的重量**和**戴久了的压痕、发热、下滑**。设计原则：**前框尽量轻，新增重量全部放耳后，重心落在耳朵支点附近。**

| 要求 | 做法 | 验收方式（设计目标） |
| --- | --- | --- |
| **鼻梁承重不高于主流** | 前框只放光学、显示和必要摄像头；主板、射频、电池全部后移 | 用同一测量台实测本机与对标产品（如 Ray-Ban Meta、XREAL One）的鼻托受力，**本机鼻托受力 ≤ 对标产品实测值** |
| **前后平衡** | 电池分两块放在两侧镜腿耳后段作为配重；重心靠近耳朵支点 | 重心测量；低头 / 抬头 / 走动时不下滑 |
| **左右对称** | 两侧镜腿重量差 ≤ 3 g；处理器、射频、电池两侧对称分布 | 称重 |
| **压力分散** | 镜腿耳后段加宽并贴合头型，软质包覆；夹持力低且可调；可选后脑软绑带（运动或长时间串流时用） | 夹持力测量；不同头型试戴 |
| **轻质材料** | 前框和镜腿骨架评估镁合金、钛合金、碳纤维等，把省下的重量留给电池 | 重量预算表 |
| **热舒适** | 主处理器、蜂窝放镜腿外侧，远离太阳穴；电池充放电发热导向外侧 | 表面温度测量，按适用标准设上限 |
| **尺寸适配** | 至少两档镜框；瞳距适配；处方镜片插片 | 覆盖目标人群试戴 |
| **主观无感** | — | **连续佩戴 2 小时**多人主观评分：舒适度不低于对标主流产品；无明显鼻梁压痕、耳后疼痛 |

【项目判断】同样重量，前重后轻的眼镜会压鼻梁、往下滑；前后平衡、重心靠耳的眼镜由耳朵和头侧分担，主观感受会轻很多。因此本方案允许总重高于主流，但**鼻梁受力和主观舒适度必须与主流持平或更好**。

---

## 8 关键取舍

| 取舍 | 选择 | 原因 | 代价 |
| --- | --- | --- | --- |
| 依赖手机 vs 依赖网络 | **依赖网络**，机身自带蜂窝 + Wi-Fi | 不带手机也是全功能 | 机身多一套射频，重量、功耗、认证成本上升 |
| 机身蜂窝档位 | 满足串流最低要求，最低按 RedCap | 待机与发热可控，带宽满足最低串流与通话 | 高码率云串流靠线控模块全功能 5G |
| 默认有线 vs 无线 | **默认无线** | 佩戴自由，不依赖线和手机 | 机身电池、散热压力最大 |
| 离线内容上传 | 接口 + 用户选择，默认不上传 | 隐私与灵活性 | 用户需在首次使用时做选择 |
| 通话中的“我本人” | 虚拟形象（语音 + 头部姿态驱动） | 眼镜看不到脸 | 不用眼动，眼神/眨眼靠语音模型或程序化动画补足；渲染依赖 GPU 主机或云 |
| 8 小时续航 | **机身混合使用 8 小时（已确认）**；换电或线控模块实现连续全功能 | 纯无线连续全功能 8 小时没有证据支持 | 全功能时长有限，剖面需审定 |
| 官方云 vs 自建 | 全开放，两者同构 | 不锁定用户 | 需维护公开协议和参考服务端 |
| 重量 vs 续航 | **续航优先**（需求方确认）；电池按 5–7 Wh 设计 | 8 小时剖面是硬指标 | 整机可能约 115–130 g，高于主流，需靠重量分配补偿 |
| 重量分配 | 前框只留光学显示，电池与主板全部后移到耳后 | 佩戴无感：鼻梁受力不高于主流 | 镜腿变粗，结构与散热更复杂 |
| 断网能力 | 只保留手表级功能 | 功能边界清楚，续航最好 | 断网时无串流、无空间交互、无 AI |
| 单处理器 vs 主 + 协处理器 | 主 + 协处理器 | 手表模式与待机不用唤醒主处理器 | 两套固件，摄像头和存储需共享方案 |
| 完整 VR vs AR 交互 | 6DoF 能力 + 光学透视 AR 交互 | 与真实画面交互是核心 | 不以 VR 游戏沉浸感为目标；光学透视亮度、视场受限 |
| 有线原始画面 vs 编码串流 | 两者都支持 | A1 体验最好，A2 兼容面最广 | 多一条 DP 接收路径 |
| 逐应用适配 vs 系统级虚拟显示器 | 系统级为主 | 一次接入覆盖所有普通软件 | 需维护各主机平台驱动；DRM 内容不可用 |

---

## 9 可行性结论与待验证事项

**有证据支持的部分**：PC → 头显开源串流（ALVR、WiVRn）、平面串流（Sunshine / Moonlight）、DP 有线眼镜加眼镜端稳定（XREAL One 系列）、Windows 虚拟显示驱动、面向分布式处理的眼镜芯片（AR2 Gen 1）、面向可穿戴的 RedCap 芯片与模组、带 ISP 与 H.264 的低功耗 MCU，都已公开存在。

**仍是设计目标的部分**：

1. 端到端延迟预算（第 3.5 节），尤其是蜂窝云串流的时延与抖动。
2. 6DoF 追踪、手势、空间锚定在轻量眼镜上的功耗与精度。
3. “全软件兼容”——按类别清单测通过率；DRM / 反作弊 / 安全窗口为已知边界。
4. 睡眠各级功耗、手表模式续航与唤醒时间（第 5.1 节）——机身蜂窝休眠电流要最先测。
5. 主处理器与协处理器共享摄像头、存储的方案，以及模式切换时间。
6. AR2 Gen 1 / AR1+ Gen 1 对非头部品牌的供货、BSP 与开发者文档可获得性。
7. 可采购的 DP 接收 + 重投影芯片方案。
8. 机身同时放蜂窝、Wi-Fi 7 天线时的射频共存、SAR 与认证；6 GHz 国内可用性。
9. 视频通话三种接入方式（V1–V3）在主流通话软件上的实测通过率；虚拟摄像头是否被各软件识别。
10. 默认无线形态下，“串流 + 视频通话 + 6DoF + 蜂窝上行”并发的续航与温升。
11. 机身蜂窝持续速率、上行和时延能否满足第 6.3 节的串流最低要求。
12. 第 5.3 节的功耗假设——按使用状态逐项实测；P1 混合剖面能否在机身 5–7 Wh 电池下达到 8 小时；电池重量与佩戴舒适度。
13. 虚拟形象的驱动效果（语音 + 头部姿态）在通话中是否自然；眼神、眨眼用语音模型或程序化动画补足的效果；Audio2Face 许可条款。
14. 5–7 Wh 机身电池下的整机重量；鼻托受力与对标产品的对比实测；2 小时佩戴主观评分；表面温度。
15. 主 SoC 睡眠时 BLE 气泡能否 ≤0.1 s 上屏（A 案外加 BLE / B 案 BES2800BP 自带蓝牙）；同一状态下唤醒词与人声检测的唤醒率、误唤醒和响应时间。
16. 看板态功耗与新使用剖面：只看板、只气泡、看板 + 气泡三种状态的实际功耗；看板、实时拍照 / 识别、气泡待机的实际时长；5–7 Wh 是否够按决定 #19 重算。
17. 手机这只手的接入：Mika 改造、眼镜通道、BLE 控制面、发消息确认；远程任务不能批准付款和确认的安全边界。
18. 手机代理模式：眼镜离线但手机经 BLE 可达时，是否让手机代为联网；会影响决定 #6（断网行为）。
19. 投屏与多路信号：主 SoC 同时能硬解几路、能并发编码与解码多少；显示处理器能否“DP 画面层 + 叠加层”合成；投屏操作回传延迟；多屏打包后拆层锚定的效果。

**第一版样机范围（需求方确认：完全版）**：显示用**光波导**（几何反射式主选，光机 M1 定案），有线（A1 / A2）、Wi-Fi、机身蜂窝三种连接，6DoF 交互，视频通话 V1–V3，手表模式与同步接口，分级睡眠，**BLE 气泡 / 看板态 / 常驻听音**，全部进入第一版样机，另含虚拟形象；眼动摄像头只做预留、不装配。线控模块和换电电池作为配件同步打样。

【项目判断】完全版样机工作量大，建议在样机前先做下面的“现成硬件验证”，降低返工风险。

**建议的第一步验证（不需要自研硬件）**：

1. 现成 DP 有线眼镜 + PC 虚拟显示驱动 + 开源串流软件：测延迟、画质与兼容清单通过率。
2. 现成 6DoF 一体机或开发套件：验证“虚拟屏锚定在真实桌面 + 手势操作”的交互是否满足需求。
3. RedCap 开发板：实测 eDRX / PSM 休眠电流与云串流时延。
4. STM32N6 一类开发板：验证手表模式的拍照、录像、录音功耗。
5. 现成眼镜 / 一体机摄像头作为电脑虚拟摄像头：在微信、腾讯会议、Teams、Zoom 上测 V1 通话通过率。

这五组数据决定完全版样机的芯片与结构选型。

---

## 10 仍待确认

需求方此前提出的问题大部分已答复，重量与续航的取舍也已确定（续航为主）。下面三项仍需确认或等 M1 结论：

| # | 待确认事项 | 影响 | 处理 |
| --- | --- | --- | --- |
| 1 | **“Muse 那样的交互逻辑”具体指什么** | 影响第 3.9 节的交互细节；需求方尚未说明，不猜测其内容 | 待需求方说明；说明前只作为待确认，不据此设计 |
| 2 | **手机代理模式**：眼镜离线但手机经 BLE 可达时，是否让手机代为联网 | 影响决定 #6（断网行为）和“依赖网络、不依赖手机”的边界 | 需需求方确认；确认前不实现 |
| 3 | **MCU A/B 案**：A = STM32N657 + 小 BLE 芯片，B = BES2800BP 主选 | 影响 BOM、重量、手表模式拍录像和 BLE 气泡时延 | M1 并行评估，闸门是主 SoC 睡眠时气泡 ≤0.1 s 上屏；M1 定案，不需要现在决定 |

下一步是第 9 节的现成硬件验证，详细步骤见 [现成硬件验证计划](validation-plan.md)。各子系统的主选 / 备选、软件栈与 M0–M3 阶段路线见 [技术路线](technical-roadmap.md)。

完整来源见 [sources.md](sources.md)，本方向主要引用 S1、S2、S9、S10、S12、S14、S17–S37 与 S49–S56。
