jodancain/independent-cellular-ai-glasses/docs/equipment-groups-1-3-6.md

# 第 1、3、6 组设备准备清单

**v0.1 · 2026-11-03 · 对应 [现成硬件验证计划](validation-plan.md) 第 1、3、6 组 · 来源核验日期 2026-11-03**

需求方决定第 1、3、6 组先做（三组互不依赖，可并行）。本页把验证计划里的设备类别落到**可公开查到的候选型号**，并标出共用关系，方便询价。

> **边界**：本页不是采购订单，不含价格与交期；型号只是候选，下单前须按“核实项”确认。厂商规格来自公开资料，未经本项目复现。已有设备优先借用，不必重复购买。

## 0 三组共用设备

| 设备 | 用于 | 候选 / 规格 | 核实项 |
| --- | --- | --- | --- |
| Windows PC（带 NVIDIA 独立显卡） | 第 1 组主机；第 3 组控制机 | 支持 H.264 / HEVC / AV1 硬件编码的显卡；USB-C DP Alt Mode 或 DP 输出 | AV1 编码以显卡官方规格为准；USB-C 口是否带 DP 输出 |
| XREAL One（或 One Pro） | 第 1 组主测眼镜；第 6 组对标样品 | 约 84 g（One Pro 约 87 g），USB-C DP 输入，无内置电池 [S37](sources.md#s37)[S20](sources.md#s20) | 一副可两组共用；第 6 组称重前确认不改装 |
| 0.1 g 电子秤 | 第 6 组；第 3 组器件称重可选 | 精度 0.1 g，量程 ≥ 200 g | — |
| 温度记录 | 第 1、3 组 | 热电偶 + 多通道记录仪，或红外测温仪 | 有现成的可借用 |

## 1 第 1 组：串流延迟、画质与软件兼容

| 设备 | 数量 | 候选 / 规格 | 状态 | 核实项 |
| --- | --- | --- | --- | --- |
| DP 显示眼镜 | 1 | XREAL One（与第 6 组共用） | 待询价 / 借用 | 主机 USB-C 口能否直接出画面 |
| 解码端设备（B 模式、A2 近似） | 1 | 支持 USB-C DP 输出和 HEVC / AV1 硬解的小型 PC，或支持 DP 视频输出的安卓手机运行 Moonlight | 待询价 / 借用 | 是否支持 DP 输出、硬解格式 |
| Wi-Fi 7 路由器 | 1 | 三频 Wi-Fi 7，可固定信道与频宽 | 待询价 | 解码端是否支持 Wi-Fi 7，否则按实际标准记录 |
| 2.5GbE 交换机 + 网线 | 1 套 | — | 待询价 / 借用 | — |
| 高速相机 | 1 | 支持 240 fps 慢动作的手机即可做首轮；精测再用专业高速相机 | 借用 | 实际帧率与曝光是否可锁 |
| 光电测量 | 1 套 | 光电二极管或光敏传感器模块 + 示波器 / 逻辑分析仪 | 待询价 / 借用 | 上升时间远小于待测延迟 |
| 测试软件 | — | 虚拟显示驱动 [S27](sources.md#s27)、Sunshine / Moonlight [S26](sources.md#s26)；可选 Breezy Desktop [S28](sources.md#s28)、ALVR [S24](sources.md#s24)、WiVRn [S25](sources.md#s25) | 开源，免费 | 各自许可条款 |
| 计时页与统计脚本 | — | 本仓库 [`tools/latency/`、`tools/analysis/`](../tools/README.md) | 已准备 | — |

## 3 第 3 组：5G RedCap 联网与睡眠功耗

| 设备 | 数量 | 候选 / 规格 | 状态 | 核实项 |
| --- | --- | --- | --- | --- |
| RedCap 评估板 | 1 | Quectel 5G-REDCAP-EVB-KIT【公开资料】：适用 RG255C / RG255AA / RG255G-GL 系列 [S38](sources.md#s38)；分销渠道有现货信息但**不含模组**，需另购模组 [S39](sources.md#s39) | 待询价 | 购买时确认是否附带模组 |
| RedCap 模组 | 1–2 | **RG255C-GL**：RG255C 系列基于 Snapdragon X35 5G Modem-RF 系统【公开资料】[S40](sources.md#s40)（同时覆盖原计划“RG255C”和“X35”两条候选） | 待询价 | 频段是否覆盖国内运营商 5G SA；固件是否支持 eDRX / PSM 及其 AT 命令 [S23](sources.md#s23) |
| 对照模组（可选） | 1 | RG255G-GL（同一评估板可用，联发科平台）[S38](sources.md#s38) | 待询价 | 只在 RG255C 出现 eDRX 不生效等问题时追加 |
| 天线 | 2–4 | 匹配模组频段的 5G 天线 | 待询价 | 评估板是否自带 |
| 5G SA 测试卡 | 1–2 | 运营商 5G SA 数据卡 | 需向运营商申请 | **是否允许 RedCap 终端接入、是否开放 eDRX / PSM**——需要运营商书面确认 |
| 功耗分析仪（主） | 1 | Qoitech Otii Arc Pro【公开资料】：电流纳安到 5 A、分辨率 5 nA、主通道最高 4 ksps [S41](sources.md#s41) | 待询价 | 覆盖休眠到发射峰值；采样率对微秒级脉冲不足 |
| 功耗分析仪（辅） | 1 | Nordic PPK2【公开资料】：200 nA–1 A、100 ksps [S42](sources.md#s42) | 待询价 | **最大 1 A**，模组发射峰值可能超出；只用于休眠窗口的精细波形 |
| 屏蔽箱 + 可编程衰减器（可选） | 1 套 | 覆盖被测频段 | 待询价 / 借用 | 首轮可先在实网用不同位置模拟强弱信号，第二轮再上屏蔽箱 |
| 测试服务器 | 1 | 公网云主机，运行 iperf3 | 待询价 | 带宽不能成为瓶颈 |
| AT / 测速 / 电流分析脚本 | — | 本仓库 [`tools/redcap/`](../tools/README.md) | 已准备 | — |

【项目判断】功耗分析仪选两台的原因：RedCap 模组发射时电流峰值可能超过 1 A（以模组硬件设计手册为准），PPK2 量程不够；Otii Arc Pro 量程够但采样率较低。首轮用 Otii Arc Pro 测平均电流和休眠窗口，PPK2 只在发射关闭的休眠段补充高采样波形。

## 6 第 6 组：佩戴无感基线

| 设备 | 数量 | 候选 / 规格 | 状态 | 核实项 |
| --- | --- | --- | --- | --- |
| 对标眼镜 | 各 1 | Ray-Ban Meta（Gen 2）约 48–52 g [S35](sources.md#s35)；XREAL One 约 84 g（与第 1 组共用）[S37](sources.md#s37)；Meta Ray-Ban Display 约 69 g [S36](sources.md#s36) | 待询价 / 借用 | Meta Ray-Ban Display 的国内可购性未核实，买不到时可只用前两款 |
| 头模 | 1 | 标准成人头模，或按公开头型数据 3D 打印，鼻梁与耳部支点处开传感器槽 | 待制作 | — |
| 测力传感器 | 3–4 | 小量程称重传感器 + 放大模块，放在鼻托与两耳支点下；薄膜压力传感器只作趋势参考 | 待询价 | 量程覆盖 0–200 g 力，先用砝码标定 |
| 配重样架 | 2–3 | 3D 打印镜框，前框与镜腿耳后段留配重槽；配重块 2 g、5 g 若干 | 待制作 | 可调出 85 / 110 / 130 g 三档、前重与后重两种分布 |
| 受试者 | ≥ 5 人 | 不同头型，含戴近视眼镜者 | 内部招募 | 只记编号，不记个人信息 |
| 统计脚本 | — | 本仓库 [`tools/ergonomics/`](../tools/README.md) | 已准备 | — |

## 7 需要需求方决定或办理的事项

1. **询价与采购审批**：本页“待询价”的设备。
2. **5G SA 测试卡**：向运营商申请，并书面确认 RedCap 接入和 eDRX / PSM 开放情况——这是第 3 组能否得出结论的前提。
3. **场地**：第 1 组需要可控光照的房间；第 6 组需要受试者 2 小时佩戴的场地。
4. **受试者**：第 6 组至少 5 人，事先说明流程、可随时停止。
