jodancain/independent-cellular-ai-glasses/hardware/v0.1/exports/main_board/render_bottom.png

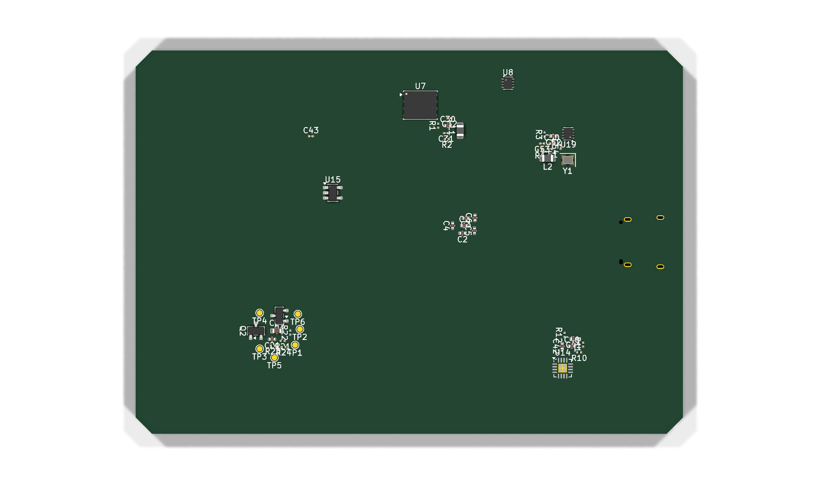
hardware/v0.1/exports/main_board/render_bottom.png
