jodancain/independent-cellular-ai-glasses/hardware/v0.1/exports/main_board/jlcpcb/kicad-bom.csv

Comment | Designator | Footprint | Qty | DNP
22uF | C1 | Capacitor_SMD:C_0402_1005Metric | 1
1uF | C2,C6,C40 | Capacitor_SMD:C_0402_1005Metric | 3
10uF | C3-C5,C21,C30,C41,C52 | Capacitor_SMD:C_0402_1005Metric | 7
100uF | C20 | Capacitor_SMD:C_0603_1608Metric | 1
100nF | C22,C31,C32,C35,C53,C54 | Capacitor_SMD:C_0201_0603Metric | 6
4.7uF | C42 | Capacitor_SMD:C_0402_1005Metric | 1
1uF | C43 | Capacitor_SMD:C_0201_0603Metric | 1
12pF | C50,C51 | Capacitor_SMD:C_0201_0603Metric | 2
USB-C（DP Alt / USB 3 / PD） | J1 | Connector_USB:USB_C_Receptacle_Amphenol_12401610E4-2A | 1
板间 DF40 40P（至 MCU 板） | J2 | Connector_Hirose_DF40:Hirose_DF40C-40DS-0.4V_2x20_P0.4mm | 1
追踪相机 L | J3 | Connector_FFC-FPC:Hirose_FH26-15S-0.3SHW_2Rows-15Pins-1MP_P0.60mm_Horizontal | 1
追踪相机 R | J4 | Connector_FFC-FPC:Hirose_FH26-15S-0.3SHW_2Rows-15Pins-1MP_P0.60mm_Horizontal | 1
主摄（1080p30 起） | J5 | Connector_FFC-FPC:Hirose_FH26-15S-0.3SHW_2Rows-15Pins-1MP_P0.60mm_Horizontal | 1
眼动相机（预留） | J6 | Connector_FFC-FPC:Hirose_FH26-15S-0.3SHW_2Rows-15Pins-1MP_P0.60mm_Horizontal | 1 | DNP
光机 L（光波导） | J7 | Connector_FFC-FPC:Hirose_FH26-25S-0.3SHW_2Rows-25Pins-1MP_P0.60mm_Horizontal | 1
光机 R（光波导） | J8 | Connector_FFC-FPC:Hirose_FH26-25S-0.3SHW_2Rows-25Pins-1MP_P0.60mm_Horizontal | 1
Wi-Fi 天线 | J9 | Connector_Coaxial:U.FL_Hirose_U.FL-R-SMT-1_Vertical | 1
蜂窝主天线 | J10 | Connector_Coaxial:U.FL_Hirose_U.FL-R-SMT-1_Vertical | 1
蜂窝分集天线 | J11 | Connector_Coaxial:U.FL_Hirose_U.FL-R-SMT-1_Vertical | 1
Nano SIM 卡座（M2 期间保留） | J12 | glasses:PH_NANO_SIM_HOLDER | 1
左侧电池 | J13 | Connector_JST:JST_SH_SM03B-SRSS-TB_1x03-1MP_P1.00mm_Horizontal | 1
0.47uH | L1,L2 | Inductor_SMD:L_0805_2012Metric | 2
MMBT3904 | Q1,Q2 | Package_TO_SOT_SMD:SOT-23 | 2
100k | R1,R3 | Resistor_SMD:R_0201_0603Metric | 2
150k | R2 | Resistor_SMD:R_0201_0603Metric | 1
120k | R4 | Resistor_SMD:R_0201_0603Metric | 1
1.13k | R10 | Resistor_SMD:R_0201_0603Metric | 1
3.0k | R11 | Resistor_SMD:R_0201_0603Metric | 1
46.4k | R12 | Resistor_SMD:R_0201_0603Metric | 1
0 | R20 | Resistor_SMD:R_0603_1608Metric | 1
4.7k | R21,R23 | Resistor_SMD:R_0201_0603Metric | 2
47k | R22,R24 | Resistor_SMD:R_0201_0603Metric | 2
CELL_USB_BOOT | TP1 | TestPoint:TestPoint_Pad_D1.0mm | 1
CELL_DBG_TX | TP2 | TestPoint:TestPoint_Pad_D1.0mm | 1
CELL_DBG_RX | TP3 | TestPoint:TestPoint_Pad_D1.0mm | 1
CELL_USB_DP | TP4 | TestPoint:TestPoint_Pad_D1.0mm | 1
CELL_USB_DM | TP5 | TestPoint:TestPoint_Pad_D1.0mm | 1
CELL_USB_VBUS | TP6 | TestPoint:TestPoint_Pad_D1.0mm | 1
Snapdragon AR2 Gen 1（占位） | U1 | glasses:PH_SOC_AR2_GEN1_PLACEHOLDER | 1
SoC 配套 PMIC（占位） | U2 | glasses:PH_PMIC_SOC_PLACEHOLDER | 1
Wi-Fi 7 + 蓝牙连接芯片（占位） | U3 | glasses:PH_WIFI7_COMBO_PLACEHOLDER | 1
Quectel RG255C-GL（X35 RedCap） | U4 | glasses:Quectel_RG255C-GL_LGA-204_32x29mm | 1
eSIM（MFF2，占位） | U5 | glasses:PH_ESIM_MFF2 | 1 | DNP
显示与重投影处理器（原型 FPGA，占位） | U6 | glasses:PH_DPU_FPGA_PLACEHOLDER | 1
FPGA 配置 Flash | U7 | Package_SON:WSON-8-1EP_6x5mm_P1.27mm_EP3.4x4.3mm | 1
TPS62823 DPU 内核 | U8 | Package_SON:Texas_VSON-HR-8_1.5x2mm_P0.5mm | 1
LSM6DSM 6 轴 IMU（≥1 kHz） | U9 | Package_LGA:LGA-14_3x2.5mm_P0.5mm_LayoutBorder3x4y | 1
LT7911UXC DP→MIPI（BGA169 9×9，球位待定） | U10 | glasses:PH_LT7911UXC_BGA169_PLACEHOLDER | 1
Type-C DP/USB3 复用开关（占位） | U11 | glasses:PH_TYPEC_DP_USB_MUX_PLACEHOLDER | 1
USB PD + DP Alt 控制器（占位） | U12 | glasses:PH_PD_CONTROLLER_PLACEHOLDER | 1
ESD | U13 | Package_SON:USON-10_2.5x1.0mm_P0.5mm | 1
BQ24075 左侧 | U14 | Package_DFN_QFN:VQFN-16-1EP_3x3mm_P0.5mm_EP1.6x1.6mm | 1
TLV75533 3.3V 射频 | U15 | Package_TO_SOT_SMD:SOT-23-5 | 1
主摄 MIPI 二选一（占位） | U16 | glasses:PH_MIPI_SWITCH_CAM_PLACEHOLDER | 1
显示开关 L（占位） | U17 | glasses:PH_DISP_SWITCH_L_PLACEHOLDER | 1
显示开关 R（占位） | U18 | glasses:PH_DISP_SWITCH_R_PLACEHOLDER | 1
TPS62823 LT7911UXC 1.1V | U19 | Package_SON:Texas_VSON-HR-8_1.5x2mm_P0.5mm | 1
25MHz ±50ppm | Y1 | Crystal:Crystal_SMD_2016-4Pin_2.0x1.6mm | 1
