jodancain/independent-cellular-ai-glasses/docs/supplier-response.md

# 供应商技术方案回复模板

**对应需求 v0.1 · 公开回复请勿填写保密信息**

可将本模板复制为自己的技术回复，或在 PR 中提出需求修订。公开回复只包含有权公开的技术信息；具体价格、商业条款、个人联系方式、保密 BOM、内部日志和未公开资料另行交流。

## 1 提案概况

- 方案标题：待填写
- 对应需求版本：v0.1
- 方案状态：概念／开发板验证／工程样机／量产方案，待选择并说明
- 适用系统：Linux／Android／其他，待填写
- 方案范围及不包含事项：待填写
- 可公开的参考整机或案例：待填写；无公开材料可写“可在非公开沟通中提供”

## 2 逐项回复

状态统一填写：**满足／部分满足／不满足／待验证**。保留偏差，不要仅填写“支持”。

| 项目 | 本方要求 | 供应商填写 | 证据与风险 |
| --- | --- | --- | --- |
| 主平台 | W527、W5 加蜂窝与成熟替代方案同口径比较 | 状态、型号、系统、RAM/存储、BSP版本 | 可采购性、样机、量产经验及限制 |
| 独立蜂窝 | 脱离手机和热点，机内 SIM 或 eSIM | 制式频段、AP/modem组合、卡方案和运营商 | eSIM是否仅预留；开通、认证和中国可用性 |
| HUD 档 | 文字、箭头及必要图示 | 光学、显示和开放接口 | 可读性、功耗、视力适配及未验证项 |
| 空间 AR 档 | 与 HUD 分开提案 | 光学、定位跟踪、传感器、算法 | 跟踪漂移、功耗和额外依赖 |
| 摄像与音频 | 质检留档及远程专家 | 摄像、麦克风、扬声器、编解码和回声消除 | 实际格式、并发、生命周期和接口限制 |
| 自主应用与云 | 不依赖第三方消费级账号或云完成核心功能 | 账号、预装、权限和服务方案 | 残余第三方依赖及停服影响 |
| 源码与许可 | 可维护 BSP、驱动、HAL、API 和构建材料 | 可交付清单、闭源清单与许可边界 | 修复责任、再分发和断供替代 |
| 签名与更新 | 合法权限及可操作更新路径 | 平台签名流程、自有应用签名和权限配置 | 生产密钥保管、退出及交接机制 |
| OTA 与恢复 | 项目方控制升级、签名、回退和救砖 | 流程与工具 | 断网断电、安全降级边界、生产验证 |
| 功耗与佩戴 | 同负载整机比较后冻结指标 | 功耗、热、续航、重量和电池选项 | 测试条件、降频、头部佩戴和弱网影响 |
| 隐私 | 摄录提示、访问保护和数据清理 | 数据流与权限方案 | 传输存储、保留删除和设备交接 |
| 生命周期 | 补丁、维护、售后和停产替代 | 期限、响应、备件和交接范围 | 关键件供应连续性与限制 |

## 2A 串流终端方向（自研）补充回复项

如果提案针对[串流终端方向](streaming-direction.md) v0.7.6，请再逐项回复下表。问题来自[技术路线](technical-roadmap.md)第 5 节，验收口径见[设计开发要求](design-requirements.md)。按方案第 1.1 节，表中注明了每项属于脑、小脑、手、脚中的哪个角色。

| 项目 | 本方要求 | 供应商填写 | 证据与风险 |
| --- | --- | --- | --- |
| 主 SoC 独立运行（小脑） | 没有手机或 PC 时能独立运行 AOSP、6DoF 和云串流客户端（HW-SOC-03） | 型号、BSP 版本、独立运行实测 | 是否必须与主机分担计算 |
| 主 SoC 并发能力（小脑） | 主显示 1 路全帧率硬解 + 通话上行编码 + 两路追踪相机 + 主摄 ISP 同时运行；同时硬解路数与降频曲线（HW-SOC-07） | 并发规格、30 分钟温度与降频数据 | 长时间并发是否降频、掉帧 |
| 显示处理器（小脑） | DP 画面层 + 1 个叠加层合成后扭曲上屏；叠加层可走低速 SPI（HW-DP-07） | 方案、接口、延迟 | A1 时主 SoC 睡眠下能否出气泡 |
| MCU 与常驻 BLE（小脑常驻 · 脚） | 主 SoC 睡眠时 BLE 气泡 ≤0.1 s 上屏【设计目标】（HW-MCU-06）；麦克风直连常驻听音 | A / B 案参考设计、实测时延 | 拍录像是否需唤醒主 SoC |
| 机身蜂窝（脚） | RedCap，满足串流最低网络要求（NET-01–03）；eDRX / PSM 实测休眠电流（HW-CELL-05） | 模组、频段、持续速率、休眠电流波形 | eDRX 是否真的生效 |
| Wi-Fi 7（脚） | 6 GHz 可用性；WMM 优先级队列，按流设优先级（PROT-16） | 芯片、频段、QoS 能力 | 国内 6 GHz 是否可用 |
| 有线 USB-C（脚） | A1 4 路 DP 接收；A2 USB 3；有线时作 UVC / UAC / HID 设备（HW-IO-01–03、SW-23） | 桥接芯片、带宽、驱动 | DSC、HDCP 边界 |
| 光波导与光机（器官 · 视网膜） | 双目，视场 30–50°，入眼亮度约 4000 尼特（HW-OPT-01、HW-OPT-03） | 型号、视场、亮度、功耗、重量 | 亮度均匀性与量产状态 |
| 音频（器官 · 耳朵 / 嘴巴） | 混音优先级与回声消除参考回采；PDM 同时给 MCU 与主 SoC（HW-AUD-01–04） | 器件与参考设计 | 开放式扬声器漏音 |
| 主机侧（手） | 虚拟显示、多屏打包成一路、按回传事件注入输入（HOST-02、HOST-13） | 平台与驱动方案 | 各操作系统版本差异 |

## 3 同口径测试说明

请描述可公开测试方法，不上传真实设备标识、凭据、原始客户数据或内部日志。

- 被测对象：芯片规格／开发板／目标结构样机／量产整机，待填写。
- 软硬件版本和依赖：待填写公开版本信息。
- 网络条件：制式、信号条件、移动或遮挡条件，待填写。
- 并发负载：摄像编码、音频、显示、业务计算和蜂窝传输，待填写。
- 画质参数：分辨率、实际帧率、码率和编码器配置，待填写。
- 测量条件：环境温度、持续时长、电池状态、功耗测点、温度测点，待填写。
- 输出：功耗、温升、续航、降频、丢帧、时延、音画同步、异常恢复和资源趋势，待填写。
- 当前不能满足或尚未验证的目标：待填写。

## 4 开发与交付计划

| 阶段 | 计划交付 | 建议周期与依赖 | 放行条件 |
| --- | --- | --- | --- |
| EVT | 待填写 | 待填写 | 待填写 |
| DVT | 待填写 | 待填写 | 待填写 |
| PVT | 待填写 | 待填写 | 待填写 |

请另行提供 BOM、NRE、MOQ、样机、模具、认证、授权、软件维护和售后费用。公开回复仅确认费用类别和沟通方式，不要求公开价格或保密商业条件。

## 5 提交前确认

- [ ] 已区分芯片公开规格、开发板实例与整机实测。
- [ ] 所有关键参数有来源或测试条件；未确认事项已标注。
- [ ] 没有将预留能力写成已实现，没有替项目方冻结未定参数。
- [ ] 没有附固件、SDK、解包件、私钥、令牌、设备标识或客户数据。
- [ ] 已确认对公开内容有权披露，并列明第三方资料的许可限制。
- [ ] 理解回复不构成中标、订单或仓库直接写入权限。
