jodancain/independent-cellular-ai-glasses/docs/validation-plan.md

# 现成硬件验证计划

**v0.1.5 · 2026-11-05 · 对应 [串流终端方向](streaming-direction.md) v0.7.6 · 阶段与路线见 [技术路线](technical-roadmap.md)（本计划即 M0）**

本计划用**现成设备**（开发板、商用眼镜、PC、开源软件）先验证方案里最关键的假设，再决定自研芯片与结构选型。它不需要自研硬件，也不替代整机验收。

> **证据边界**：本页的“通过标准”全部来自方案中的【设计目标】，不是已验证结论；方案里没有给出数值的，写“待定，首轮测基线后确定”。开发板、商用眼镜的测试结果只能说明趋势，**不能直接当作目标整机数据**。设备型号写“候选，待核实”的，以实际可采购型号为准；本页不含价格和采购承诺。

## 0 总览

| 组 | 验证什么 | 验证哪个角色 | 对应方案 | 结果决定什么 |
| --- | --- | --- | --- | --- |
| 第 1 组 | 串流延迟、画质与软件兼容（有线 / Wi-Fi） | 脚（有线 / Wi-Fi）+ 手（主机串流）+ 小脑（解码上屏） | 第 3.3、3.5、4.2 节 | 有线 A1 / A2 与 Wi-Fi 路线是否达标；兼容分层 L0 是否可作主路 |
| 第 2 组 | 6DoF 虚拟屏锚定与手势交互 | 小脑（6DoF、手势） | 第 3.1、3.2 节 | 6DoF 交互需要的追踪精度与算力，主处理器选型要求 |
| 第 3 组 | 5G RedCap 联网与睡眠功耗 | 脚（机身蜂窝） | 第 5、6.3 节 | 机身蜂窝能否满足串流最低要求；待机功耗是否可接受 |
| 第 4 组 | 手表模式功耗、BLE 气泡、唤醒词与看板态（低功耗协处理器） | 小脑常驻 + 脚的 BLE + 耳朵 / 嘴巴 | 第 2、3.9、5.1、5.4、5.5、6.2 节 | 协处理器 A/B 选型；看板态与新使用剖面的电量；主 SoC 睡眠时的 BLE 气泡和唤醒词 |
| 第 5 组 | 视频通话接入（虚拟摄像头）与虚拟形象 | 手（主机 / 云）+ 眼睛 / 嘴巴 / 耳朵 | 第 3.7、3.8 节 | V1 主机通话能否覆盖主流通话软件；虚拟形象链路是否可用 |
| 第 6 组 | 佩戴无感基线（人体工学） | 身体（重量分配） | 第 7.2、7.3 节 | 重量分配方案与可接受的整机重量 |

投屏与多路信号：第 1 组 1.4 节第 12 步先测多屏打包与操作回传的基线；主 SoC 并发能力（HW-SOC-07）、显示处理器“DP + 叠加层”（HW-DP-07）和多路信号调度（SW-22）要用 M1 的参考平台与 FPGA 才能测。

脑（意图与派手）没有现成硬件可测，放到 M1 的“打开 QQ”全流程演示里验证（设计开发要求 SW-21）。

**当前状态（2026-11-03）**：需求方决定第 1、3、6 组先做；设备见 [设备准备清单](equipment-groups-1-3-6.md)，配套脚本见 [tools/](../tools/README.md)。

**执行顺序建议**：第 1、3、6 组互不依赖，可以同时开始；第 2 组可与第 1 组共用 PC；第 4 组可与第 3 组共用功耗分析仪；第 5 组的屏幕共享步骤依赖第 1 组搭好的虚拟显示器环境。

## 0.1 公共要求

- **共用仪器**：直流功耗分析仪（第 3、4 组）、高速相机或光电传感器 + 毫秒计时页（第 1、2、5 组）、带 NVIDIA 显卡的 Windows PC（第 1、2、5 组）。
- **统一记录**：每轮测试记录设备型号、固件 / 软件版本、环境温度、网络条件；版本或设置改变就另起一轮。延迟类指标至少 30 个样本，报告 p50 / p95。
- **数据与隐私**：原始数据（视频、录音、日志）不放进本公开仓库；仓库只放脱敏后的汇总表。不记录真实设备序列号、SIM 卡号、账号和受试者个人信息。
- **证据标注**：结果写回方案时，标注【实测】及测试条件；未测的仍保留【设计目标】。

## 0.2 决策闸门（全部完成后）

| 闸门 | 通过条件 | 不通过时 |
| --- | --- | --- |
| G1 串流体验 | 第 1 组有线与 Wi-Fi 延迟、画质达到方案第 3.5 节目标；L0 兼容清单通过率可接受 | 调整串流协议或编码参数；必要时提高主处理器解码与显示要求 |
| G2 空间交互 | 第 2 组锚定漂移与手势成功率可接受 | 6DoF 能力下调为“虚拟屏 + 简化交互”，或提高追踪硬件要求 |
| G3 独立联网 | 第 3 组 RedCap 持续速率与 RTT 满足方案第 6.3 节；**模组本身**的休眠电流可接受（整机待机归 G4 / 整机测试） | 换模组 / 芯片，或把高带宽场景交给线控模块 |
| G4 续航（暂定） | 第 3、4 组实测功耗代入方案第 5.3 节 8 小时剖面后不超出技术路线第 1.9 节的功耗预算。第 3、4 组只覆盖蜂窝与协处理器，G4 只是早期预警；最终以完全版样机（M2）整机 8 小时实测为准 | 先做功耗优化，再按需求方“续航优先”的原则加大电池 |
| G5 通话 | 第 5 组主流通话软件 V1 通过；虚拟形象链路跑通 | 对不通过的软件改走 V2 / V3 |
| G6 佩戴 | 第 6 组“后重”样架鼻托受力不高于对标产品，主观评分不低于对标 | 调整重量分布或材料，再测 |

六个闸门的结果汇总后，进入自研芯片与结构选型。第 4 组新增的 BLE 气泡、唤醒词和看板态**不单设闸门**，结果进入 M1 的 MCU A/B 定案和看板态功耗预算。

---

## 0.3 读数约定（适用于全部各组）

- 所有“通过 / 失败”只对本次测试条件负责；未执行的单元格写“待填”，不得用估计值代替。
- 延迟 p95 统一用 nearest-rank（排序后第 ⌈0.95n⌉ 个样本）；原始记录保留全部样本，包括无效样本及无效原因。
- 文中的距离、时长、样本数、温度、衰减等是测试条件或方法，不是通过阈值；通过阈值只写在各组“通过标准”小节，并逐条标注方案依据或“待定”。
- 设备一律用实验室别名（如 G1-PC1）；不记录真实序列号、卡号、IMSI / IMEI、账号与受试者个人信息。

---

## 第 1 组：串流延迟、画质与软件兼容

### 1.1 目的与对应方案章节

本组对应方案第 9 节“建议的第一步验证”第 1 项：用现成 USB-C DP Alt Mode 显示眼镜 + PC 虚拟显示驱动 + 开源串流软件，测延迟、画质与兼容清单通过率。目的不是证明自研整机已经达标，而是取得三类链路的可复现基线，判断哪些指标已有现成方案可以接近、哪些必须留到自研阶段解决。

三个子问题：

- **A1 有线原始画面**：眼镜作为 PC 的 DP 显示器，不经过视频编码；测显示链路延迟、刷新/跳帧、可读字号与 30 分钟稳定性。
- **A2 有线编码**：方案目标是主机编码后经 USB 3.x 数据通道送到眼镜；现成 DP 眼镜没有公开的“编码流直接进显示管线”入口，因此按任务要求用 USB 网络 + Moonlight 近似，并明确标注近似边界。
- **B Wi-Fi 串流**：主机经 Wi-Fi 把编码流送到解码端，再由解码端以 DP 驱动眼镜；测网络与编解码叠加后的延迟、抖动、画质和稳定性。

对应章节：

| 方案章节 | 本组怎么用 |
| --- | --- |
| 第 3.3 节 连接方式 | 定义 A1 / A2 / B 的链路、体验定位与主要前提；A2 的现成方案缺口在本组单独说明 |
| 第 3.5 节 延迟预算 | 引用逐环节设计目标；按 p50 / p95、每组 ≥30 样本、30 分钟连续运行的方法测量 |
| 第 4.1 节 串流纪律 | 记录“最新帧优先、丢帧不排队、不以已发送代替已显示”等行为是否可观察 |
| 第 4.2 节 兼容分层 | 以 L0 系统级虚拟显示器为主路，按软件类别清单测通过率；DRM / 反作弊 / 安全窗口按已知边界记录 |
| 第 3.6 节 眼镜端能力 | 引用双目光波导、视场 30–50°、入眼亮度目标约 4000 尼特、刷新率 60 Hz 起并可补帧到 90 Hz 以上等显示目标，作为选型参照，不作为现成设备的硬性判据 |
| 第 9 节 第一步验证 | 本组即第 1 项；结论服务于完全版样机的芯片与结构选型 |

【项目判断】本组用现成设备时，能测到的是“现成链路的上限/基线”，不是自研眼镜的整机指标。尤其是 A1 的现成眼镜可能没有方案所需的本地重投影，A2 也没有完全等价的现成入口；报告必须把“实测”“近似”“不适用”分开写。

【公开资料】[S20](sources.md#s20) 报道该系列以 USB-C DP 输入并在眼镜端做稳定/畸变校正，宣称约 3 ms；[S37](sources.md#s37) 为公开评测。两者均未经本项目复现，不能当作本组实测结果，也不能替代第 3.5 节的逐环节测量。

【项目判断】本组用 XREAL One（或同类现成 DP 眼镜）仅作为串流延迟与兼容性的测试工具，**不代表本项目的显示方案**；本项目显示方案已定为光波导（技术路线第 1.3 节），本组结论不外推到光学性能。

### 1.2 设备清单

| 类别 | 建议型号或规格 | 数量 | 备注 |
| --- | --- | --- | --- |
| 显示眼镜（主） | USB-C DP Alt Mode 显示眼镜；[S20](sources.md#s20)、[S37](sources.md#s37) 中的公开型号（具体型号与固件待核实） | 1 副 | 需确认 DP Alt Mode、原生分辨率/刷新率、供电方式；[S37](sources.md#s37) 的公开评测提到对应型号无内置电池；待询价 |
| 显示眼镜（备用/对照） | 另一款公开 USB-C DP Alt Mode 显示眼镜 | 1 副（可选） | 候选，待核实；用于排除单机个体差异；待询价 |
| 主机 PC | Windows 11，独立 GPU，DP 1.4 输出或全功能 USB-C DP Alt Mode，支持 H.264 / HEVC / AV1 硬件编码 | 1 台 | 现有设备或待询价；记录 GPU、驱动与编码器版本 |
| Windows 虚拟显示驱动 | Virtual-Display-Driver（基于 IddCx 的间接显示驱动）[S27](sources.md#s27) | 1 套 | 开源；需测试驱动签名、系统版本与多显示器行为；许可待核实 |
| Linux 虚拟屏（可选） | Breezy Desktop + XRLinuxDriver [S28](sources.md#s28) | 1 套 | 可选对照；需确认发行版、内核与桌面环境；开源 |
| 串流服务端 | Sunshine [S26](sources.md#s26) | 1 套 | 开源；记录版本、编码器、码率、关键帧间隔与切片设置 |
| 平面串流客户端 | Moonlight [S26](sources.md#s26) | 1 套 | 开源；运行在解码端主机 |
| XR 串流参照（可选） | ALVR [S24](sources.md#s24) / WiVRn [S25](sources.md#s25) | 各 1 套 | 仅作 XR 参照，不作为本组主路径；开源；许可与平台兼容待核实 |
| 解码端主机 | 带 USB-C DP 输出、硬件解码的小型 PC 或笔记本 | 1 台 | 用于 B 与 A2 近似；候选，待核实具体型号；待询价 |
| Wi-Fi 路由器 | Wi-Fi 7 三频路由器（公开产品类别） | 1 台 | 候选，待核实；需能固定信道、频宽并关闭 band steering；待询价 |
| 有线网络 | 2.5GbE 交换机、网线 | 1 套 | 避免无线回程成为瓶颈；待询价 |
| 高速相机 | ≥240 fps，可手动曝光、手动对焦 | 1 台 | 用于内容延迟与帧率复核；候选，待核实；待询价 |
| 光电测量 | 光电二极管/光电传感器 + 示波器或逻辑分析仪 | 1 套 | 用于“输入事件→显示边沿”测量；需校准；待询价 |
| 温度记录 | 热电偶/红外测温仪 + 多通道记录仪 | 1 套 | 测前框、左右镜腿、显示面；待询价 |
| 环境记录 | 照度计、温湿度计 | 1 套 | 记录环境条件；待询价 |
| 可读性图卡 | 中英文/数字字号图卡（自制，打印精度需校准） | 1 套 | 用于最小可读字号；不预设字号阈值；待询价 |
| 受试者 | 矫正视力正常、无严重眼疾；≥3 人 | 3–5 人 | 匿名编号、知情同意、可随时停止；不记录个人信息 |
| 测试脚本与存储 | Python 采集脚本 + 受控存储目录 | 1 套 | 原始数据不放入公开仓库；公开仓库只放模板与汇总 |

### 1.3 测试环境与前置条件

**场地与光学条件**

- 使用暗室或可变光实验室；环境温度控制在 23–27°C，记录实际值；避免阳光直射、频闪光源和强反光。
- 延迟测试把眼镜固定在头模或刚性支架上，减少头动和佩戴位置变化；可读性测试由受试者实际佩戴。
- 固定亮度、对比度、色温，关闭自动亮度和自动色温；记录眼镜的瞳距（IPD）、鼻托位置和眼距。
- 每组测试前清洁镜片和显示面；避免指纹、灰尘影响画质与字号判读。

**链路与网络**

- **A1：** 主机用 USB-C DP Alt Mode 直连眼镜，或 DP 输出经认证的 USB-C 适配器连接；使用认证 USB-C 线，长度 ≤1 m，减少线缆差异。若眼镜无内置电池，按厂商要求供电。
- **A2：** 【项目判断】现成 DP 眼镜没有公开的“主机 USB 3.x 编码流直接进显示管线”入口。本组采用近似路径：主机 PC ↔ USB 3.x 网络（RNDIS/CDC-ECM）↔ 解码端主机 ↔ USB-C DP ↔ 眼镜；Moonlight 走 USB 网络。该路径比方案 A2 多了一次“解码端→眼镜”的 DP 输出，**结论只作为 A2 的近似上界，不外推为 A2 已验证**。
- **B：** 主机用有线接入 Wi-Fi 路由器；解码端与眼镜在同一房间，视距 3 m 左右，记录实际距离；路由器固定信道和频宽，测试期间关闭其他大流量设备。记录实际协商的 Wi-Fi 标准（Wi-Fi 6 / 6E / 7），不默认写成 Wi-Fi 7。
- 记录每次测试的链路：接口、线缆、分辨率、刷新率、编码格式、码率、色度抽样、关键帧间隔、是否切片编码、是否帧内刷新。

**软件与配置**

- 固定操作系统版本、GPU 驱动、虚拟显示驱动版本、Sunshine / Moonlight 版本与配置；每次改配置都重新编号，不把不同配置的数据混在一张汇总表里。
- Windows 主机设为高性能电源模式，关闭睡眠、硬盘休眠和自动更新；解码端同样关闭节能。
- 虚拟显示器的分辨率/刷新率优先匹配眼镜原生规格；若只能低于原生，记录差异。
- A1 不需要虚拟显示驱动；A2/B 用 Virtual-Display-Driver 作为 L0 主路，Linux Breezy Desktop 仅作可选对照，不纳入主通过率。
- 记录是否启用 HDR、是否使用 10-bit、是否开启可变刷新率；首轮建议统一 SDR、固定刷新率，减少变量。

**测量链校准**

- 用已知延迟的 LED 回路或高速相机帧计数校准“输入事件→显示变化”的测量链；记录相机帧率、曝光时间、光电传感器上升时间和示波器采样率。
- 光电法测的是显示面亮度边沿；高速相机法测的是“画面出现对应帧”。两种方法分别记录，不混算。
- 每次测试前后各做一次校准；校准漂移超过预期时，整组重测。

**受试者与安全**

- 受试者使用匿名编号；测试前说明目的、流程、可随时停止；不记录姓名、联系方式、人脸视频等个人信息。
- 避免长时间高亮画面；受试者出现眼干、头痛、眩晕时立即停止。
- 高速相机、三脚架和线缆布置在通道之外，避免绊倒；激光类设备不使用。

### 1.4 测试步骤

1. **登记与编号。** 给每台设备分配实验室别名（如 G1-PC1、G1-GLASS1），记录型号、固件、驱动、软件版本、线缆规格；不记录真实序列号。
2. **校准测量链。** 完成相机/光电/示波器校准，记录校准方法和不确定度；用一次已知延迟的回路验证测量链。
3. **建立 A1 链路。** 主机直连眼镜，设置原生分辨率/刷新率、固定亮度、SDR；确认系统识别为扩展显示器，画面无缩放；记录 DP 链路是否启用显示流压缩（DSC；若启用，注明它是链路压缩，不是 H.264/HEVC 视频编码）。截取系统显示设置和眼镜实际画面作为记录。
4. **A1 内容延迟。** 用“主机画面切换/输入事件→眼镜显示变化”的光电法或高速相机法，每条件至少 30 个有效样本；记录 p50、p95、最大值和全部原始样本。输入事件包括窗口切换、光标移动、视频帧切换，分别记录。
5. **A1 运动到光子（如适用）。** 若眼镜具备端侧稳定/重投影，把眼镜固定在可编程转台或头模上，给一个角运动阶跃，测“运动触发/IMU 触发→显示画面变化”。若眼镜没有重投影，记“不适用”，不得用内容延迟冒充运动到光子；完整 6DoF 追踪与锚定见第 2 组。
6. **A1 帧率、跳帧与画质。** 连续运行 10 分钟，记录平均/最低帧率、应显示帧数、丢弃或迟到帧数；用测试图案检查原生分辨率、色带、块效应、文字边缘和运动模糊。A1 的定位是“无压缩画质”，但仍需记录眼镜端缩放/校正带来的变化。
7. **A1 可读字号。** 在固定等效距离（首轮 2 m，记录实际）显示中英文和数字字号图卡；分别在 100%、125%、150% 缩放下，由至少 3 名受试者判读；5 次中 4 次正确记为“可读”，记录最小字号和对应角分。
8. **A1 30 分钟稳定性。** 用代表性负载（办公窗口 + 视频播放 + 滚动/拖拽）连续运行 30 分钟；在 0–5 分钟和 25–30 分钟分别测 p95 延迟（每个窗口至少 30 个有效延迟样本）、帧率和温度；每 1 分钟记录前框、左右镜腿、显示面温度和环境温度；记录是否出现降频、花屏、断连。
9. **A2 近似链路。** 按本组 1.3 节的 USB 网络路径搭建；主机用 Virtual-Display-Driver 创建与眼镜原生分辨率匹配的虚拟显示器，Sunshine 捕获该显示器；确认 Moonlight 走 USB 网络而不是 Wi-Fi；重复第 4–8 步的延迟、帧率、字号和 30 分钟稳定性测试。报告中写明“A2 近似，不是方案 A2 的等价实现”。
10. **B Wi-Fi 链路。** 主机有线接路由器，主机用同一虚拟显示器配置并由 Sunshine 捕获；解码端 Wi-Fi 接入；记录频段、信道、频宽、RSSI、协商速率；重复第 4–8 步。若路由器/解码端不支持 Wi-Fi 7，按实际标准记录，并把“Wi-Fi 7”结论留空。
11. **兼容清单。** 在 A1 和 B 上逐项运行本组 1.5 节清单；每项至少完成一次完整操作，失败项复测一次；按“通过 / 部分通过 / 失败 / 预期失败”记录，预期失败项注明方案 4.2 的边界。DRM、反作弊、安全窗口不尝试绕过。
12. **多屏与操作回传（预研，可选）。** 主机用虚拟显示驱动开 2–3 块虚拟屏，一种做法是各自串流（记录解码端同时解几路时的掉帧和温度），另一种是在主机侧拼成一路再串流（记录拆块后的可读性）；对比两种做法，作为方案第 3.11 节“多屏打包成一路”的早期证据。再用解码端的鼠标 / 触控在投屏画面上点击，测“输入→主机画面变化→回到眼镜”的往返延迟，每条件至少 30 个样本，作为操作回传（设计开发要求 SW-23、PROT-15）的基线。
13. **汇总与复测。** 检查样本量、校准记录和异常样本；对 p95 异常、温度异常或兼容结果不一致的条件，按同一配置复测一次并保留两次数据。

### 1.5 测量指标与方法

**1.5.1 内容延迟与运动到光子**

- **内容延迟**：从主机输入事件（窗口切换、光标移动、视频帧切换）或画面切换命令，到眼镜显示面出现对应变化的时间。A1 用光电法或高速相机法；A2/B 在眼镜显示面测量，包含采集、编码、传输、解码、显示。
- **运动到光子**：从台架角运动触发或 IMU 触发，到显示画面出现对应变化的时间。只对具备端侧稳定/重投影的现成眼镜测量；没有重投影的型号记“不适用”，并说明原因。
- 每个条件至少 30 个有效样本；记录 p50、p95、最大值、最小值；p95 用 nearest-rank。无效样本（遮挡、自动亮度变化、丢帧、对焦失败）单独保留并注明原因，不直接删除。
- 同时记录测量链不确定度；若相机帧间隔大于目标延迟，必须用光电法或更高帧率设备补充，不能只靠低帧率相机下结论。

**1.5.2 帧率与跳帧**

- 帧率用主机端呈现统计工具、客户端统计叠加层和高速相机抽检三种方式交叉核对；记录平均 fps、最低 fps、测试时长。
- 跳帧率定义为“丢弃或迟到超过 1 个刷新周期的帧数 ÷ 应显示帧数”；同时记录“迟到但未丢弃”的帧，避免把网络抖动误判为跳帧。
- 记录是否出现“排队而不是丢帧”：若延迟随时间单调上升、恢复后出现追赶，按方案 4.1 的串流纪律单独记录。

**1.5.3 画质**

- 记录原生分辨率、实际输出分辨率、刷新率、色度抽样、色深、是否 HDR；用测试图案检查色带、块效应、振铃、文字边缘和运动模糊。
- A1 的定位是“无压缩画质”，检查重点是眼镜端缩放/畸变校正、面板均匀性和文字清晰度；A2/B 额外记录编码伪影和码率变化。
- 画质目前没有方案数值阈值，首轮以“可复现的描述 + 对比截图/照片”记录，阈值待定，首轮测基线后确定。

**1.5.4 最小可读字号**

- 固定等效距离、字体、字重、对比度和背景；中英文、数字分别测试；记录 100%/125%/150% 缩放下的最小可读字号。
- 每名受试者每个条件读 5 次，4 次正确记为可读；记录错误类型（看错、看不清、串行）。
- 同时记录受试者的矫正视力状态（只写“已矫正/未矫正”，不写具体病历）。

**1.5.5 30 分钟稳定性**

- 统一负载和亮度，连续 30 分钟；在 0–5 分钟和 25–30 分钟两个窗口分别计算 p95 延迟、平均帧率、跳帧率。
- 温度每 1 分钟记录一次：前框、左镜腿、右镜腿、显示面、环境；记录是否出现降频、亮度下降、断连、花屏。
- 30 分钟 p95 相对 0–5 分钟基线的劣化幅度、温度上限均无方案数值，按“待定，首轮测基线后确定”处理。

**1.5.6 兼容清单与通过率**

按方案 4.2 的 L0 主路，覆盖以下类别；具体应用只写类别和场景，不写登录信息：

| 类别 | 场景 |
| --- | --- |
| 办公 | 文字处理、表格、演示、PDF、浏览器、邮件/日历、多窗口 |
| 开发 | 编辑器/IDE、终端、浏览器开发者工具、编译/测试、多显示器 |
| 影音 | 本地视频播放器、浏览器视频、字幕、DRM 流媒体（预期失败） |
| 游戏 | 窗口/无边框游戏、游戏启动器、反作弊游戏（预期失败） |
| 手机应用 | Android 投屏/桌面模式/模拟器；另一手机生态仅记录是否可用 |
| 安全窗口 | 登录/提权/口令输入框、银行类安全界面、DRM/HDCP 安全路径（预期失败） |

- 结果定义：**通过** = 主要功能可用且内容可读；**部分通过** = 可用但有明确限制（如必须缩放、部分弹窗不可见）；**失败** = 主要功能不可用；**预期失败** = 方案 4.2 已列明的边界（DRM、反作弊、安全窗口等）。
- 通过率分别计算“严格通过率 = 通过 ÷（总项 − 预期失败）”和“含部分通过率 =（通过 + 部分通过）÷（总项 − 预期失败）”；两个数都记录，不用一个数掩盖差异。
- 失败项复测一次；仍失败则记录系统版本、应用版本、窗口模式和复现步骤，不尝试绕过 DRM、反作弊或安全机制。

**1.5.7 记录与隐私**

- 原始 CSV、视频、照片保存在受控目录，不放入公开仓库；公开仓库只放模板和汇总。
- 不记录真实序列号、登录信息、个人信息；设备用实验室别名，受试者用匿名编号。

### 1.6 通过标准

以下通过标准逐条引用方案 v0.7；属于【设计目标】的均标注为“设计目标，非已验证结论”；方案没有数值的，统一写“待定，首轮测基线后确定”，本组不补造数字。

| 指标 | 方案依据 | 通过标准 | 说明 |
| --- | --- | --- | --- |
| A1 编码 | 3.5 | 方案定义 A1 不经过视频编码；设计目标，非已验证结论 | A1 不经过视频编码；若 DP 链路使用 DSC，单独记录为链路压缩，不与 H.264/HEVC 编码混为一谈 |
| A1 传输 | 3.5 | 方案写“线路级”，未给数值；待定，首轮测基线后确定 | 记录线缆、接口、分辨率、刷新率与信号完整性 |
| A1 重投影 + 显示 | 3.5 | ≤ 5 ms；设计目标，非已验证结论 | 现成眼镜若无重投影，只测显示响应并标注“不适用/部分适用” |
| A1 运动到光子 | 3.5 | 仅“重投影 + 显示 ≤ 5 ms”可引用（设计目标，非已验证结论）；整链阈值未给；待定，首轮测基线后确定 | 无重投影的型号记 N/A，不用内容延迟替代 |
| A2 编码 | 3.5 | ≤ 5 ms；设计目标，非已验证结论 | 无 B 帧、切片编码、帧内刷新等配置需记录 |
| A2 传输 | 3.5 | ≤ 2 ms；设计目标，非已验证结论 | 本组为 USB 网络近似，结论不外推为方案 A2 等价实现 |
| A2 解码 | 3.5 | ≤ 5 ms；设计目标，非已验证结论 | 视解码端硬件能力 |
| A2 重投影 + 显示 | 3.5 | ≤ 5 ms；设计目标，非已验证结论 | 现成链路可能不含重投影，按实际标注 |
| B 编码 | 3.5 | ≤ 5 ms；设计目标，非已验证结论 | 记录编码器与配置 |
| B 传输 | 3.5 | ≤ 5 ms（p95）；设计目标，非已验证结论 | 记录 Wi-Fi 标准、频段、RSSI、重传 |
| B 解码 | 3.5 | ≤ 5 ms；设计目标，非已验证结论 | 解码端能力可能成为瓶颈 |
| B 重投影 + 显示 | 3.5 | ≤ 5 ms；设计目标，非已验证结论 | 现成链路可能不含重投影 |
| 端到端内容延迟 | 3.5 | 方案未给合计阈值；待定，首轮测基线后确定 | 不把各环节预算相加冒充实测总延迟 |
| 帧率 | 3.6 | 双目光波导目标 60 Hz 起、可补帧到 90 Hz 以上；设计目标，非已验证结论 | 现成设备实际值记录；未达不直接判失败，作为选型输入 |
| 跳帧率 | 3.5 / 4.1 | 待定，首轮测基线后确定 | 记录 0–5 与 25–30 分钟两个窗口 |
| 画质 | 3.3 / 4.2 | A1 定位为无压缩；设计目标，非已验证结论；A2/B 画质阈值待定，首轮测基线后确定 | 用测试图案与对比记录，不用主观“看起来还行”代替 |
| 最小可读字号 | 3.6 / 4.1 | 待定，首轮测基线后确定 | 记录 A1/A2/B 三条链路的基线 |
| 30 分钟 p95 漂移 | 3.5 | 待定，首轮测基线后确定 | 比较 0–5 与 25–30 分钟 p95 |
| 温度/降频 | 3.5 / 7.3 | 待定，首轮测基线后确定；上限按器件规格与适用标准 | 本组不自行设安全上限，只记录温升与降频行为 |
| 兼容通过率 | 4.2 | L0 目标覆盖桌面与普通应用；设计目标，非已验证结论；具体通过率待定，首轮测基线后确定 | DRM/反作弊/安全窗口按“预期失败”记录，不计入缺陷 |

> **A2 特别说明：** 若没有现成“主机 USB 3.x 编码流直接进眼镜”的方案，本组按第 3 节的 USB 网络 + Moonlight 近似。该近似不能证明方案 A2 的“USB 3.x 数据通道直接进眼镜”已经可行；A2 的真实链路仍需等有相应入口的硬件或自研样机验证。

### 1.7 数据记录表模板

**表 1-1 测试条件与版本登记**

| 条件编号 | 路径 | 设备别名 | 眼镜固件 | 主机 OS/驱动 | 串流软件版本 | 线缆/接口 | 分辨率/刷新 | 编码/码率 | 备注 |
| --- | --- | --- | --- | --- | --- | --- | --- | --- | --- |
| 待填 | A1/A2/B | 待填 | 待填 | 待填 | 待填 | 待填 | 待填 | 待填 | 待填 |

**表 1-2 延迟原始记录（每个条件至少 30 行）**

| 样本号 | 条件编号 | 路径 | 测试项 | 采集时间 | 输入/动作时间戳 | 显示边沿时间戳 | 延迟 (ms) | 帧号/场次 | 有效 | 无效原因/备注 |
| --- | --- | --- | --- | --- | --- | --- | --- | --- | --- | --- |
| 待填 | 待填 | A1/A2/B | 内容/运动 | 待填 | 待填 | 待填 | 待填 | 待填 | 是/否 | 待填 |

**表 1-3 延迟汇总**

| 条件编号 | 路径 | 编码/码率 | 分辨率/刷新 | 样本数 n | p50 (ms) | p95 (ms) | 最大值 (ms) | 备注 |
| --- | --- | --- | --- | --- | --- | --- | --- | --- |
| 待填 | A1/A2/B | 待填 | 待填 | 待填 | 待填 | 待填 | 待填 | 待填 |

**表 1-4 帧率、跳帧与画质**

| 条件编号 | 路径 | 测试时长 | 平均 fps | 最低 fps | 应显示帧 | 丢弃/迟到帧 | 跳帧率 | 画质问题 | 备注 |
| --- | --- | --- | --- | --- | --- | --- | --- | --- | --- |
| 待填 | A1/A2/B | 待填 | 待填 | 待填 | 待填 | 待填 | 待填 | 待填 | 待填 |

**表 1-5 最小可读字号**

| 条件编号 | 路径 | 受试者编号 | 字符类型 | 缩放 | 最小可读字号 (pt) | 等效角分 (arcmin) | 5 次中正确次数 | 备注 |
| --- | --- | --- | --- | --- | --- | --- | --- | --- |
| 待填 | A1/A2/B | 待填 | 中/英/数字 | 100%/125%/150% | 待填 | 待填 | 待填 | 待填 |

**表 1-6 30 分钟稳定性**

| 条件编号 | 路径 | 时段 | p95 (ms) | 平均 fps | 前框温度 (°C) | 左镜腿温度 (°C) | 右镜腿温度 (°C) | 环境温度 (°C) | 是否降频 | 备注 |
| --- | --- | --- | --- | --- | --- | --- | --- | --- | --- | --- |
| 待填 | A1/A2/B | 0–5 min | 待填 | 待填 | 待填 | 待填 | 待填 | 待填 | 是/否 | 待填 |
| 待填 | A1/A2/B | 25–30 min | 待填 | 待填 | 待填 | 待填 | 待填 | 待填 | 是/否 | 待填 |

**表 1-7 软件兼容清单**

| 类别 | 应用/场景（测试用会话） | 路径 | 结果（通过/部分通过/失败/预期失败） | 主要限制 | 是否方案 4.2 已知边界 | 备注 |
| --- | --- | --- | --- | --- | --- | --- |
| 办公 | 待填 | A1/B | 待填 | 待填 | 否 | 待填 |
| 开发 | 待填 | A1/B | 待填 | 待填 | 否 | 待填 |
| 影音 | 本地/浏览器视频 | A1/B | 待填 | 待填 | 否 | 待填 |
| 影音 | DRM 流媒体 | A1/B | 预期失败 | DRM/HDCP 保护内容不可捕获 | 是 | 不绕过 |
| 游戏 | 窗口/无边框游戏 | A1/B | 待填 | 待填 | 否 | 待填 |
| 游戏 | 反作弊游戏 | A1/B | 预期失败 | 反作弊/安全机制 | 是 | 不绕过 |
| 手机应用 | Android 投屏/桌面模式/模拟器 | A1/B | 待填 | 待填 | 否 | 待填 |
| 手机应用 | 另一手机生态投屏/桌面模式（仅记录是否可用） | A1/B | 待填 | 待填 | 否 | 待填 |
| 安全窗口 | 登录/提权/口令输入框 | A1/B | 预期失败 | 安全桌面/安全窗口不可捕获 | 是 | 不绕过 |
| 安全窗口 | 银行类安全界面 | A1/B | 预期失败 | 安全窗口/DRM | 是 | 不绕过 |

### 1.8 风险、注意事项与失败时的替代做法

| 风险/注意事项 | 影响 | 失败时的替代做法 |
| --- | --- | --- |
| USB-C DP Alt Mode 兼容性差异（线缆、Hub、供电、主机接口） | 无画面、闪屏、分辨率/刷新率受限 | 换认证线缆、换直连口、用带供电的扩展坞；记录每种组合，不把“换线后好了”当成原配置通过 |
| 眼镜端无重投影或稳定能力 | A1 的运动到光子不可测，内容延迟不能替代 | 标注“不适用”；把 6DoF 运动到光子放到第 2 组；A1 只报告显示链路 |
| A2 无等价现成入口 | 只能得到近似上界，不能证明方案 A2 | 明确写“USB 网络 + Moonlight 近似”；不外推；等有 USB 3.x 编码流入口的硬件再测 |
| 虚拟显示驱动签名/系统版本/多显示器行为 | 驱动装不上、虚拟屏不出现在正确位置 | 换受支持的系统版本或测试签名环境；记录驱动版本；必要时用 Linux Breezy Desktop 对照 |
| DRM / HDCP 内容黑屏 | 影音兼容项失败 | 按方案 4.2 记为“预期失败”，不尝试绕过；另测非 DRM 本地/浏览器视频作为画质与延迟样本 |
| 反作弊/安全窗口拦截 | 游戏或安全界面不可用 | 记为“预期失败”，不绕过；用非反作弊游戏测串流链路本身 |
| Wi-Fi 干扰、信道拥塞、解码端瓶颈 | p95 抖动、跳帧，误判为眼镜问题 | 固定信道/频宽、靠近路由器、用有线回程；换解码端或降低码率复测；分开记录网络与解码端指标 |
| 30 分钟热降频 | 25–30 分钟 p95 变差，误判为软件退化 | 记录温度、频率、亮度变化；必要时在相同温度起点复测；不通过修改阈值掩盖 |
| 测量链不确定度大于目标延迟 | 延迟数据不可用 | 提高相机帧率、改用光电法、校准曝光/触发；不确定度仍不满足时，只报告“低于测量分辨率” |
| 受试者差异、字号图卡打印误差 | 可读字号结论不可比 | 增加受试者、统一图卡和距离、记录矫正状态；图卡重新校准后整组重测 |
| 现成设备不代表自研整机 | 结论被误用为产品承诺 | 报告首页写明“现成链路基线”；所有结论标注设备、固件、配置和日期 |

---

## 第 2 组：6DoF 虚拟屏锚定 + 手势交互

### 2.1 目的与对应方案章节

本组对应方案第 9 节“建议的第一步验证”第 2 项：用现成 6DoF 一体机或光学透视 AR 开发套件，验证“虚拟屏锚定在真实桌面 + 手势操作”的交互是否满足需求。重点是 6DoF 真实画面交互，不追求完整 VR 游戏；不要求现成设备具备自研眼镜的全部能力。

要回答的问题：

- 虚拟屏能否稳定锚定在真实桌面上方，而不是固定在眼前。
- 佩戴者走动、转头后，虚拟屏相对桌面的漂移量有多大；是否影响阅读和点选。
- 手势点选、拖拽、缩放的成功率、完成时间和误触率如何；目标大小、距离、手部姿态如何影响结果。
- 连续使用 30 分钟的主观舒适与疲劳如何；是否有眼干、颈酸、眩晕。
- 与 PC 串流结合时，虚拟显示器能否作为锚定屏，延迟、帧率、漂移和可读性是否仍可接受。

对应章节：

| 方案章节 | 本组怎么用 |
| --- | --- |
| 第 3.1 节 VR 级能力、AR 效果 | 6DoF 追踪、空间锚定、手势交互、平面/物体识别是基础能力；不追求完整 VR 游戏 |
| 第 3.2 节 算力分工 | 追踪/手势/重投影在本地，内容渲染在主机或云；本组用现成一体机近似本地追踪 + 主机渲染 |
| 第 3.3 节 连接方式 | B Wi-Fi 串流作为“PC 串流 + 锚定屏”的链路 |
| 第 3.5 节 延迟预算 | B 链路逐环节设计目标；运动到光子与网络延迟解耦 |
| 第 4.2 节 兼容分层 | L0 虚拟显示器在眼镜里作为虚拟屏幕锚定在真实空间（如桌面上方），可多屏摆放 |
| 第 7.3 节 佩戴无感 | 2 小时连续佩戴的主观舒适目标；本组 30 分钟只作早期基线，不把 2 小时目标当 30 分钟结论 |
| 第 9 节 第一步验证 | 本组即第 2 项；结论服务于交互方案与 6DoF 硬件选型 |

【项目判断】现成一体机通常是视频透视（VST），而方案要求光学透视（OST）。本组应尽量同时准备一台 OST 开发套件做对照；若只能拿到 VST 设备，结论要写明“VST 近似”，不能直接代表 OST 的亮度、视场和真实画面体验。

### 2.2 设备清单

| 类别 | 建议型号或规格 | 数量 | 备注 |
| --- | --- | --- | --- |
| 6DoF 一体机（主） | 现成 6DoF 一体机；Snapdragon XR2+ Gen 2 平台（[S21](sources.md#s21)）/ XR2 Gen 2 公开产品类别 | 1 台 | 候选，待核实具体型号；需支持手部追踪、空间锚定/平面识别、OpenXR；待询价 |
| 光学透视 AR 开发套件（对照） | 现成光学透视 AR 开发套件 | 1 套 | 候选，待核实；用于真实光学透视下的锚定、亮度、视场对照；待询价 |
| PC 主机 | Windows 11，独立 GPU，Wi-Fi 6/7，支持硬件编码 | 1 台 | 现有设备或待询价；记录 GPU/驱动/编码器 |
| Wi-Fi 路由器 | Wi-Fi 6/7 三频路由器 | 1 台 | 候选，待核实；需能固定信道/频宽；待询价 |
| 串流软件 | ALVR [S24](sources.md#s24) / WiVRn [S25](sources.md#s25) / Sunshine + Moonlight [S26](sources.md#s26) / Virtual-Display-Driver [S27](sources.md#s27) | 各 1 套 | 开源；按设备平台选择；许可与兼容待核实 |
| 测试场景 | 自建 OpenXR 最小场景：锚定屏、点选/拖拽/缩放目标、事件记录 | 1 套 | 仅测试用，不含业务代码；需记录目标 ID、时间戳、命中/未命中；待开发 |
| 外部参考 | 光学动作捕捉或摄影测量系统 | 1 套 | 用于漂移真值；精度需优于待测漂移一个量级，具体待确认；候选，待核实；待询价 |
| 标定与标记 | 标定板、桌面标记点、卷尺/激光测距 | 1 套 | 打印精度待校准；标记点用于建立桌面坐标系；待询价 |
| 头戴相机（可选） | 第一视角摄像头 | 1 套 | 用于回放复核；不记录人脸；待询价 |
| 温度 | 热电偶/红外测温仪 | 1 套 | 测前框、镜腿；待询价 |
| 问卷 | 舒适度/疲劳/模拟器不适量表（SSQ）问卷（自建，匿名） | 1 套 | 0–10 量表 + 开放问题；不收集个人信息 |
| 受试者 | 矫正视力正常、无严重前庭疾病；≥5 人 | 5–8 人 | 匿名编号、知情同意、可随时停止 |
| 安全 | 防滑垫、安全边界、陪同人员 | 1 套 | 站立/走动测试必须有陪同；待询价 |
| 计时 | 秒表/计时脚本 | 1 套 | 记录完成时间和操作间隔 |

【公开资料】[S21](sources.md#s21) 公开 XR2+ Gen 2 平台；具体一体机的型号、手部追踪精度、锚定 API 与光学方案需按设备核实，不能由平台页面推定整机体验。

### 2.3 测试环境与前置条件

**场地与桌面**

- 使用至少 3 m × 3 m 的空旷区域，地面防滑，移除桌椅、线缆等障碍；设置安全边界，站立/走动测试必须有陪同人员在旁。
- 桌面高度首轮统一为 0.75 m（记录实际值）；桌面布置 4–6 个标记点，建立桌面坐标系；标记点位置用卷尺/激光测距记录。
- 虚拟屏初始位姿首轮固定为：屏幕中心距桌面约 0.45 m、距坐姿眼位约 0.8 m，屏幕朝向佩戴者；该参数是测试条件，不是方案指标，后续可按交互方案调整。
- 环境光可调并记录实际照度；避免阳光直射、强反光和纯白无纹理墙面；必要时增加墙面纹理或标记点，减少追踪丢失。
- 房间内避免大面积镜面、动态人群和强频闪光源；测试期间保持布局稳定，不移动桌面和标记点。

**设备与校准**

- 记录头显/开发套件的固件、系统版本、OpenXR 运行时、手部追踪版本、刷新率、亮度、瞳距（IPD）、护目镜间距。
- 每名受试者先调整 IPD 和佩戴位置，完成手部追踪校准；给 2 分钟练习，确认能完成点选、拖拽、缩放各 3 次后再开始计时。
- 清除旧房间地图/锚点，按统一流程重新建图；记录建图方式、锚点类型（平面/标记/空间锚点）和是否持久化。
- 外部参考系统先校准到桌面坐标系，记录参考精度；若没有动作捕捉，用标记点 + 摄影测量，报告中注明不确定度，不能把“看起来没动”当成零漂移。

**串流与网络**

- PC 有线接路由器，头显 Wi-Fi 接入；记录频段、信道、RSSI、协商速率；测试期间关闭其他大流量设备。
- 先测本地锚定与手势，再测 PC 串流 + 锚定屏；避免把网络延迟混入追踪/锚定结论。
- 串流分辨率/刷新率/码率固定并记录；若设备支持异步空间扭曲/重投影/插帧，记录是否开启，因为会影响运动到光子和漂移的主观感受。
- PC 串流优先用 Sunshine/Moonlight 的平面串流（虚拟显示器作为锚定屏）；ALVR/WiVRn 只作 OpenXR 对照，不混入同一组通过率。

**受试者与安全**

- 受试者匿名编号；测试前说明流程、可随时停止；不记录姓名、联系方式、人脸视频。
- 站立/走动前确认安全边界；佩戴者视线被遮挡时由陪同人员引导；出现眩晕、恶心、头痛、眼干时立即停止。
- 不在有台阶、玻璃、尖锐物或人员的区域走动；不进行快速转身、跑跳等高风险动作。

### 2.4 测试步骤

1. **登记与编号。** 给设备、测试场景、受试者分配别名；记录固件、运行时、刷新率、手部追踪版本、锚定方式。
2. **布置桌面与参考。** 按本组 2.3 节布置桌面、标记点和安全边界；校准外部参考到桌面坐标系；记录桌面高度、屏幕初始位姿和参考精度。
3. **佩戴与校准。** 调整 IPD/佩戴位置，完成手部追踪校准；练习点选、拖拽、缩放各 3 次；记录是否需要重复校准。
4. **建立锚定屏。** 在桌面上方放置虚拟屏，记录初始位姿（x, y, z, yaw, pitch, roll）；截取画面和外部参考读数；确认屏幕不跟随头部。
5. **静态漂移。** 坐姿、头部自然小幅活动、无手势操作，连续 10 分钟；每 10 秒采样一次虚拟屏位姿，记录最大/平均漂移；同时记录追踪丢失次数。
6. **转头漂移。** 坐姿完成 yaw ±60°、pitch ±30° 的转头，各 10 个来回；回到初始视线后测量虚拟屏相对桌面的位姿；有条件时在转头过程中连续采样位姿，记录最大动态漂移；同时记录追踪丢失、画面跳动和重锚。
7. **走动漂移。** 站立，向前走约 3 m、转身 180°、返回座位；重复 3 次；每次返回后测量虚拟屏位姿；有条件时在走动过程中连续采样，记录最大动态漂移；同时记录追踪丢失、重锚和是否需要重新定位。
8. **手势点选。** 在屏幕中心和边缘布置目标，目标角大小/距离分级；每种条件 30 次点选；记录成功/失败、完成时间、错误目标、是否需要用另一只手辅助。
9. **手势拖拽。** 拖动窗口/滑块/图标，每种条件 30 次；记录起点命中、拖动过程是否脱手、落点误差、完成时间。
10. **手势缩放。** 按设备支持的缩放手势（单/双手）缩放图片/窗口，每种条件 30 次；记录缩放方向、比例误差、是否误触其他控件、完成时间。
11. **误触测试。** 手自然放在目标附近、从目标前经过、做非交互手势，各 30 次；记录是否触发意外点选/拖拽/缩放；区分“系统误识别”和“受试者误操作”。
12. **30 分钟连续使用。** 交替进行阅读、窗口拖拽、图片缩放和视频观看；每 5 分钟记录舒适度、疲劳、眼干、颈酸、眩晕；测试前后各填一次 SSQ；记录温度、追踪丢失和漂移。
13. **PC 串流 + 锚定屏。** 用 PC 虚拟显示器输出桌面，优先经 Sunshine/Moonlight 平面串流到头显；把串流窗口作为锚定屏放在桌面上方；测延迟、帧率、跳帧、漂移、最小可读字号和 15 分钟稳定性；记录串流参数与网络指标。
14. **会话恢复。** 依次执行睡眠/唤醒、应用重启、主机重连、走动后返回；记录锚点是否保持、重锚时间、重锚后漂移；若必须重新建图，记录原因。
15. **汇总与复测。** 对漂移异常、手势成功率异常、舒适度骤降的条件，按同一配置复测；保留全部原始记录和问卷。

### 2.5 测量指标与方法

**2.5.1 虚拟屏锚定漂移**

- **定义**：虚拟屏在桌面坐标系中的实测位姿与初始参考位姿之差；位置用 mm，姿态用度（yaw/pitch/roll）。
- **采样点**：屏幕中心 + 四个角；至少记录中心和一角，条件允许时记录四角，观察是否有旋转/缩放漂移。
- **测量方法**：外部光学参考/摄影测量读取头显与桌面标记的相对位姿，再换算虚拟屏位姿；若只能通过系统 API 读取锚点位姿，需注明“系统自报，非外部真值”。
- **阶段**：初始、静态 10 分钟、转头后、走动后、30 分钟结束、串流 15 分钟结束。
- **统计**：每个阶段记录最大漂移、平均漂移、漂移方向；样本数、采样间隔和参考不确定度一并记录。

**2.5.2 手势交互**

- **成功率** = 成功完成次数 ÷ 总试次；成功定义需在测试前固定（如“命中正确目标并完成预期动作”）。
- **误触率** = 非预期触发次数 ÷ 误触测试机会数；同时记录误触类型（误点、误拖、误缩放、误关闭）。
- **完成时间**：从目标出现/手势开始到动作完成的时间；记录中位数和 p95。
- **目标条件**：中心/边缘、近/远、不同角大小；左右手分别记录；记录目标是否被手部遮挡。
- **失败分类**：未命中、命中错误目标、拖拽脱手、缩放方向错误、系统未识别、受试者主动放弃。

**2.5.3 主观舒适与疲劳**

- 每 5 分钟记录 0–10 舒适度（10 最舒适）和 0–10 疲劳（10 最疲劳）；记录眼干、颈酸、眩晕、恶心、头痛的有无与程度。
- 测试前后填 SSQ；记录总分和主要症状；不把 SSQ 当作诊断，只作相对比较。
- 记录受试者是否提前停止、停止原因和时间；提前停止也是结果，不能从数据中删除。
- 30 分钟是早期基线；方案 7.3 的 2 小时连续佩戴目标是后续整机验收，不直接套用到本组。

**2.5.4 PC 串流 + 锚定屏**

- 串流链路按第 1 组 B 的方法测：编码、传输、解码、重投影+显示分段记录；p50/p95；至少 30 个延迟样本。
- 记录分辨率、刷新率、码率、编码格式、RSSI、重传、跳帧率；区分“网络抖动”和“头显解码/渲染瓶颈”。
- 锚定屏可读性：在固定距离下测最小可读字号；记录串流压缩对文字边缘的影响。
- 漂移：串流前后各测一次虚拟屏位姿；记录串流期间是否出现锚点漂移、画面跟随头部、黑边/花屏。
- 温度：记录前框、镜腿和显示面温度；记录是否降频、亮度下降。

**2.5.5 追踪与会话恢复**

- 记录追踪丢失次数、每次丢失时长、恢复方式（自动恢复/重锚/重启应用/重新建图）。
- 记录睡眠/唤醒、应用重启、主机重连、走动返回后的锚点保持情况；重锚时间从操作开始到画面稳定可用。
- 记录是否必须使用手柄/手机辅助；若手势不可用，记录替代输入方式。

**2.5.6 光学透视对照（如使用 OST 套件）**

- 记录亮度、对比度、视场、透视效果、重影/彩虹效应、户外可见性（仅室内测试则注明）。
- 记录虚拟屏在真实桌面上的遮挡关系、文字可读性和长时间观看舒适度；与 VST 设备分开报告，不混算。

### 2.6 通过标准

以下通过标准逐条引用方案 v0.7；属于【设计目标】的均标注为“设计目标，非已验证结论”；方案没有数值的，统一写“待定，首轮测基线后确定”，本组不补造数字。

| 指标 | 方案依据 | 通过标准 | 说明 |
| --- | --- | --- | --- |
| 虚拟屏锚定在真实桌面上方 | 3.1 / 4.2 | 能在桌面坐标系中稳定放置，不随头部移动；设计目标，非已验证结论 | 二值判断 + 记录漂移；不是“固定在眼前” |
| 走动/转头漂移 | 3.1 / 3.5 | 方案未给数值；待定，首轮测基线后确定 | 记录 mm/°，分静态、转头、走动、30 分钟 |
| 手势点选/拖拽/缩放 | 3.1 | 三类手势均可完成；设计目标，非已验证结论；成功率阈值待定，首轮测基线后确定 | 记录成功率、完成时间、失败类型 |
| 误触 | 3.1 | 待定，首轮测基线后确定 | 记录 idle/pass-by 误触 |
| 30 分钟舒适与疲劳 | 7.3（2 小时佩戴目标） | 30 分钟阈值方案未给；待定，首轮测基线后确定 | 不把 2 小时目标当 30 分钟结论 |
| PC 串流 + 锚定屏 | 3.3 B / 3.5 | B 传输 ≤5 ms（p95）、编解码各 ≤5 ms；设计目标，非已验证结论；端到端待定，首轮测基线后确定 | 逐环节记录，不把各环节相加冒充实测 |
| 串流后锚定漂移 | 3.1 / 3.5 | 方案未给数值；待定，首轮测基线后确定 | 串流前后对比 |
| 会话恢复/重锚 | 3.4 / 5.1 | 方案未给数值；待定，首轮测基线后确定 | 记录是否保持、重锚时间 |
| 追踪丢失 | 3.1 | 待定，首轮测基线后确定 | 记录次数/时长/恢复方式 |
| 光学透视显示 | 3.1 | 方案只给能力要求，无阈值；待定，首轮测基线后确定 | 记录亮度/视场/可读性；VST 与 OST 分开 |

> **判定口径：** “锚定在桌面上方”是方案 3.1/4.2 的能力要求，属于设计目标，不是已验证结论；漂移多大算“可接受”、手势成功率多少算“通过”、30 分钟舒适度多少算“通过”，方案均未给数值，首轮只建立基线，不在本计划中编造阈值。

### 2.7 数据记录表模板

**表 2-1 虚拟屏锚定漂移**

| 条件编号 | 设备 | 测试阶段 | 动作/时长 | 参考位姿 (x,y,z,yaw,pitch,roll) | 实测位姿 | Δ位置 (mm) | Δ角度 (°) | 追踪丢失次数 | 备注 |
| --- | --- | --- | --- | --- | --- | --- | --- | --- | --- |
| 待填 | 待填 | 初始/静态/转头/走动/30 min/串流后 | 待填 | 待填 | 待填 | 待填 | 待填 | 待填 | 待填 |

**表 2-2 手势交互**

| 条件编号 | 手势 | 目标位置 | 目标角大小 (°) | 距离 | 试次 | 成功 | 失败类型 | 成功率 | 平均完成时间 | 误触次数 | 备注 |
| --- | --- | --- | --- | --- | --- | --- | --- | --- | --- | --- | --- |
| 待填 | 点选/拖拽/缩放 | 中心/边缘 | 待填 | 近/远 | 待填 | 待填 | 待填 | 待填 | 待填 | 待填 | 待填 |

**表 2-3 主观舒适与疲劳**

| 受试者编号 | 时间点 | 舒适度 0–10 | 疲劳 0–10 | SSQ 总分 | 眼干/颈酸/眩晕 | 是否继续 | 备注 |
| --- | --- | --- | --- | --- | --- | --- | --- |
| 待填 | 0/5/10/15/20/25/30 min | 待填 | 待填 | 待填 | 待填 | 是/否 | 待填 |

**表 2-4 PC 串流 + 锚定屏**

| 条件编号 | 路径 | 编码/码率 | 分辨率/刷新 | 延迟 p50 (ms) | 延迟 p95 (ms) | 平均 fps | 跳帧率 | 漂移 mm/° | 最小可读字号 (pt) | 温度 (°C) | 备注 |
| --- | --- | --- | --- | --- | --- | --- | --- | --- | --- | --- | --- |
| 待填 | B Wi-Fi | 待填 | 待填 | 待填 | 待填 | 待填 | 待填 | 待填 | 待填 | 待填 | 待填 |

**表 2-5 会话恢复与重锚**

| 操作 | 锚点是否保持 | 重锚时间 | 重锚后漂移 | 追踪丢失 | 备注 |
| --- | --- | --- | --- | --- | --- |
| 睡眠/唤醒 | 是/否 | 待填 | 待填 | 待填 | 待填 |
| 应用重启 | 是/否 | 待填 | 待填 | 待填 | 待填 |
| 主机重连 | 是/否 | 待填 | 待填 | 待填 | 待填 |
| 走动后返回 | 是/否 | 待填 | 待填 | 待填 | 待填 |

### 2.8 风险、注意事项与失败时的替代做法

| 风险/注意事项 | 影响 | 失败时的替代做法 |
| --- | --- | --- |
| 纯白墙、弱光、镜面导致追踪丢失 | 锚点漂移、画面跳动、测试中断 | 增加墙面纹理/标记点、调整照明；记录丢失时长；不要用“重启后好了”掩盖 |
| 手部遮挡、光照变化、肤色差异 | 手势识别率下降、误触增加 | 换手势角度/距离、增加照明、用控制器兜底；记录不同条件下的差异，不把最好条件当总体结论 |
| 长时间举手导致“抬手疲劳” | 30 分钟舒适度下降，误判为设备问题 | 使用扶手/桌面支撑、缩短连续手势段、调整屏幕距离；把疲劳与追踪/手势精度分开记录 |
| 眩晕/恶心/眼干 | 受试者无法完成 30 分钟 | 立即停止；改为坐姿、缩短时长、降低视野运动；记录停止原因，不删除数据 |
| 锚定 API/建图方式差异 | 不同设备结果不可比 | 固定锚定方式；分别报告平面锚点、标记锚点、空间锚点；不跨方式合并 |
| 外部参考精度不足 | 漂移量不可信 | 用更高精度参考或摄影测量；记录不确定度；不确定度大于漂移时只报告“低于测量分辨率” |
| PC 串流延迟/抖动混入锚定结论 | 误判为 6DoF 漂移 | 先测本地锚定，再测串流；分开记录网络、解码、追踪指标 |
| VST 与 OST 差异 | VST 结果不能代表光学透视 | 尽量加一台 OST 对照；只有 VST 时明确写“VST 近似”，不宣称 OST 已验证 |
| 光学透视亮度/视场/重影 | 室外或高亮环境不可读 | 室内可控光下先测；记录亮度/视场；室外测试另立条件，不与室内混算 |
| 受试者样本小、个体差异大 | 结论外推受限 | 增加受试者、分层记录（性别/视力/经验只写与任务相关的匿名分层）；报告样本量和局限 |
| 走动测试安全隐患 | 碰撞、跌倒 | 清空区域、陪同、防滑垫、限制步速；不安全时改用坐姿转头/原地踏步 |

---

## 第 3 组：5G RedCap 联网与睡眠功耗

### 3.1 目的与对应方案章节

本组对应方案第 9 节“建议的第一步验证”第 3 项：用 RedCap 模组开发板、精密电流表/功耗分析仪和运营商 5G SA 卡，实测 eDRX / PSM 休眠、唤醒时间、强弱信号下的持续速率与 RTT，并对照方案第 6.3 节的串流最低网络要求。特别针对 S23 中“RG255C eDRX 不生效、休眠电流偏高”的公开用户反馈设计专项用例；该反馈是【公开资料·用户反馈，未经本项目复现】[S23](sources.md#s23)，是待核实线索，不是已验证结论。

要回答的问题：

- S2 待机场景下，eDRX / PSM 是否真正生效；休眠电流是多少；电流波形是否出现预期休眠窗口。
- 从休眠/寻呼唤醒到“可用”需要多长时间；p50/p95 是多少。
- 强信号和弱信号下，持续下行/上行速率、RTT p95、丢包如何；能否满足方案 6.3 的云串流、视频通话、串流+通话并发三档要求。
- S23 的 eDRX 不生效/休眠电流偏高是否能在本组复现；在哪些配置、频段、SIM、固件下出现。
- 模组/评估板的功耗与发热是否会影响持续速率；需要哪些整机层面的补充验证。

对应章节：

| 方案章节 | 本组怎么用 |
| --- | --- |
| 第 5.1 节 分级功耗状态 | S2 待机：主处理器挂起、协处理器只跑佩戴检测/IMU/唤醒词、蜂窝 eDRX/PSM；本组只测蜂窝子系统，不代表整机 S2 |
| 第 5.2 节 技术要点 | 蜂窝节能依赖模组和运营商对 eDRX/PSM 的支持；S23 用户反馈提示必须实测休眠电流 |
| 第 6.3 节 蜂窝候选与串流最低要求 | 云串流、视频通话/会议、串流+通话并发的下行/上行/RTT 设计目标 |
| 第 9 节 第一步验证 | 本组即第 3 项；结论服务于机身蜂窝选型与线控模块策略 |

【项目判断】本组用模组评估板替代整机时，能测到的是“蜂窝子系统 + 评估板”的功耗和性能；整机 S2 还要加上协处理器、传感器、电源转换等负载。报告必须把“模组板级”和“整机级”分开，不能把模组休眠电流直接当成整机待机功耗。

### 3.2 设备清单

| 类别 | 建议型号或规格 | 数量 | 备注 |
| --- | --- | --- | --- |
| RedCap 模组评估板（主） | Quectel 5G RedCap EVB Kit [S38](sources.md#s38) + RG255C 系列模组 [S23](sources.md#s23)；R17 RedCap、5G SA | 1 套 | 需确认固件支持 eDRX/PSM、AT 文档、频段与天线接口；待询价 |
| RedCap 模组评估板（对照） | 基于 Snapdragon X35 的 RedCap 模组/评估板 [S22](sources.md#s22) | 1 套 | 候选，待核实具体模组与评估板；待询价 |
| 备用蜂窝板（可选） | LTE Cat4 或另一款 RedCap 模组 | 1 套 | 候选，待核实；用于对比/替代；待询价 |
| 运营商 5G SA 测试卡 | 数据为主，语音/短信按测试需要 | 1–2 张 | 不写运营商名称；需确认 RedCap 接入、eDRX/PSM 策略与套餐限制；待询价或由运营商提供 |
| 精密源表/功耗分析仪 | µA 级静态电流 + 高速动态采样 | 1 台 | 候选，待核实具体型号；需能记录平均/峰值/波形；待询价 |
| 分流电阻 + 示波器/数据采集 | µs 级动态电流捕获 | 1 套 | 用于捕捉唤醒/发射脉冲；需校准；待询价 |
| 射频屏蔽箱 + 可编程衰减器 | 覆盖被测频段 | 1 套 | 用于强弱信号可重复测试；需确认频段/功率/接口；待询价 |
| 天线 | 配套被测频段 | 2 根 | 待询价 |
| 测试服务器 | 公网云主机或本地服务器 | 1 台 | 运行 iperf3、RTT 探测、HTTP 测试；待询价 |
| 控制主机 | Windows/Linux，USB/UART/GPIB 接口 | 1 台 | 运行 AT 脚本、采集电源数据；现有设备或待询价 |
| 温度/环境记录 | 热电偶、温湿度记录仪 | 1 套 | 记录模组、板卡、屏蔽箱与环境温度；待询价 |
| 测试软件 | iperf3、ping/UDP 探测、Python 采集脚本 | 1 套 | 开源/自建；记录版本与参数 |
| 电源 | 按模组规格的可编程直流电源 | 1 台 | 与源表配合；待询价 |
| 安全与接地 | 防静电手环、屏蔽箱接地线 | 1 套 | 待询价 |

【公开资料】[S23](sources.md#s23) 公开 RG255C 系列为 R17 RedCap、5G SA；[S22](sources.md#s22) 公开 X35 面向 RedCap、可穿戴与 XR 的定位。厂商峰值数字未经本项目复现，不作为通过依据；具体模组/评估板的频段、固件与 eDRX/PSM 能力需按实物核实。

【项目判断】若增加 LTE Cat4 对照，按同一用例测持续速率和 RTT；只有实测满足第 6.3 节才作为备选，不因峰值数字或单次最好结果入选。

### 3.3 测试环境与前置条件

**网络与信号**

- 使用运营商 5G SA 现网或经运营商确认的测试环境；记录频段、PCI、RSRP、SINR、注册状态、PDP/PDU 会话状态；不记录卡号、IMSI、IMEI、真实设备序列号等标识。
- 强弱信号用射频屏蔽箱 + 可编程衰减器实现，优先 conducted（传导）测试，避免空口干扰他人网络。强信号首轮用 0–10 dB 衰减；弱信号逐步增加衰减，直到 RSRP 约 -110 dBm 且仍保持连接，记录实际 RSRP/SINR；若中途掉网，回退一档并记录。以上是测试条件，不是通过阈值。
- 不在没有授权的情况下扫描、接入或干扰他人网络；测试卡、APN、服务器白名单由运营商/项目方按规定提供。
- 记录测试时间、小区负载的主观/可观测情况（如时段、是否拥塞）；同一条件至少重复 3 次，避免单次网络波动被当成设备结论。

**供电与电流测量**

- 按模组规格的标称供电电压供电；使用四线/Kelvin 连接或高边分流，减少线损和 burden voltage。
- 源表量程要覆盖“µA 级休眠—安培级发射脉冲”；记录量程、采样率、分辨率、 burden voltage 和校准日期。
- 优先测“模组 + 必要外围”的板级电流；若测整板，记录板上 LED、电平转换、USB 转串口等额外负载，必要时分别测“只给模组”和“整板”两组。
- 休眠电流不能用 USB 口电流或普通功率计近似；必须用能测 µA 级且能捕捉脉冲的设备。
- 测试前预热 10–15 分钟；记录环境温度、屏蔽箱内温度和板卡温度；避免阳光直射和风扇直吹。

**软件与配置**

- 记录模组型号、固件、AT 版本、评估板版本、天线、SIM/运营商代号、APN 类型（不写具体字符串）、测试服务器别名（不写内部地址与凭据）。
- AT 命令以模组手册为准；本组使用的通用命令包括 `AT+CEREG?`、`AT+CGATT?`、`AT+CSQ`、`AT+CPSMS?`、`AT+CEDRXS?`、`AT+CEDRXRDP`（如支持）；不同厂商/固件可能不同，记录实际命令与返回。
- 固定数据业务状态：注册、PDU 会话激活、无应用数据；关闭 Wi-Fi/蓝牙等无关射频；关闭模组自带的调试输出或高频轮询，避免唤醒。
- 记录 PSM/eDRX 的请求值和网络协商值；若模组不暴露协商值，用电流波形和唤醒行为判断，并在报告中写明“未能直接读取协商值”。

**安全与合规**

- 屏蔽箱接地、防静电；发射时遵守当地无线电管理规定和运营商要求；不长时间在密闭、散热不良的箱体内满功率发射。
- 测试服务器只用于本项目测试；不做端口扫描、压力攻击或影响他人网络的操作。

### 3.4 测试步骤

1. **登记与编号。** 给模组、评估板、SIM、天线、服务器分配别名；记录固件、AT 版本、频段能力、APN 类型、测试时间；不记录卡号/IMEI/序列号。
2. **建立链路。** 连接天线/屏蔽箱/衰减器，插入测试卡，上电注册；用 `AT+CEREG?`、`AT+CGATT?`、`AT+CSQ` 确认注册和信号；建立 PDU 会话；记录频段、RSRP、SINR。
3. **查询能力与当前配置。** 用 `AT+CPSMS?`、`AT+CEDRXS?`、`AT+CEDRXRDP`（如支持）查询 PSM/eDRX 当前配置与动态参数；记录请求值、模组返回值和网络协商值（能读到多少记多少）。
4. **建立对照基线。** 关闭 eDRX 和 PSM，保持注册和 PDU 会话、无应用数据；稳定 10 分钟后，用源表连续记录 ≥10 分钟电流波形；记录平均电流、峰值、唤醒/寻呼脉冲；这是后续节能配置的对照。
5. **PSM 单开。** 按模组支持范围请求 PSM（记录请求的 T3324/T3412 等参数）；确认网络是否授予；保持无应用数据，连续记录至少 10 分钟，且覆盖 ≥3 个 PSM 周期（以较长者为准）；记录休眠窗口、平均/峰值电流、唤醒次数。若网络拒绝，记录拒绝行为，不反复强制。
6. **eDRX 单开。** 按模组支持范围逐档请求 eDRX 周期；确认网络是否授予；每档连续记录至少 10 分钟，且覆盖 ≥3 个 eDRX 周期（以较长者为准）；记录实际周期、休眠窗口、平均/峰值电流、寻呼唤醒次数。不要预设“某个周期一定生效”。
7. **eDRX + PSM 组合。** 同时请求 eDRX 和 PSM，重复第 5–6 步的电流记录；比较单开/组合/关闭三种配置的休眠电流和唤醒行为。
8. **S23 专项：eDRX 不生效/休眠电流偏高。** 按 S23 的公开反馈设计用例：请求 eDRX 后检查网络是否授予、电流波形是否出现预期休眠窗口、休眠电流是否明显高于对照；至少重复 3 次，并分别更换频段、SIM/运营商、固件版本（在可用范围内）复测；记录是否复现、在哪种组合下复现。该反馈未经本项目复现，不能先写成结论。
9. **唤醒到可用。** 在 PSM/eDRX 休眠状态下，优先由服务器发起下行数据（ping/HTTP/iperf）或寻呼触发；AT/控制主机触发只作对照；记录三个时间点：UART/模组可响应、PDU 会话可用、首个应用层请求成功；以“首个应用层请求成功”作为“可用”；每条件 ≥30 次，记录 p50/p95/失败次数。
10. **强信号持续速率。** 在强信号档，用 iperf3 分别测下行 60 秒、上行 60 秒，各 3 次；记录平均速率、最低速率、p50、丢包、频段/RSRP/SINR、温度；再做双向并发 60 秒。
11. **弱信号持续速率。** 增加衰减到弱信号档，重复第 10 步；若掉网，回退一档并记录；弱信号下的结果单独报告，不与强信号混合。
12. **RTT 与丢包。** 对测试服务器做 ping/UDP 探测，至少 300 个样本；记录 p50、p95、最大值、丢包；分别测空闲和持续下行/上行时的 RTT；记录服务器位置/路由（只写可公开的网络位置类别，不写内部地址）。
13. **持续负载与发热。** 以并发下行/上行或持续下行运行 30 分钟，记录速率、RTT、电流、模组/板卡温度；观察是否降速、掉网、重启；记录恢复时间。
14. **对照 6.3 与汇总。** 把强/弱信号结果对照第 6.3 节三档要求；未达标项保留原始数据并记录可能原因（信号、拥塞、服务器、模组、APN、频段）；对异常条件复测一次。

### 3.5 测量指标与方法

**3.5.1 eDRX / PSM 是否真正生效**

- 记录“请求值—网络协商值—实际电流波形”三者；只有电流波形出现与协商周期一致的休眠窗口，才记为“观察到生效”；仅 AT 返回“已设置”不算生效。
- 记录 PSM 的激活时间/周期参数、eDRX 周期、寻呼窗口；若模组不暴露协商值，记录“未能直接读取”，并用波形推断，标注推断性质。
- 记录生效/不生效的判定依据、判定人、原始波形文件编号；不把论坛反馈或厂商宣传当作判定依据。

**3.5.2 休眠电流**

- 稳定窗口至少 10 分钟，且覆盖 ≥3 个节能周期（以较长者为准）；记录平均电流、峰值电流、休眠占空比（休眠窗口时间 ÷ 统计窗口时间）、唤醒/寻呼次数。
- 采样率 ≥1 kSa/s（能捕捉 ms 级脉冲）；记录量程、分辨率、burden voltage、校准日期；µA 级测量要给出不确定度。
- 分别报告“只给模组”“模组 + 必要外围”“整板”三种口径；整机 S2 不能由板级数据直接外推。
- 记录温度对电流的影响；必要时在相同温度起点复测，避免温度漂移被当成配置差异。

**3.5.3 唤醒到可用**

- 定义：从下行数据到达/寻呼唤醒开始，到首个应用层请求成功（如 HTTP 200、iperf 首包）为止；同时记录 UART 可响应、PDU 可用两个中间时间点。
- 每条件 ≥30 次；记录 p50、p95、最大值、失败/超时次数；区分“冷唤醒”（长时间休眠后）和“热唤醒”（刚休眠）。
- 记录唤醒源、寻呼周期、重试次数；若首次失败后重试成功，记录总时间和重试次数。

**3.5.4 持续速率、RTT 与丢包**

- 下行/上行各 60 秒，重复 3 次；记录平均、最低、p50；并发用双向 iperf3 或同时下行/上行。
- RTT 至少 300 个样本，记录 p50/p95/最大值和丢包；区分空闲 RTT 与负载 RTT；RTT 是网络层指标，不等同于串流端到端内容延迟，后者按第 1 组方法另测。
- 同时记录频段、RSRP、SINR、调制/编码（能读到才记）、服务器位置类别、测试时段；不把不同信号条件的数据拼成一个“最好值”。

**3.5.5 对照方案 6.3**

- 按云串流、视频通话/会议、串流+通话并发三档逐项对照；每一档同时看下行、上行、RTT，不用单一速率指标代替。
- 6.3 未区分强/弱信号；强信号先测，弱信号单独报告。弱信号下是否允许降级、降级后是否仍算满足 6.3，方案未明确，标注“待定，首轮测基线后确定；是否允许降级另待方案确认”。
- 未达标时保留原始数据，记录可能原因；不通过修改 6.3 阈值或只报最好一次来“通过”。

**3.5.6 发热与整机边界**

- 记录模组、板卡、屏蔽箱和环境温度；持续负载下是否降速、掉网、重启。
- 记录评估板额外负载（LED、USB 转串口、电平转换等）；整机 S2 还需加协处理器、传感器、电源转换，另立整机测试。

### 3.6 通过标准

以下通过标准逐条引用方案 v0.7；属于【设计目标】的均标注为“设计目标，非已验证结论”；方案没有数值的，统一写“待定，首轮测基线后确定”，本组不补造数字。

| 指标 | 方案依据 | 通过标准 | 说明 |
| --- | --- | --- | --- |
| 云串流（1080p60，H.265/AV1） | 6.3 | 下行 ≥30 Mbps、上行 ≥2 Mbps、RTT p95 ≤50 ms，三项同时满足；设计目标，非已验证结论 | 强信号先测；弱信号另记 |
| 视频通话/会议（1080p30 上行） | 6.3 | 下行 ≥5 Mbps、上行 ≥5 Mbps、RTT p95 ≤100 ms；设计目标，非已验证结论 | 弱网降分辨率是体验策略，不改变本档指标 |
| 串流 + 通话并发 | 6.3 | 下行 ≥35 Mbps、上行 ≥8 Mbps；RTT p95 ≤ 50 ms（方案 v0.7.1 起明确取较严的云串流值）；设计目标，非已验证结论 | 最重负载 |
| 强/弱信号验收口径 | 6.3 | 6.3 未区分强弱信号；弱信号是否允许降级、降级后是否仍算满足，待定，首轮测基线后确定；是否允许降级另待方案确认 | 强信号按上表；弱信号单独报告 |
| eDRX/PSM 是否生效 | 5.1 / 5.2 | 能观察到网络协商参数生效；若协商值不可读，则电流波形出现与请求周期一致的休眠窗口；设计目标，非已验证结论；同时作为验证项；具体电流阈值待定，首轮测基线后确定 | 仅 AT 返回“已设置”不算生效 |
| 休眠电流 | 5.1 | 方案写“待机功耗以整机实测为准”，未给数值；待定，首轮测基线后确定 | 记录板级/模组级，不直接外推整机 |
| 唤醒到可用 | 5.1 | 方案仅给 S1“戴上后画面恢复 ≤1 s”（设计目标，非已验证结论）；S2 蜂窝唤醒无数值；待定，首轮测基线后确定 | 不把 S1 的 1 s 套到 S2 |
| S23 反馈复现 | 5.2 / 9 | 验证项，不设通过/失败阈值；要求用例完整执行并记录“复现/未复现/条件性复现” | 论坛反馈是待核实线索，不是结论 |
| 持续负载稳定性 | 5.1 / 6.3 | 方案未给持续时间/温升阈值；待定，首轮测基线后确定 | 记录 30 分钟速率、RTT、温度、掉网 |

### 3.7 数据记录表模板

**表 3-1 配置与网络状态**

| 用例编号 | 模组/固件 | SIM/运营商代号 | 频段 | 衰减/RSRP/SINR | PSM 请求/协商 | eDRX 请求/协商 | 数据业务状态 | 备注 |
| --- | --- | --- | --- | --- | --- | --- | --- | --- |
| 待填 | 待填 | 待填 | 待填 | 待填 | 待填 | 待填 | 注册/PDU/空闲 | 待填 |

**表 3-2 休眠电流**

| 用例编号 | 配置（关闭/PSM/eDRX/组合） | 稳定窗口 | 平均电流 (µA/mA) | 峰值电流 (µA/mA) | 休眠占空比/唤醒次数 | 温度 (°C) | 采样率/分辨率 | 备注 |
| --- | --- | --- | --- | --- | --- | --- | --- | --- |
| 待填 | 待填 | 待填 | 待填 | 待填 | 待填 | 待填 | 待填 | 待填 |

**表 3-3 唤醒到可用**

| 用例编号 | 唤醒源 | 触发时间 | UART 可响应 | PDU 可用 | 首个应用层成功 | 是否成功 | 备注 |
| --- | --- | --- | --- | --- | --- | --- | --- |
| 待填 | 下行/寻呼/AT | 待填 | 待填 | 待填 | 待填 | 是/否 | 待填 |

**表 3-4 持续速率、RTT 与丢包**

| 用例编号 | 信号档 | 频段/RSRP/SINR | 方向/场景 | 时长 | 平均速率 (Mbps) | 最低速率 (Mbps) | RTT p50 (ms) | RTT p95 (ms) | 丢包 (%) | 备注 |
| --- | --- | --- | --- | --- | --- | --- | --- | --- | --- | --- |
| 待填 | 强/弱 | 待填 | 下行/上行/并发 | 60 s | 待填 | 待填 | 待填 | 待填 | 待填 | 待填 |

**表 3-5 对照方案 6.3**

| 场景 | 方案 6.3 设计目标 | 实测下行 | 实测上行 | 实测 RTT p95 | 判定 | 备注 |
| --- | --- | --- | --- | --- | --- | --- |
| 云串流 | 下行 ≥30 Mbps；上行 ≥2 Mbps；RTT p95 ≤50 ms | 待填 | 待填 | 待填 | 通过/未通过/待定 | 设计目标，非已验证结论 |
| 视频通话/会议 | 下行 ≥5 Mbps；上行 ≥5 Mbps；RTT p95 ≤100 ms | 待填 | 待填 | 待填 | 通过/未通过/待定 | 设计目标，非已验证结论 |
| 串流 + 通话并发 | 下行 ≥35 Mbps；上行 ≥8 Mbps；RTT p95 ≤ 50 ms | 待填 | 待填 | 待填 | 通过/未通过/待定 | 设计目标，非已验证结论 |

**表 3-6 S23 专项用例**

| 用例 | 请求配置 | 网络是否授予 | 休眠电流 | 与对照差异 | 是否复现 | 备注 |
| --- | --- | --- | --- | --- | --- | --- |
| eDRX 请求后不生效 | 待填 | 是/否/部分 | 待填 | 待填 | 复现/未复现/条件性复现 | 待填 |
| 休眠电流偏高 | 待填 | 不适用 | 待填 | 待填 | 复现/未复现/条件性复现 | 待填 |
| 换频段/换 SIM/换固件 | 待填 | 待填 | 待填 | 待填 | 待填 | 待填 |

### 3.8 风险、注意事项与失败时的替代做法

| 风险/注意事项 | 影响 | 失败时的替代做法 |
| --- | --- | --- |
| 运营商/网络不支持 RedCap 接入、eDRX 或 PSM | 无法测到目标状态，误判为模组问题 | 换频段/换运营商/换测试地点；记录网络是否授予；不把“网络不支持”写成“模组不支持” |
| eDRX 请求被网络忽略或协商值不可读 | 无法确认是否生效 | 用电流波形和唤醒行为判断；记录“未能直接读取协商值”；换模组/固件对照；不把 AT 返回“已设置”当生效 |
| S23 反馈无法复现 | 不能证明或否定该反馈 | 记录“未复现”及测试条件；扩大频段/SIM/固件组合；不把单次未复现当成厂商已修复 |
| 休眠电流被评估板外围负载掩盖 | 高估模组休眠电流 | 分别测“只给模组”“模组 + 必要外围”“整板”；记录外围负载；必要时断开 LED/USB 转串口等非必要负载 |
| 源表 burden voltage/量程切换影响测量 | 低电压时模组复位或电流读数偏差 | 用四线/Kelvin 连接、合适量程、外部分流；校准；记录不确定度 |
| 屏蔽箱散热差、温度升高 | 模组降速/掉网，电流漂移 | 控制测试时长、加散热/温度监测；记录箱内温度；必要时在相同温度起点复测 |
| 弱信号测试掉网 | 数据不完整 | 回退一档衰减，记录实际 RSRP/SINR；把“掉网点”作为结果，不伪造弱信号数据 |
| 现网拥塞/服务器路由波动 | 速率/RTT 结果不可重复 | 固定服务器、重复 3 次、记录时段；换服务器/时段复测；区分网络波动与设备问题 |
| 只测峰值速率 | 误以为持续速率达标 | 以 60 秒持续速率和 p95 RTT 为准；峰值只作参考，不写进 6.3 对照 |
| 6.3 未达标就改阈值 | 结论失真 | 保留原始数据，记录差距和原因；6.3 是设计目标，不因实测未达而修改；把差距作为选型输入 |
| 模组板级数据被当成整机 S2 | 低估整机待机功耗 | 报告明确“蜂窝子系统”；整机 S2 另加协处理器、传感器、电源转换后实测 |
| 测试卡/网络标识泄露 | 公开仓库隐私与合规风险 | 只写运营商代号、频段、RSRP/SINR；不写卡号、IMSI、IMEI、序列号、内部地址 |

---

---

## 第 4 组：手表模式功耗（低功耗协处理器）

### 4.1 目的与对应方案章节

验证“断网时退化为手表级设备、由低功耗协处理器负责”是否可行：拍照、录像、录音、看时间和极小本地程序在协处理器上运行时的功耗、启动时间与可用性。对应方案第 2.1–2.3 节（两级功能模式、手表模式硬件、本地程序）和第 5.1 节（S0' 手表模式）、第 6.2 节（协处理器候选）。

本组同时验证决定 #24 新增的三项：主 SoC 睡眠时 BLE 气泡上屏、主 SoC 睡眠时唤醒词、看板态功耗。**看板态放在本组而不是第 3 组**，因为它测的是“主 SoC 睡、MCU / 低速显示通路工作”的低功耗状态，与手表模式共用功耗分析仪、睡眠控制和显示通路；第 3 组只测蜂窝模组本身的休眠电流。主 SoC 的睡眠电流仍需第 3 组配合。

### 4.2 设备清单

| 类别 | 建议型号或规格 | 数量 | 备注 |
| --- | --- | --- | --- |
| 协处理器开发板（主） | STM32N6 系列官方开发板（带摄像头接口、ISP 与 H.264 编码）[S12](sources.md#s12) | 1 | 具体板型候选，待核实；须能接摄像头模组 |
| 协处理器开发板（对照） | BES2800 系列评估板 [S10](sources.md#s10) | 1 | 候选，待核实可获得性；主要对照音频与待机功耗 |
| 摄像头模组 | 与开发板兼容的 MIPI CSI 模组，≥ 5 MP | 1 | 用于拍照、录像 |
| 麦克风 | 数字 MEMS 麦克风（PDM 或 I2S） | 2 | 录音、唤醒词；至少一对可模拟阵列 |
| 小显示屏 | 小尺寸 MIPI DSI 或 SPI 屏 | 1 | 模拟镜片上的时间、状态与看板显示 |
| 手机 / BLE 对端 | 支持 BLE 5.3 的手机或开发板，能发气泡和看板描述 | 1 | A 案另加小 BLE 芯片评估板；B 案用 BES2800 自带蓝牙 |
| 主 SoC 开发板 | 能进入睡眠并接显示开关或等效显示通路 | 1 | 测 BLE 气泡唤醒与看板态；没有则用等效低功耗平台，结论标“近似” |
| 声学测试 | 扬声器 / 耳机、声级计或漏音测试架 | 1 | 防漏音与耳机切换 |
| 功耗分析仪 | 能测 µA 到数百 mA、带时间曲线的直流功耗分析仪 | 1 | 第 3 组可共用 |
| 存储 | microSD 或板载闪存 | 1 | 录像时长测试 |
| 运行时 | WAMR（WebAssembly）[S29](sources.md#s29)、Lua 解释器 | — | 两种都要测（需求方已确认都支持） |

### 4.3 测试环境与前置条件

- 室温 23–27 °C；开发板去掉调试器供电或单独测量调试器电流后扣除。
- 关闭开发板上与眼镜无关的外设（以太网、LED、USB 转串口等），记录关闭清单，保证各轮一致。
- 固件版本、编译选项、主频固定后再测，任何改动都另起一轮。

### 4.4 测试步骤

1. **待机基线**：只运行实时时钟和显示局部刷新（每分钟更新时间），测 10 分钟平均电流。
2. **看时间**：模拟按键唤醒 → 显示时间 5 s → 熄屏，重复 30 次，测单次能耗和唤醒到显示的时间。
3. **拍照**：按键 → 拍照 → 存储，重复 30 次，测单次能耗、按键到成像时间。
4. **录像**：1080p30（若板子不支持则用其最高规格并记录）H.264 录 10 分钟，测平均功耗、温度、存储写入速度、是否丢帧。
5. **录音**：双麦录音 30 分钟，测平均功耗。
6. **小程序**：分别用 WebAssembly 与 Lua 实现同一个计时器小程序和一个清单小程序，测内存占用、启动时间、运行 10 分钟平均功耗；验证沙箱限制（不能访问网络、内存超限被终止、摄像头需确认）。
7. **一天剖面推算**：按方案第 5.3 节剖面中“手表模式 1 小时”的组合，把第 1–6 步结果加权，算出该时段电量。
8. **模式切换**（如有主处理器开发板可配合）：模拟“联网 → 断网”切换，测进入手表模式的时间；拍照时唤醒主处理器 ISP 与只用协处理器 ISP 两种做法各测一次能耗。
9. **BLE 气泡上屏延迟（主 SoC 睡眠）**：在联网或待机状态（非断网手表模式），主 SoC 进入睡眠，手机经 BLE 发“正在打开 QQ”气泡，重复 30 次，测发送到上屏的 p50 / p95。A 案（外加 BLE 芯片）和 B 案（BES2800BP 自带蓝牙）分开测、分开报告；记录 BLE 连接间隔。
10. **主 SoC 睡眠时唤醒词**：主 SoC 睡眠，分别播放安静环境和噪声环境的唤醒词样本，记录唤醒率、误唤醒数和唤醒到响应时间；再测人声检测能否把主 SoC 从睡眠中拉起。阈值待定（M1 定案）。
11. **看板态功耗**：分别测“只看板”“只气泡”“看板 + 气泡”三种状态各 10 分钟平均功耗；记录主 SoC 是否睡眠、刷新率、解码与追踪是否关闭。三种状态都要代入方案第 5.5 节的新使用剖面。

### 4.5 测量指标与方法

| 指标 | 方法 |
| --- | --- |
| 平均功耗（mW） | 功耗分析仪按时间积分，取稳定段 |
| 单次操作能耗（mJ） | 从触发到回到待机的电流曲线积分 |
| 唤醒 / 响应时间（ms） | GPIO 打点 + 示波器或分析仪时间轴 |
| 录像质量 | 实际分辨率、帧率、丢帧数 |
| 运行时资源 | 内存峰值、启动时间 |
| BLE 气泡上屏延迟（ms） | 手机发送打点 + 显示端光电 / 高速相机；p50 / p95，至少 30 个样本；记录 BLE 连接间隔 |
| 唤醒率 / 误唤醒 | 唤醒词样本命中数与静默 / 噪声段误触发数；每组样本数单独记录 |
| 看板态平均功耗（mW） | 功耗分析仪积分；同时记录主 SoC 睡眠状态、刷新率、解码 / 追踪开关 |

### 4.6 通过标准

| 项目 | 标准 | 依据 |
| --- | --- | --- |
| 手表模式平均功耗 | ≤ 0.08 W（[技术路线](technical-roadmap.md)第 1.9 节功耗预算；方案原估算 0.05–0.1 W） | 方案第 5.3 节功耗预算【设计目标，非已验证结论】 |
| 拍照、录像、录音 | 只用协处理器（或短时唤醒主处理器）即可完成，功能完整 | 方案第 2.2 节 |
| WebAssembly 与 Lua | 两种运行时都能在协处理器资源内运行示例小程序，沙箱限制生效 | 方案第 2.3 节 |
| 唤醒到显示时间、拍照响应时间 | 待定，首轮测基线后确定 | — |
| BLE 气泡上屏延迟（主 SoC 睡眠） | ≤0.1 s【设计目标】；报告 p50 / p95，至少 30 个样本；A / B 两案分开判定 | 决定#24；方案第 5.4、6.2 节 |
| 主 SoC 睡眠时唤醒词 | 唤醒率、误唤醒率、唤醒到响应时间待定（M1 定案）；必须证明主 SoC 睡眠时可被唤醒 | 决定#24；方案第 5.4 节 |
| 看板态功耗 | 待定（M1 定案）；只看板、只气泡、看板 + 气泡三种状态分别报告，并代入方案第 5.5 节新剖面 | 决定#24；方案第 5.5 节 |

### 4.7 数据记录表

| 轮次 | 板卡 | 固件版本 | 场景 | 时长 / 次数 | 平均电流 (mA) | 电压 (V) | 平均功耗 (mW) | 单次能耗 (mJ) | 响应时间 (ms) | 温度 (°C) | 备注 |
| --- | --- | --- | --- | --- | --- | --- | --- | --- | --- | --- | --- |
| | | | 待机 | 10 min | | | | — | — | | |
| | | | 看时间 | 30 次 | | | | | | | |
| | | | 拍照 | 30 次 | | | | | | | |
| | | | 录像 | 10 min | | | | — | — | | 分辨率 / 帧率 / 丢帧： |
| | | | 录音 | 30 min | | | | — | — | | |
| | | | 小程序（Wasm） | 10 min | | | | — | 启动： | | 内存峰值： |
| | | | 小程序（Lua） | 10 min | | | | — | 启动： | | 内存峰值： |
| | | | BLE 气泡延迟（主 SoC 睡） | 30 次 | | | | — | | | A/B 案、连接间隔： |
| | | | 唤醒词（主 SoC 睡） | 每组 __ 次 | | | | — | | | 安静 / 噪声： |
| | | | 看板态：只看板 | 10 min | | | | — | — | | 刷新率 / 解码 / 追踪： |
| | | | 看板态：只气泡 | 10 min | | | | — | — | | 主 SoC 是否睡： |
| | | | 看板态：看板 + 气泡 | 10 min | | | | — | — | | |

### 4.8 风险与替代

- 开发板功耗受板载外设影响大，结果只能说明芯片级趋势，**不能直接当整机数据**。
- 若 STM32N6 类 MCU 录像能力不足，替代做法是“录像时唤醒主处理器”，在第 5.3 节剖面里按主处理器功耗重算。
- 若两种运行时同时常驻内存不够，改为按需加载，只常驻其一。
- BLE 气泡延迟受手机 BLE 连接间隔、芯片广播 / 连接参数影响，必须记录参数；A / B 两案分开报告，不合并成一条曲线。
- 主 SoC 开发板的睡眠电流不一定代表目标 SoC，BLE 唤醒结论只说明趋势；最终以 M2 整机复验。
- 看板态如果显示面板不支持低刷新 / 局部刷新，功耗收益会打折；测试记录必须写面板状态。
- 唤醒词样本用合成或公开样本，不用真实用户录音；不记录受试者个人信息。

---

## 第 5 组：视频通话接入（虚拟摄像头）与虚拟形象

### 5.1 目的与对应方案章节

验证“眼镜摄像头和麦克风注册为主机的摄像头和麦克风”（V1 主机通话）能否让主流通话软件不做任何适配就可用，以及虚拟形象能否作为一路视频进入通话。对应方案第 3.7 节（视频通话三种接入方式）和第 3.8 节（虚拟形象）。

### 5.2 设备清单

| 类别 | 建议型号或规格 | 数量 | 备注 |
| --- | --- | --- | --- |
| “眼镜摄像头替身”（有线） | 支持 USB 设备模式的 Linux 小板 + 摄像头模组，配置为 UVC 摄像头 [S30](sources.md#s30)，固定在眼镜架上模拟第一人称视角 | 1 | 模拟方案的有线 UVC 路径 |
| “眼镜摄像头替身”（无线） | 带摄像头的 Android 手机或小板，经 Wi-Fi 推流到 PC，由 PC 端虚拟摄像头接收 | 1 | 模拟无线路径；虚拟摄像头可用 OBS 虚拟摄像头等开源方案（新增来源 N1） |
| 麦克风 | USB 麦克风阵列或带降噪的 USB 音频设备 | 1 | 模拟眼镜麦克风作为主机音频输入 |
| PC（Windows） | 带 NVIDIA 显卡 | 1 | 第 1 组可共用；虚拟形象需 NVIDIA 显卡 |
| Mac / 手机 | 各 1 | — | 覆盖不同主机系统 |
| 通话软件 | 微信（PC）、腾讯会议、Microsoft Teams、Zoom；可选浏览器内 WebRTC 会议 [S31](sources.md#s31) | — | 使用测试账号 |
| 虚拟形象 | Audio2Face-3D SDK [S32](sources.md#s32) + 渲染引擎 + 虚拟摄像头输出 | — | 许可条款先核实 |
| 对端设备 | 一台普通手机或电脑作为通话另一端 | 1 | 主观评价画面与声音 |

### 5.3 测试环境与前置条件

- 通话软件使用专门的测试账号，不用个人或公司账号；对端由测试人员自己操作。
- 网络：同一 Wi-Fi 下测一轮；再用第 3 组 RedCap 链路或手机 5G 热点测一轮弱网。
- 虚拟形象只用测试人员本人形象或卡通模板，画面角标“虚拟形象”。

### 5.4 测试步骤

1. **有线 UVC**：把替身板接 PC，确认系统识别为摄像头；在每个通话软件里选择该摄像头和麦克风，发起 5 分钟视频通话。
2. **无线虚拟摄像头**：替身设备经 Wi-Fi 推流到 PC，PC 端虚拟摄像头输出；重复第 1 步。
3. **屏幕共享**：在通话中共享第 1 组的虚拟显示器画面，确认对端可见。
4. **口到耳与画面延迟**：在替身摄像头前放毫秒计时器，对端录屏比对时间差；口到耳延迟用拍手 + 双端录音比对，各取 ≥ 30 样本。
5. **弱网**：限速到上行 2 Mbps、1 Mbps，记录分辨率、卡顿、断线情况。
6. **虚拟形象**：用通话音频驱动 Audio2Face 生成口型，叠加头部姿态（可用手机 IMU 模拟），渲染结果输出为虚拟摄像头；在每个通话软件里选用，测端到端延迟和对端主观自然度。
7. **长时**：选一个软件连续通话 30 分钟，记录 PC 资源占用和是否中断。

### 5.5 测量指标与方法

| 指标 | 方法 |
| --- | --- |
| 通过率 | 每个软件 × 每种接入方式：能选中设备、能正常通话 5 分钟视为通过 |
| 画面延迟、口到耳延迟 | 计时器 / 拍手比对，p50 / p95 |
| 弱网表现 | 分辨率、卡顿次数、恢复时间 |
| 虚拟形象 | 口型与语音的时间差（录屏逐帧比对）；对端 5 分制主观自然度（≥ 3 人） |

### 5.6 通过标准

| 项目 | 标准 | 依据 |
| --- | --- | --- |
| V1 兼容 | 列出的主流通话软件都能识别虚拟摄像头与麦克风并正常通话；个别软件限制虚拟设备的，记录为已知边界 | 方案第 3.7 节【设计目标，非已验证结论】 |
| 上行画质 | 1080p30 起，弱网能自动降到 720p / 480p 保持通话 | 方案第 3.7 节 |
| 通话网络 | 上下行各 ≥ 5 Mbps 时稳定 1080p30 | 方案第 6.3 节 |
| 延迟阈值 | 待定，首轮测基线（并测一组普通手机视频通话作对照）后确定 | 方案第 3.7 节写明需结合实测基线 |
| 虚拟形象自然度 | 待定，首轮主观评分后确定 | — |

### 5.7 数据记录表

| 软件 | 主机系统 | 接入方式 | 识别摄像头 | 识别麦克风 | 5 分钟通话 | 画面延迟 p50 / p95 (ms) | 口到耳 p50 / p95 (ms) | 弱网表现 | 备注 |
| --- | --- | --- | --- | --- | --- | --- | --- | --- | --- |
| 微信（PC） | Windows | 有线 UVC | | | | | | | |
| 微信（PC） | Windows | 无线虚拟摄像头 | | | | | | | |
| 腾讯会议 | Windows | 有线 UVC | | | | | | | |
| Teams | Windows | 有线 UVC | | | | | | | |
| Zoom | Windows | 有线 UVC | | | | | | | |
| …（Mac、手机各补一轮） | | | | | | | | | |

| 虚拟形象轮次 | 软件 | 口型延迟 (ms) | 端到端延迟 (ms) | 自然度评分（人 1 / 2 / 3） | GPU 占用 | 备注 |
| --- | --- | --- | --- | --- | --- | --- |
| | | | | | | |

### 5.8 风险与替代

- 部分软件或系统版本可能屏蔽虚拟摄像头：记录具体版本，替代做法是 V2 眼镜独立通话（WebRTC）或 V3 云端通话。
- 手机端通话软件通常不能选外接虚拟摄像头：手机主机场景主要靠 V2 / V3，本组只记录现状。
- Audio2Face 依赖 NVIDIA 显卡，许可条款未核实：核实前只做内部技术验证，不对外分发生成内容。

---

## 第 6 组：佩戴无感基线（人体工学）

### 6.1 目的与对应方案章节

方案已定“续航优先，重量分配好，让人尽量无感”，整机可能约 115–130 g（方案第 7.2 节）。本组用现成主流眼镜建立“鼻梁受力”和“主观舒适度”基线，并用配重样架验证“重量后移到耳后”能否在更重的情况下保持无感。光波导前框光学部分更轻，但重量估算的数字不变，最终以 M2 实测为准。对应方案第 7.2、7.3 节。

### 6.2 设备清单

| 类别 | 建议型号或规格 | 数量 | 备注 |
| --- | --- | --- | --- |
| 对标眼镜 | Ray-Ban Meta（Gen 2）、Meta Ray-Ban Display、XREAL One（或 One Pro）[S35](sources.md#s35)[S36](sources.md#s36)[S37](sources.md#s37) | 各 1 | 已有设备优先，没有的待询价 |
| 头模 | 标准成人头模，鼻梁和耳部支点位置可测 | 1 | 可 3D 打印 |
| 测力传感器 | 小量程薄膜压力传感器或称重传感器，分别放在鼻托与两耳支点下 | 3–4 | 量程按 0–200 g 力选 |
| 配重样架 | 3D 打印或改装镜框，前框与镜腿耳后段可加减配重块（每块 2–5 g） | 2–3 | 模拟 85 g、110 g、130 g 三档 |
| 电子秤 | 0.1 g 精度 | 1 | |
| 表面温度计 / 热像仪 | — | 1 | 可选，配合第 4 组发热观察 |

### 6.3 测试环境与前置条件

- 头模固定，眼镜佩戴位置用标记点统一。
- 主观测试至少 5 人，覆盖不同头型和是否戴近视眼镜；每人测试前说明可随时停止。

### 6.4 测试步骤

1. **称重**：每副对标眼镜与配重样架称重，记录前框、左右镜腿分段重量（可拆或用重心法估算）。
2. **头模受力**：在头模上测鼻托受力与左右耳支点受力，每副重复 5 次取平均。
3. **配重分布对照**：同一样架分别做“前重”（配重放前框）和“后重”（配重放耳后段）两种分布，在 85 g、110 g、130 g 三档下测鼻托受力。
4. **动态**：低头 30°、抬头、快走 2 分钟，观察是否下滑，测下滑距离。
5. **主观佩戴**：每人依次连续佩戴对标眼镜与“后重”样架各 2 小时（可分天），每 30 分钟用 5 分制记录舒适度、鼻梁压感、耳后压感；结束后记录压痕。
6. **对照结论**：比较“后重 110 g”与“后重 130 g”样架和对标产品的鼻托受力和主观评分。本组只验证“重量后移”的假设；光波导实物前框的鼻托受力在 M2 用实物测。

### 6.5 测量指标与方法

| 指标 | 方法 |
| --- | --- |
| 鼻托受力（g 力） | 头模传感器读数，5 次平均 |
| 前后重量比 | 分段称重或重心测量 |
| 左右重量差（g） | 两侧镜腿分别称重 |
| 下滑距离（mm） | 标记点前后位置差 |
| 主观评分 | 5 分制，每 30 分钟一次，取均值与最低值 |

### 6.6 通过标准

| 项目 | 标准 | 依据 |
| --- | --- | --- |
| 鼻托受力 | “后重”样架在目标重量下的鼻托受力 ≤ 对标产品实测值 | 方案第 7.3 节【设计目标，非已验证结论】 |
| 左右对称 | 两侧镜腿重量差 ≤ 3 g | 方案第 7.3 节 |
| 主观舒适 | 2 小时主观评分不低于对标产品；无明显鼻梁压痕、耳后疼痛 | 方案第 7.3 节 |
| 前后重量比 | 目标接近 1:1，最终值待首轮测量后确定 | 方案第 7.3 节 |

### 6.7 数据记录表

| 样品 | 总重 (g) | 前框 (g) | 左镜腿 (g) | 右镜腿 (g) | 鼻托受力 (g 力) | 左耳 (g 力) | 右耳 (g 力) | 下滑 (mm) | 备注 |
| --- | --- | --- | --- | --- | --- | --- | --- | --- | --- |
| Ray-Ban Meta Gen 2 | | | | | | | | | |
| Meta Ray-Ban Display | | | | | | | | | |
| XREAL One | | | | | | | | | |
| 样架 85 g 前重 | | | | | | | | | |
| 样架 85 g 后重 | | | | | | | | | |
| 样架 110 g 后重 | | | | | | | | | |
| 样架 130 g 后重 | | | | | | | | | |

| 受试者编号 | 样品 | 30 min | 60 min | 90 min | 120 min | 鼻梁压感 | 耳后压感 | 压痕 | 备注 |
| --- | --- | --- | --- | --- | --- | --- | --- | --- | --- |
| P1 | | | | | | | | | |

### 6.8 风险与替代

- 头模测量与真人差异大：以主观测试为最终依据，头模数据用于对比趋势。
- 配重样架没有真实光学和发热：发热舒适度留到结构样机阶段补测。
- 主观测试只记录编号，不记录受试者姓名、照片等个人信息，原始数据不进入公开仓库。

---

## 附录：本计划新增来源（待核验）

其余引用见 [sources.md](sources.md) 的 S1–S37。

- **N1** OBS Studio 代码仓库（含虚拟摄像头功能，用于第 5 组无线虚拟摄像头路径）：<https://github.com/obsproject/obs-studio>

## 分工记录

第 1–3 组初稿由 DeepSeek（dsh-run，DeepSeek-V4.1-Flash-1017）撰写，总框架、第 4–6 组及审核合并由 Claude（claude-opus-5-5）完成。
