jodancain/independent-cellular-ai-glasses/hardware/v0.1/exports/main_board/main_board-schematic.pdf

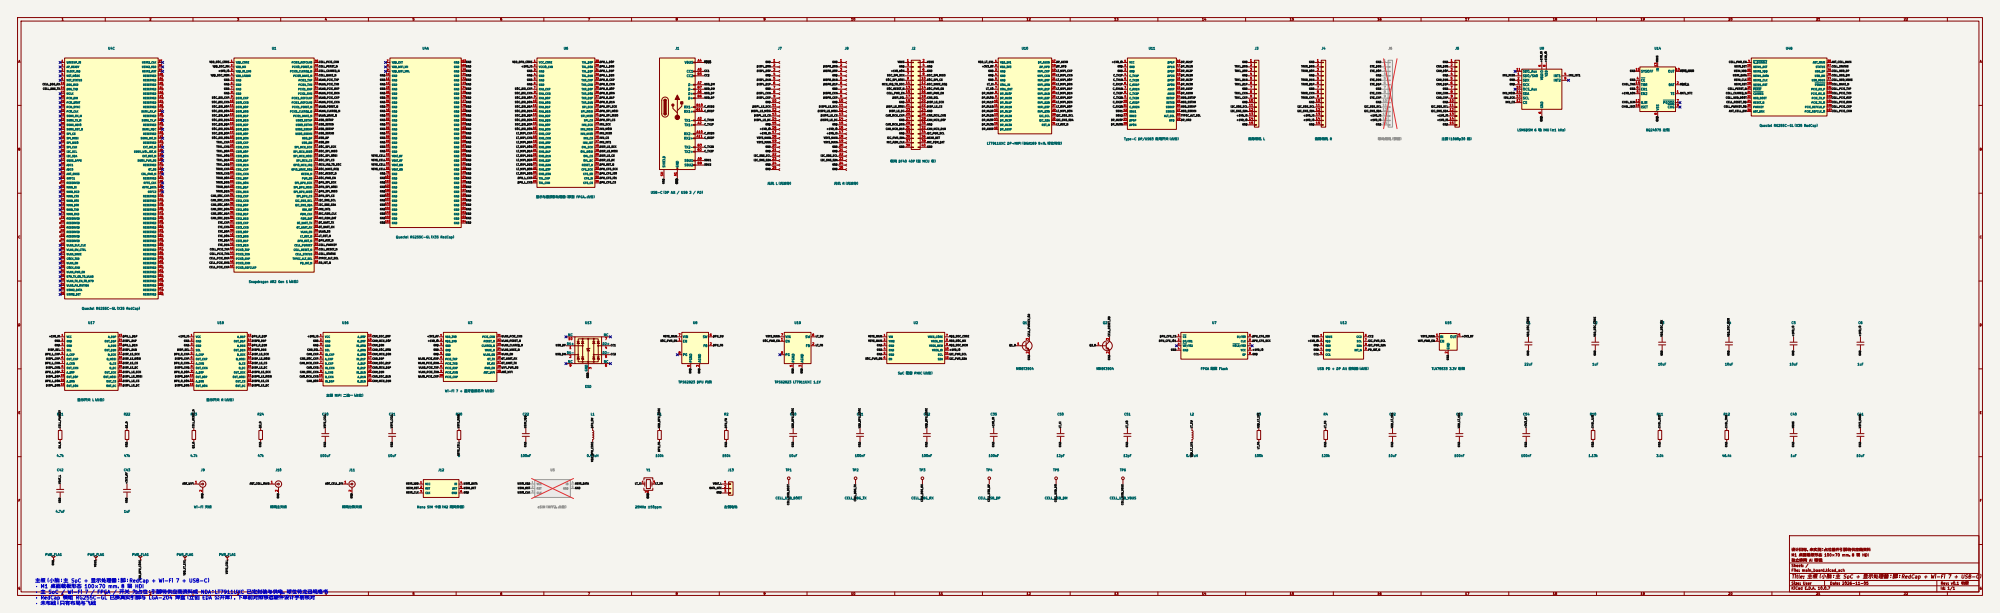
[picture p4: page 1]

J1 USB-C（DP Alt / USB 3 / PD）

SPI_CS 41
SPI_MOSI 42
SPI_MISO 43
SPI_CLK 44
I2C_SCL 45
SGMII_PWR_EN 130 RESERVED 131 BT_EN 132 CBL_PWR_N 133 RESERVED 134 RFFE_CLK 136 RFFE_DATA 138 GRFC2 139 RESERVED 142 RESERVED 144 RESERVED 145 RESERVED 146 RESERVED 147 RESERVED 148 RESERVED 150 RESERVED 152 RESERVED 153 RESERVED 154 RESERVED 155 RESERVED 156 RESERVED 157 RESERVED 158 RESERVED 159 RESERVED 160 RESERVED 161 RESERVED 162 RESERVED 164 RESERVED 165 RESERVED 166 RESERVED 167 RESERVED 168

Type-C DP/USB3 复用开关（占位）

DPU_RST_N 主板（小脑：主 SoC + 显示处理器；脚：RedCap + Wi-Fi 7 + USB-C）

9 U12 USB PD + DP Alt 控制器（占位）

SoC 配套 PMIC（占位）
TP2 CELL_DBG_TX C31

设计目标，未实测；占位器件引脚待供应商资料
M1 桌面载板形态 100×70 mm，8 层 HDI
独立蜂窝 AI 眼镜
Sheet: /
File: main_board.kicad_sch
Title: 主板（小脑：主 SoC + 显示处理器；脚：RedCap + Wi-Fi 7 + USB-C）

Size: User | Rev: v0.1 初版
KiCad E.D.A. 10.0.7 | Id: 1/1

· M1 桌面载板形态 100×70 mm，8 层 HDI · 主 SoC / Wi-Fi 7 / FPGA / 开关 为占位：引脚待供应商资料或 NDA；LT7911UXC 已定封装与供电，球位待龙迅规格书

· RedCap 模组 RG255C-GL 已换真实引脚与 LGA-204 焊盘（立创 EDA 公开库），下单前对照移远硬件设计手册核对
· 未布线：只有布局与飞线
