jodancain/independent-cellular-ai-glasses/hardware/v0.1/exports/mcu_board/mcu_board-schematic.pdf

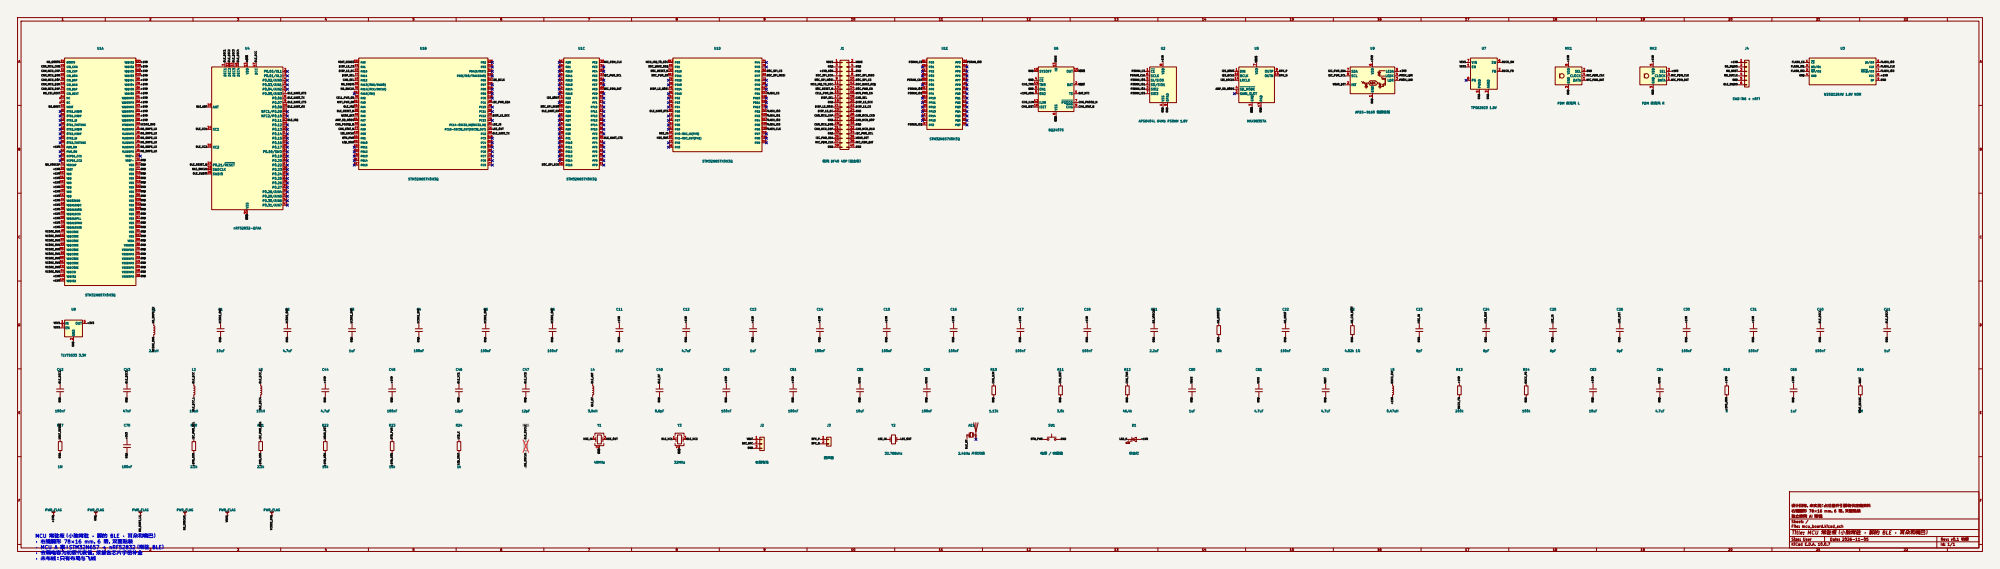
[picture p5: page 1]

GND MCU 常驻板（小脑常驻 · 脚的 BLE · 耳朵和嘴巴）

设计目标，未实测；占位器件引脚待供应商资料
右镜腿形 78×16 mm，6 层，双面贴装
独立蜂窝 AI 眼镜
Sheet: /
File: mcu_board.kicad_sch
Title: MCU 常驻板（小脑常驻 · 脚的 BLE · 耳朵和嘴巴）

Size: User | Rev: v0.1 初版
KiCad E.D.A. 10.0.7 | Id: 1/1
