jodancain/independent-cellular-ai-glasses/hardware/v0.1/kicad/main_board/main_board.kicad_pcb

## KiCad design hardware/v0.1/kicad/main_board/main_board.kicad_pcb (2026-11-09)

Schematic: main_board.kicad_sch, 主板（小脑：主 SoC + 显示处理器；脚：RedCap + Wi-Fi 7 + USB-C）

Parts:
C1: 22uF; C_0402_1005Metric
C2, C6, C40: 1uF; C_0402_1005Metric
C3, C4, C5, C21, C30, C41, C52: 10uF; C_0402_1005Metric
C20: 100uF; C_0603_1608Metric
C22, C31, C32, C35, C53, C54: 100nF; C_0201_0603Metric
C42: 4.7uF; C_0402_1005Metric
C43: 1uF; C_0201_0603Metric
C50, C51: 12pF; C_0201_0603Metric
J1: USB-C（DP Alt / USB 3 / PD）; USB_C_Receptacle_Amphenol_12401610E4-2A
J2: 板间 DF40 40P（至 MCU 板）; Hirose_DF40C-40DS-0.4V_2x20_P0.4mm
J3: 追踪相机 L; Hirose_FH26-15S-0.3SHW_2Rows-15Pins-1MP_P0.60mm_Horizontal
J4: 追踪相机 R; Hirose_FH26-15S-0.3SHW_2Rows-15Pins-1MP_P0.60mm_Horizontal
J5: 主摄（1080p30 起）; Hirose_FH26-15S-0.3SHW_2Rows-15Pins-1MP_P0.60mm_Horizontal
J6: 眼动相机（预留）; Hirose_FH26-15S-0.3SHW_2Rows-15Pins-1MP_P0.60mm_Horizontal; not fitted
J7: 光机 L（光波导）; Hirose_FH26-25S-0.3SHW_2Rows-25Pins-1MP_P0.60mm_Horizontal
J8: 光机 R（光波导）; Hirose_FH26-25S-0.3SHW_2Rows-25Pins-1MP_P0.60mm_Horizontal
J9: Wi-Fi 天线; U.FL_Hirose_U.FL-R-SMT-1_Vertical
J10: 蜂窝主天线; U.FL_Hirose_U.FL-R-SMT-1_Vertical
J11: 蜂窝分集天线; U.FL_Hirose_U.FL-R-SMT-1_Vertical
J12: Nano SIM 卡座（M2 期间保留）; PH_NANO_SIM_HOLDER
J13: 左侧电池; JST_SH_SM03B-SRSS-TB_1x03-1MP_P1.00mm_Horizontal
L1, L2: 0.47uH; L_0805_2012Metric
Q1, Q2: MMBT3904; SOT-23
R1, R3: 100k; R_0201_0603Metric
R2: 150k; R_0201_0603Metric
R4: 120k; R_0201_0603Metric
R10: 1.13k; R_0201_0603Metric
R11: 3.0k; R_0201_0603Metric
R12: 46.4k; R_0201_0603Metric
R20: 0; R_0603_1608Metric
R21, R23: 4.7k; R_0201_0603Metric
R22, R24: 47k; R_0201_0603Metric
TP1: CELL_USB_BOOT; TestPoint_Pad_D1.0mm
TP2: CELL_DBG_TX; TestPoint_Pad_D1.0mm
TP3: CELL_DBG_RX; TestPoint_Pad_D1.0mm
TP4: CELL_USB_DP; TestPoint_Pad_D1.0mm
TP5: CELL_USB_DM; TestPoint_Pad_D1.0mm
TP6: CELL_USB_VBUS; TestPoint_Pad_D1.0mm
U1: Snapdragon AR2 Gen 1（占位）; PH_SOC_AR2_GEN1_PLACEHOLDER
U2: SoC 配套 PMIC（占位）; PH_PMIC_SOC_PLACEHOLDER
U3: Wi-Fi 7 + 蓝牙连接芯片（占位）; PH_WIFI7_COMBO_PLACEHOLDER
U4: Quectel RG255C-GL（X35 RedCap）; Quectel_RG255C-GL_LGA-204_32x29mm
U5: eSIM（MFF2，占位）; PH_ESIM_MFF2; not fitted
U6: 显示与重投影处理器（原型 FPGA，占位）; PH_DPU_FPGA_PLACEHOLDER
U7: FPGA 配置 Flash; WSON-8-1EP_6x5mm_P1.27mm_EP3.4x4.3mm
U8: TPS62823 DPU 内核; Texas_VSON-HR-8_1.5x2mm_P0.5mm
U9: LSM6DSM 6 轴 IMU（≥1 kHz）; LGA-14_3x2.5mm_P0.5mm_LayoutBorder3x4y
U10: LT7911UXC DP→MIPI（BGA169 9×9，球位待定）; PH_LT7911UXC_BGA169_PLACEHOLDER
U11: Type-C DP/USB3 复用开关（占位）; PH_TYPEC_DP_USB_MUX_PLACEHOLDER
U12: USB PD + DP Alt 控制器（占位）; PH_PD_CONTROLLER_PLACEHOLDER
U13: ESD; USON-10_2.5x1.0mm_P0.5mm
U14: BQ24075 左侧; VQFN-16-1EP_3x3mm_P0.5mm_EP1.6x1.6mm
U15: TLV75533 3.3V 射频; SOT-23-5
U16: 主摄 MIPI 二选一（占位）; PH_MIPI_SWITCH_CAM_PLACEHOLDER
U17: 显示开关 L（占位）; PH_DISP_SWITCH_L_PLACEHOLDER
U18: 显示开关 R（占位）; PH_DISP_SWITCH_R_PLACEHOLDER
U19: TPS62823 LT7911UXC 1.1V; Texas_VSON-HR-8_1.5x2mm_P0.5mm
Y1: 25MHz ±50ppm; Crystal_SMD_2016-4Pin_2.0x1.6mm

Connections:
+1V8_AON: J2.5, U14.5 (EN2)
+1V8_IO: C5.1, C6.1, C35.1, J3.13, J3.14, J4.13, J4.14, J5.13, J5.14, J6.13, J6.14, J7.16, J7.17, J8.16, J8.17, U1.3 (VDD_IO_1V8), U2.10 (VREG_IO), U3.2 (VDD_1V8), U6.2 (VCCIO_1V8), U7.8 (VCC), U9.5 (VDDIO), U9.8 (VDD), U11.1 (VCC), U12.2 (VDD), U16.1 (VCC), U17.1 (VCC), U18.1 (VCC)
+3V3_RF: C43.1, C54.1, U3.1 (VDD_3V3), U10.2 (VDD_3V3), U15.5 (OUT)
ANT_CELL_DIV: J11.1 (In), U4.39 (ANT_DRX)
ANT_CELL_MAIN: J10.1 (In), U4.55 (ANT_MAIN)
ANT_WIFI: J9.1 (In), U3.19 (ANT_WIFI)
BATL_NTC: J13.2, U14.1 (TS)
BT_UART_RX: U1.85 (BT_UART_RX), U3.16 (BT_TX)
BT_UART_TX: U1.84 (BT_UART_TX), U3.17 (BT_RX)
CAM_CKN: J5.8, U16.8 (IN_CKN)
CAM_CKP: J5.9, U16.5 (IN_CKP)
CAM_D0N: J5.2, U16.14 (IN_D0N)
CAM_D0P: J5.3, U16.11 (IN_D0P)
CAM_D1N: J5.5, U16.20 (IN_D1N)
CAM_D1P: J5.6, U16.17 (IN_D1P)
CAM_MCU_CKN: J2.26, U16.10 (B_CKN)
CAM_MCU_CKP: J2.25, U16.7 (B_CKP)
CAM_MCU_D0N: J2.29, U16.16 (B_D0N)
CAM_MCU_D0P: J2.28, U16.13 (B_D0P)
CAM_MCU_D1N: J2.32, U16.22 (B_D1N)
CAM_MCU_D1P: J2.31, U16.19 (B_D1P)
CAM_SEL: J2.18, U16.4 (SEL)
CAM_SOC_CKN: U1.32 (CSI2_CKN), U16.9 (A_CKN)
CAM_SOC_CKP: U1.31 (CSI2_CKP), U16.6 (A_CKP)
CAM_SOC_D0N: U1.34 (CSI2_D0N), U16.15 (A_D0N)
CAM_SOC_D0P: U1.33 (CSI2_D0P), U16.12 (A_D0P)
CAM_SOC_D1N: U1.36 (CSI2_D1N), U16.21 (A_D1N)
CAM_SOC_D1P: U1.35 (CSI2_D1P), U16.18 (A_D1P)
CC1: J1.A5 (CC1), U12.5 (CC1), U13.4 (D2+)
CC2: J1.B5 (CC2), U12.6 (CC2), U13.5 (D2-)
CELL_CLKREQ_N: U1.50 (PCIE0_CLKREQ_N), U4.21 (~CLKREQ)
CELL_DBG_RX: TP3.1, U4.13 (DBG_RXD)
CELL_DBG_TX: TP2.1, U4.14 (DBG_TXD)
CELL_PCIE_CKN: U1.48 (PCIE0_REFCLKN), U4.107 (PCIE_REFCLK_M)
CELL_PCIE_CKP: U1.47 (PCIE0_REFCLKP), U4.105 (PCIE_REFCLK_P)
CELL_PCIE_RXN: U1.46 (PCIE0_RXN), U4.104 (PCIE_TX_M)
CELL_PCIE_RXP: U1.45 (PCIE0_RXP), U4.103 (PCIE_TX_P)
CELL_PCIE_TXN: U1.44 (PCIE0_TXN), U4.102 (PCIE_RX_M)
CELL_PCIE_TXP: U1.43 (PCIE0_TXP), U4.101 (PCIE_RX_P)
CELL_PERST_N: U1.49 (PCIE0_PERST_N), U4.20 (~PERST)
CELL_PWRKEY: R21.1, U1.89 (CELL_PWRKEY)
CELL_PWRKEY_OD: Q1.3 (C), U4.25 (PWRKEY)
CELL_PWR_EN: J2.15, U4.4 (~W_DISABLE)
CELL_RESET_N: R23.1, U1.90 (CELL_RESET_N)
CELL_RESET_OD: Q2.3 (C), U4.24 (RESET_N)
CELL_STATUS: U1.91 (CELL_STATUS), U4.67 (STATUS)
CELL_USB_BOOT: TP1.1, U4.22 (USB_BOOT)
CELL_USB_DM: TP5.1, U4.76 (USB_DM)
CELL_USB_DP: TP4.1, U4.75 (USB_DP)
CELL_USB_VBUS: TP6.1, U4.77 (USB_VBUS)
CELL_WAKE_N: U1.51 (PCIE0_WAKE_N), U4.100 (~PEWAKE)
CHGL_ILIM: R10.1, U14.12 (ILIM)
CHGL_ISET: R11.1, U14.16 (ISET)
CHGL_TMR: R12.1, U14.14 (TMR)
C_RX1N: J1.B10 (RX1-), U11.7 (C_RX1N)
C_RX1P: J1.B11 (RX1+), U11.6 (C_RX1P)
C_RX2N: J1.A10 (RX2-), U11.11 (C_RX2N)
C_RX2P: J1.A11 (RX2+), U11.10 (C_RX2P)
C_TX1N: J1.A3 (TX1-), U11.5 (C_TX1N)
C_TX1P: J1.A2 (TX1+), U11.4 (C_TX1P)
C_TX2N: J1.B3 (TX2-), U11.9 (C_TX2N)
C_TX2P: J1.B2 (TX2+), U11.8 (C_TX2P)
DISPL_CKN: J7.8, U17.8 (OUT_CKN)
DISPL_CKP: J7.9, U17.6 (OUT_CKP)
DISPL_D0N: J7.2, U17.12 (OUT_D0N)
DISPL_D0P: J7.3, U17.10 (OUT_D0P)
DISPL_D1N: J7.5, U17.16 (OUT_D1N)
DISPL_D1P: J7.6, U17.14 (OUT_D1P)
DISPL_LS_CS: J7.13, U17.23 (OUT_CS)
DISPL_LS_DC: J7.14, U17.24 (OUT_DC)
DISPL_LS_MOSI: J7.12, U17.22 (OUT_MOSI)
DISPL_LS_SCK: J7.11, U17.21 (OUT_SCK)
DISPR_CKN: J8.8, U18.8 (OUT_CKN)
DISPR_CKP: J8.9, U18.6 (OUT_CKP)
DISPR_D0N: J8.2, U18.12 (OUT_D0N)
DISPR_D0P: J8.3, U18.10 (OUT_D0P)
DISPR_D1N: J8.5, U18.16 (OUT_D1N)
DISPR_D1P: J8.6, U18.14 (OUT_D1P)
DISPR_LS_CS: J8.13, U18.23 (OUT_CS)
DISPR_LS_DC: J8.14, U18.24 (OUT_DC)
DISPR_LS_MOSI: J8.12, U18.22 (OUT_MOSI)
DISPR_LS_SCK: J8.11, U18.21 (OUT_SCK)
DISP_LS_CS: J2.22, U6.50 (OVL_CS), U17.19 (B_CS), U18.19 (B_CS)
DISP_LS_DC: J2.23, U6.51 (OVL_DC), U17.20 (B_DC), U18.20 (B_DC)
DISP_LS_MOSI: J2.21, U6.49 (OVL_MOSI), U17.18 (B_MOSI), U18.18 (B_MOSI)
DISP_LS_SCK: J2.20, U6.48 (OVL_SCK), U17.17 (B_SCK), U18.17 (B_SCK)
DISP_SEL: J2.17, U17.4 (SEL), U18.4 (SEL)
DPU_CFG_CS: U6.56 (CFG_CS), U7.1 (~CS)
DPU_CFG_IO0: U6.54 (CFG_SO), U7.5 (DI/IO0)
DPU_CFG_IO1: U6.55 (CFG_SI), U7.2 (DO/IO1)
DPU_CFG_SCK: U6.53 (CFG_SCK), U7.6 (CLK)
DPU_FB: R1.2, R2.1, U8.2 (FB)
DPU_L_CKN: U6.28 (TXL_CKN), U17.7 (A_CKN)
DPU_L_CKP: U6.27 (TXL_CKP), U17.5 (A_CKP)
DPU_L_D0N: U6.30 (TXL_D0N), U17.11 (A_D0N)
DPU_L_D0P: U6.29 (TXL_D0P), U17.9 (A_D0P)
DPU_L_D1N: U6.32 (TXL_D1N), U17.15 (A_D1N)
DPU_L_D1P: U6.31 (TXL_D1P), U17.13 (A_D1P)
DPU_RST_N: U1.88 (DPU_RST_N), U6.52 (RESET_N)
DPU_R_CKN: U6.34 (TXR_CKN), U18.7 (A_CKN)
DPU_R_CKP: U6.33 (TXR_CKP), U18.5 (A_CKP)
DPU_R_D0N: U6.36 (TXR_D0N), U18.11 (A_D0N)
DPU_R_D0P: U6.35 (TXR_D0P), U18.9 (A_D0P)
DPU_R_D1N: U6.38 (TXR_D1N), U18.15 (A_D1N)
DPU_R_D1P: U6.37 (TXR_D1P), U18.13 (A_D1P)
DPU_SPI_CS: U1.78 (SPI_DPU_CS), U6.42 (SPI_CS)
DPU_SPI_MISO: U1.77 (SPI_DPU_MISO), U6.41 (SPI_MISO)
DPU_SPI_MOSI: U1.76 (SPI_DPU_MOSI), U6.40 (SPI_MOSI)
DPU_SPI_SCK: U1.75 (SPI_DPU_SCK), U6.39 (SPI_SCK)
DPU_SW: L1.1, U8.6 (SW)
DP_AUXN: U10.17 (DP_AUXN), U11.23 (AUXN)
DP_AUXP: U10.16 (DP_AUXP), U11.22 (AUXP)
DP_HPD: U10.18 (DP_HPD), U11.29 (HPD)
DP_ML0N: U10.9 (DP_ML0N), U11.15 (DP0N)
DP_ML0P: U10.8 (DP_ML0P), U11.14 (DP0P)
DP_ML1N: U10.11 (DP_ML1N), U11.17 (DP1N)
DP_ML1P: U10.10 (DP_ML1P), U11.16 (DP1P)
DP_ML2N: U10.13 (DP_ML2N), U11.19 (DP2N)
DP_ML2P: U10.12 (DP_ML2P), U11.18 (DP2P)
DP_ML3N: U10.15 (DP_ML3N), U11.21 (DP3N)
DP_ML3P: U10.14 (DP_ML3P), U11.20 (DP3P)
EYE_CKN: J6.8, U1.38 (CSI3_CKN)
EYE_CKP: J6.9, U1.37 (CSI3_CKP)
EYE_D0N: J6.2, U1.40 (CSI3_D0N)
EYE_D0P: J6.3, U1.39 (CSI3_D0P)
EYE_D1N: J6.5, U1.42 (CSI3_D1N)
EYE_D1P: J6.6, U1.41 (CSI3_D1P)
GND: C1.2, C2.2, C3.2, C4.2, C5.2, C6.2, C20.2, C21.2, C22.2, C30.2, C31.2, C32.2, C35.2, C40.2, C41.2, C42.2, C43.2, C50.2, C51.2, C52.2, C53.2, C54.2, J1.A1 (GND), J1.A12 (GND), J1.B1 (GND), J1.B12 (GND), J1.SH (SHIELD), J2.3, J2.4, J2.6, J2.19, J2.24, J2.27, J2.30, J2.33, J2.39, J2.40, J3.1, J3.4, J3.7, J3.10, J3.15, J4.1, J4.4, J4.7, J4.10, J4.15, J5.1, J5.4, J5.7, J5.10, J5.15, J6.1, J6.4, J6.7, J6.10, J6.15, J7.1, J7.4, J7.7, J7.10, J7.15, J7.20, J7.21, J7.24, J7.25, J8.1, J8.4, J8.7, J8.10, J8.15, J8.20, J8.21, J8.24, J8.25, J9.2 (Ext), J10.2 (Ext), J11.2 (Ext), J12.6 (GND), J13.3, Q1.2 (E), Q2.2 (E), R2.2, R4.2, R10.2, R11.2, R12.2, R22.2, R24.2, U1.5 (GND), U1.6 (GND), U1.7 (GND), U1.8 (GND), U2.3 (GND), U2.4 (GND), U2.5 (GND), U3.3 (GND), U3.4 (GND), U3.5 (GND), U4.10 (GND), U4.11 (GND), U4.12 (GND), U4.23 (GND), U4.26 (GND), U4.33 (GND), U4.35 (GND), U4.38 (GND), U4.40 (GND), U4.50 (GND), U4.52 (GND), U4.54 (GND), U4.56 (GND), U4.57 (GND), U4.58 (GND), U4.59 (GND), U4.60 (GND), U4.62 (GND), U4.78 (GND), U4.109 (GND), U4.115 (GND), U4.125 (GND), U4.126 (GND), U4.135 (GND), U4.137 (GND), U4.140 (GND), U4.141 (GND), U4.143 (GND), U4.149 (GND), U4.151 (GND), U4.163 (GND), U4.169 (GND), U4.170 (GND), U4.171 (GND), U4.172 (GND), U4.173 (GND), U4.174 (GND), U4.175 (GND), U4.176 (GND), U4.177 (GND), U4.178 (GND), U4.179 (GND), U4.180 (GND), U4.181 (GND), U4.182 (GND), U4.183 (GND), U4.184 (GND), U4.185 (GND), U4.186 (GND), U4.187 (GND), U4.188 (GND), U4.189 (GND), U4.190 (GND), U4.191 (GND), U4.192 (GND), U4.193 (GND), U4.194 (GND), U4.195 (GND), U4.196 (GND), U4.197 (GND), U4.198 (GND), U4.199 (GND), U4.200 (GND), U4.201 (GND), U4.202 (GND), U4.203 (GND), U4.204 (GND), U5.5 (GND), U6.3 (GND), U6.4 (GND), U6.5 (GND), U6.6 (GND), U7.4 (GND), U7.9 (EP), U8.3 (AGND), U8.5 (PGND), U9.2 (SDX), U9.3 (SCX), U9.6 (GND), U9.7 (GND), U10.3 (GND), U10.4 (GND), U10.5 (GND), U11.2 (GND), U11.3 (GND), U12.3 (GND), U12.4 (GND), U13.3 (GND), U13.8 (GND), U14.4 (~CE), U14.6 (EN1), U14.8 (VSS), U14.15 (SYSOFF), U14.17 (VSS), U15.2 (GND), U16.2 (GND), U16.3 (GND), U17.2 (GND), U17.3 (GND), U18.2 (GND), U18.3 (GND), U19.3 (AGND), U19.5 (PGND), Y1.2 (G), Y1.4 (G)
I2C_PWR_SCL: J2.34, U2.11 (SCL), U12.7 (SCL)
I2C_PWR_SDA: J2.35, U2.12 (SDA), U12.8 (SDA)
I2C_SNS_SCL: J3.11, J4.11, J5.11, J6.11, J7.22, J8.22, U1.79 (I2C_SNS_SCL), U10.29 (I2C_SCL)
I2C_SNS_SDA: J3.12, J4.12, J5.12, J6.12, J7.23, J8.23, U1.80 (I2C_SNS_SDA), U10.30 (I2C_SDA)
IMU_CS: U6.46 (IMU_CS), U9.12 (CS)
IMU_INT1: U1.81 (IMU_INT), U6.47 (IMU_INT), U9.4 (INT1)
IMU_MISO: U6.45 (IMU_MISO), U9.1 (SDO/SA0)
IMU_MOSI: U6.44 (IMU_MOSI), U9.14 (SDA)
IMU_SCK: U6.43 (IMU_SCK), U9.13 (SCL)
LT_FB: R3.2, R4.1, U19.2 (FB)
LT_MIPI_CKN: U6.18 (RXB_CKN), U10.20 (MIPI_CKN)
LT_MIPI_CKP: U6.17 (RXB_CKP), U10.19 (MIPI_CKP)
LT_MIPI_D0N: U6.20 (RXB_D0N), U10.22 (MIPI_D0N)
LT_MIPI_D0P: U6.19 (RXB_D0P), U10.21 (MIPI_D0P)
LT_MIPI_D1N: U6.22 (RXB_D1N), U10.24 (MIPI_D1N)
LT_MIPI_D1P: U6.21 (RXB_D1P), U10.23 (MIPI_D1P)
LT_MIPI_D2N: U6.24 (RXB_D2N), U10.26 (MIPI_D2N)
LT_MIPI_D2P: U6.23 (RXB_D2P), U10.25 (MIPI_D2P)
LT_MIPI_D3N: U6.26 (RXB_D3N), U10.28 (MIPI_D3N)
LT_MIPI_D3P: U6.25 (RXB_D3P), U10.27 (MIPI_D3P)
LT_RST_N: U1.87 (LT_RST_N), U10.31 (RST_N)
LT_SW: L2.1, U19.6 (SW)
LT_XI: C50.1, U10.6 (XTAL_IN), Y1.1
LT_XO: C51.1, U10.7 (XTAL_OUT), Y1.3
MCU_IRQ_TO_SOC: J2.11, U1.71 (GPIO_MCU_IRQ)
MIC_PDM_CLK: J2.37, U1.82 (PDM_CLK)
MIC_PDM_DAT: J2.38, U1.83 (PDM_DAT)
PD_INT_N: U1.93 (PD_INT_N), U12.9 (INT_N)
Q1_B: Q1.1 (B), R21.2, R22.1
Q2_B: Q2.1 (B), R23.2, R24.1
SBU1: J1.A8 (SBU1), U11.12 (SBU1)
SBU2: J1.B8 (SBU2), U11.13 (SBU2)
SOC_DSI_CKN: U1.10 (DSI0_CKN), U6.8 (RXA_CKN)
SOC_DSI_CKP: U1.9 (DSI0_CKP), U6.7 (RXA_CKP)
SOC_DSI_D0N: U1.12 (DSI0_D0N), U6.10 (RXA_D0N)
SOC_DSI_D0P: U1.11 (DSI0_D0P), U6.9 (RXA_D0P)
SOC_DSI_D1N: U1.14 (DSI0_D1N), U6.12 (RXA_D1N)
SOC_DSI_D1P: U1.13 (DSI0_D1P), U6.11 (RXA_D1P)
SOC_DSI_D2N: U1.16 (DSI0_D2N), U6.14 (RXA_D2N)
SOC_DSI_D2P: U1.15 (DSI0_D2P), U6.13 (RXA_D2P)
SOC_DSI_D3N: U1.18 (DSI0_D3N), U6.16 (RXA_D3N)
SOC_DSI_D3P: U1.17 (DSI0_D3P), U6.15 (RXA_D3P)
SOC_PWR_EN: J2.14, U1.74 (PWR_EN), U2.6 (EN), U8.1 (EN), U19.1 (EN)
SOC_RESET_N: J2.13, U1.73 (RESIN_N)
SOC_SPI_CS: J2.10, U1.70 (SPI_MCU_CS)
SOC_SPI_MISO: J2.8, U1.68 (SPI_MCU_MISO)
SOC_SPI_MOSI: J2.9, U1.69 (SPI_MCU_MOSI)
SOC_SPI_SCK: J2.7, U1.67 (SPI_MCU_SCK)
SOC_WAKE_REQ: J2.12, U1.72 (GPIO_WAKE_REQ)
TRKL_CKN: J3.8, U1.20 (CSI0_CKN)
TRKL_CKP: J3.9, U1.19 (CSI0_CKP)
TRKL_D0N: J3.2, U1.22 (CSI0_D0N)
TRKL_D0P: J3.3, U1.21 (CSI0_D0P)
TRKL_D1N: J3.5, U1.24 (CSI0_D1N)
TRKL_D1P: J3.6, U1.23 (CSI0_D1P)
TRKR_CKN: J4.8, U1.26 (CSI1_CKN)
TRKR_CKP: J4.9, U1.25 (CSI1_CKP)
TRKR_D0N: J4.2, U1.28 (CSI1_D0N)
TRKR_D0P: J4.3, U1.27 (CSI1_D0P)
TRKR_D1N: J4.5, U1.30 (CSI1_D1N)
TRKR_D1P: J4.6, U1.29 (CSI1_D1P)
TYPEC_ALT_SEL: U1.92 (TYPEC_ALT_SEL), U11.28 (ALT_SEL)
USB_DM: J1.A7 (D-), J1.B7 (D-), U1.66 (USB_DM), U13.2 (D1-)
USB_DP: J1.A6 (D+), J1.B6 (D+), U1.65 (USB_DP), U13.1 (D1+)
USB_SSRXN: U1.64 (USB3_SSRXN), U11.27 (SSRXN)
USB_SSRXP: U1.63 (USB3_SSRXP), U11.26 (SSRXP)
USB_SSTXN: U1.62 (USB3_SSTXN), U11.25 (SSTXN)
USB_SSTXP: U1.61 (USB3_SSTXP), U11.24 (SSTXP)
USIM_CLK: J12.3 (CLK), U4.18 (USIM1_CLK), U5.3 (CLK)
USIM_DATA: J12.4 (IO), U4.17 (USIM1_DATA), U5.4 (IO)
USIM_DET: J12.5 (DET), U4.15 (USIM1_DET)
USIM_RST: J12.2 (RST), U4.19 (USIM1_RST), U5.2 (RST)
USIM_VDD: C22.1, J12.1 (VCC), U4.16 (USIM1_VDD), U5.1 (VCC)
VBAT_L: C42.1, J13.1, U14.2 (BAT), U14.3 (BAT)
VBUS: C40.1, J1.A4 (VBUS), J1.A9 (VBUS), J1.B4 (VBUS), J1.B9 (VBUS), J2.1, J2.2, U12.1 (VBUS), U14.13 (IN)
VDD_DPU_CORE: C30.1, C31.1, C32.1, L1.2, R1.1, U6.1 (VCC_CORE)
VDD_LT_1V1: C52.1, C53.1, L2.2, R3.1, U10.1 (VDD_1V1)
VDD_SOC_CORE: C1.1, C2.1, U1.1 (VDD_CORE), U2.7 (VREG_CORE)
VDD_SOC_MEM: C4.1, U1.4 (VDD_LPDDR), U2.9 (VREG_MEM)
VDD_SOC_MX: C3.1, U1.2 (VDD_MX), U2.8 (VREG_MX)
VSYS_CELL: C20.1, C21.1, R20.2, U4.63 (VBAT_RF), U4.64 (VBAT_RF), U4.65 (VBAT_BB), U4.66 (VBAT_BB)
VSYS_MAIN: C41.1, J7.18, J7.19, J8.18, J8.19, R20.1, U2.1 (VIN), U2.2 (VIN2), U8.7 (VIN), U14.10 (OUT), U14.11 (OUT), U15.1 (IN), U19.7 (VIN)
WEAR_DET: J2.36
WIFI_PWR_EN: J2.16, U3.18 (PWR_EN), U15.3 (EN)
WLAN_CLKREQ_N: U1.59 (PCIE1_CLKREQ_N), U3.13 (CLKREQ_N)
WLAN_EN: U1.86 (WLAN_EN), U3.15 (WLAN_EN)
WLAN_PCIE_CKN: U1.57 (PCIE1_REFCLKN), U3.11 (PCIE_CKN)
WLAN_PCIE_CKP: U1.56 (PCIE1_REFCLKP), U3.10 (PCIE_CKP)
WLAN_PCIE_RXN: U1.55 (PCIE1_RXN), U3.7 (PCIE_TXN)
WLAN_PCIE_RXP: U1.54 (PCIE1_RXP), U3.6 (PCIE_TXP)
WLAN_PCIE_TXN: U1.53 (PCIE1_TXN), U3.9 (PCIE_RXN)
WLAN_PCIE_TXP: U1.52 (PCIE1_TXP), U3.8 (PCIE_RXP)
WLAN_PERST_N: U1.58 (PCIE1_PERST_N), U3.12 (PERST_N)
WLAN_WAKE_N: U1.60 (PCIE1_WAKE_N), U3.14 (WAKE_N)

Notes on the sheet:
主板（小脑：主 SoC + 显示处理器；脚：RedCap + Wi-Fi 7 + USB-C） · M1 桌面载板形态 100×70 mm，8 层 HDI · 主 SoC / Wi-Fi 7 / FPGA / 开关 为占位：引脚待供应商资料或 NDA；LT7911UXC 已定封装与供电，球位待龙迅规格书 · RedCap 模组 RG255C-GL 已换真实引脚与 LGA-204 焊盘（立创 EDA 公开库），下单前对照移远硬件设计手册核对 · 未布线：只有布局与飞线

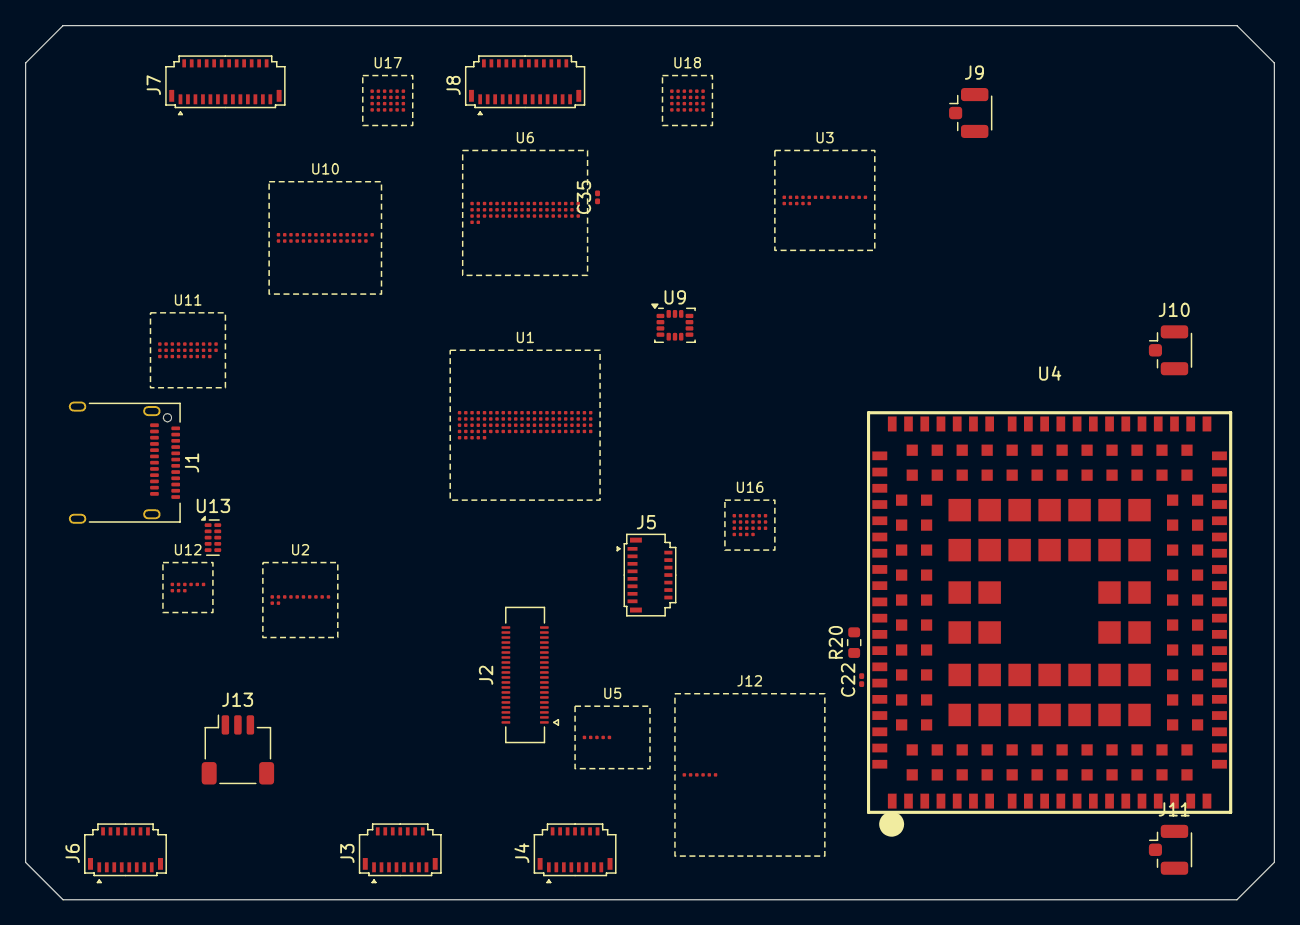
[picture p6: board main_board.kicad_pcb from above]

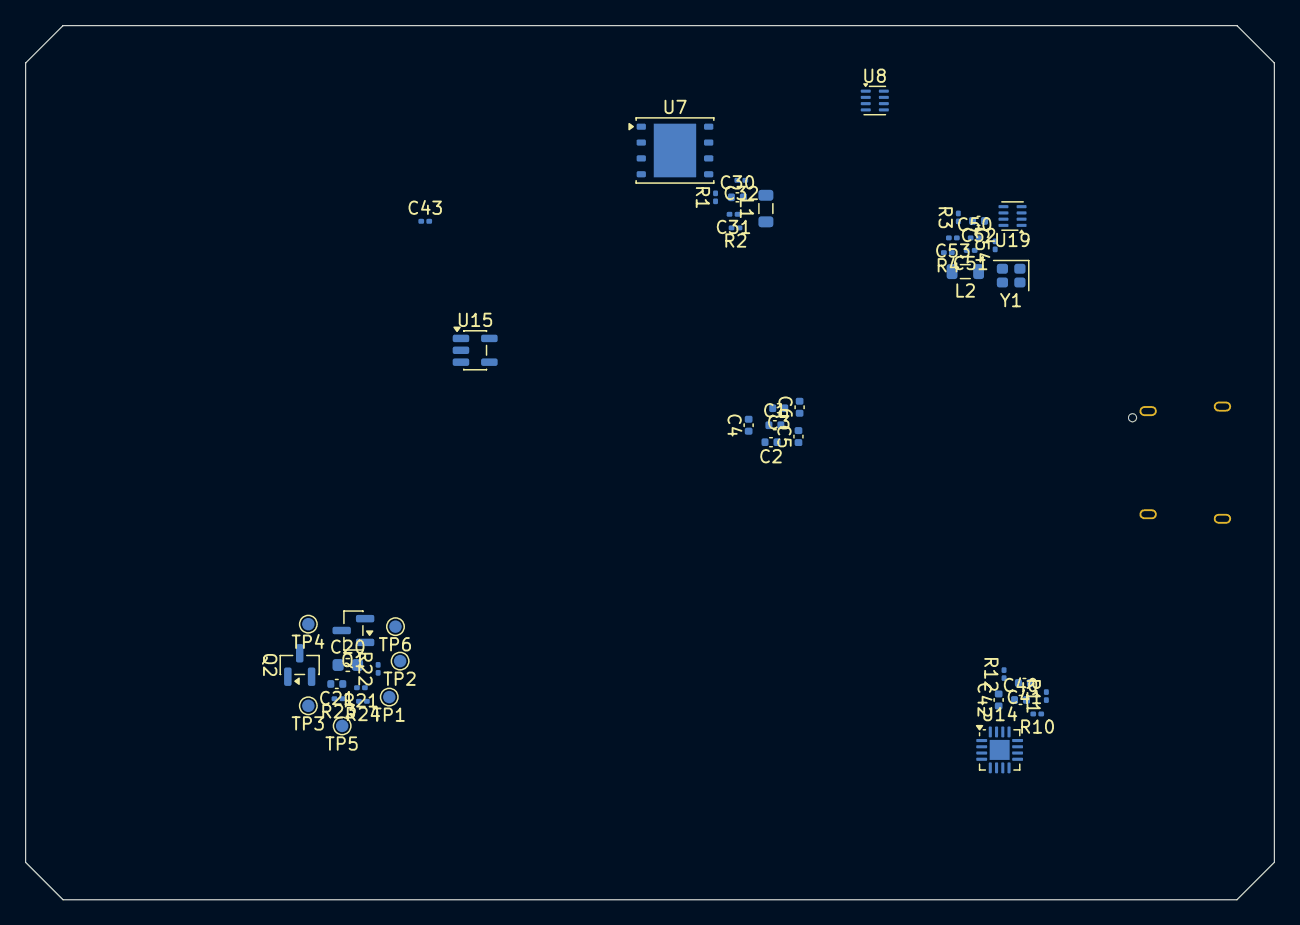
[picture p7: board main_board.kicad_pcb from below]

Board: 8 copper layers, 100.0 x 70.0 mm, 77 parts (47 on the bottom side), 221 nets, no tracks yet.
