jodancain/independent-cellular-ai-glasses/hardware/v0.1/kicad/mcu_board/mcu_board.kicad_pcb

## KiCad design hardware/v0.1/kicad/mcu_board/mcu_board.kicad_pcb (2026-11-05)

Schematic: mcu_board.kicad_sch, MCU 常驻板（小脑常驻 · 脚的 BLE · 耳朵和嘴巴）

Parts:
AE1: 2.4GHz 片状天线; Johanson_2450AT18x100
C1, C11, C55, C63: 10uF; C_0402_1005Metric
C2, C12, C44, C61, C62, C64: 4.7uF; C_0402_1005Metric
C3, C13, C60: 1uF; C_0402_1005Metric
C4, C5, C6, C14, C15, C16, C17, C18, C22, C30, C31, C40, C42, C45, C50, C51, C56, C70: 100nF; C_0201_0603Metric
C21: 2.2uF; C_0201_0603Metric
C23, C24: 8pF; C_0201_0603Metric
C25, C26: 6pF; C_0201_0603Metric
C41, C65: 1uF; C_0201_0603Metric
C43: 47nF; C_0201_0603Metric
C46, C47: 12pF; C_0201_0603Metric
C48: 0.8pF; C_0201_0603Metric
D1: 状态灯; LED_0402_1005Metric
J1: 板间 DF40 40P（至主板）; Hirose_DF40C-40DS-0.4V_2x20_P0.4mm
J2: 右侧电池; JST_SH_SM03B-SRSS-TB_1x03-1MP_P1.00mm_Horizontal
J3: 扬声器; JST_SH_SM02B-SRSS-TB_1x02-1MP_P1.00mm_Horizontal
J4: SWD（N6 + nRF）; Tag-Connect_TC2030-IDC-NL_2x03_P1.27mm_Vertical
L1: 2.2uH; L_0805_2012Metric
L2: 10uH; L_0603_1608Metric
L3: 15nH; L_0402_1005Metric
L4: 3.9nH; L_0201_0603Metric
L5: 0.47uH; L_0805_2012Metric
MK1: PDM 麦克风 L; Knowles_LGA-5_3.5x2.65mm
MK2: PDM 麦克风 R; Knowles_LGA-5_3.5x2.65mm
R1, R22, R23: 10k; R_0201_0603Metric
R2: 4.02k 1%; R_0201_0603Metric
R10: 1.13k; R_0201_0603Metric
R11: 3.0k; R_0201_0603Metric
R12: 46.4k; R_0201_0603Metric
R13: 200k; R_0201_0603Metric
R14: 100k; R_0201_0603Metric
R15: 0; R_0201_0603Metric
R16, R17: 1M; R_0201_0603Metric
R20, R21: 2.2k; R_0201_0603Metric
R24: 1k; R_0201_0603Metric
R25: 0; R_0201_0603Metric; not fitted
SW1: 电源 / 唤醒键; SW_SPST_PTS810
U1: STM32N657X0H3Q; ST_VFBGA-264_14x14mm_P0.8mm
U2: APS6404L 64Mb PSRAM 1.8V; Winbond_USON-8-1EP_3x2mm_P0.5mm_EP0.2x1.6mm
U3: W25Q128JW 1.8V NOR; WSON-8-1EP_6x5mm_P1.27mm_EP3.4x4.3mm
U4: nRF52832-QFAA; QFN-48-1EP_6x6mm_P0.4mm_EP4.6x4.6mm
U5: MAX98357A; TQFN-16-1EP_3x3mm_P0.5mm_EP1.23x1.23mm
U6: BQ24075; VQFN-16-1EP_3x3mm_P0.5mm_EP1.6x1.6mm
U7: TPS62823 1.8V; Texas_VSON-HR-8_1.5x2mm_P0.5mm
U8: TLV75533 3.3V; SOT-23-5
U9: APDS-9160 佩戴检测; Broadcom_APDS-9160-003
Y1: 48MHz; Crystal_SMD_2016-4Pin_2.0x1.6mm
Y2: 32.768kHz; Crystal_SMD_2012-2Pin_2.0x1.2mm
Y3: 32MHz; Crystal_SMD_2016-4Pin_2.0x1.6mm

Connections:
+1V8: C11.1, C12.1, C13.1, C14.1, C15.1, C16.1, C17.1, C18.1, C30.1, C31.1, C44.1, C45.1, C50.1, C51.1, C63.1, D1.2 (A), J4.1, L5.2, MK1.5 (VDD), MK2.2 (SEL), MK2.5 (VDD), R13.1, R15.1, U1.A1 (PDR_ON), U1.A4 (VDD33USB), U1.C5 (VDDA18USB), U1.E1 (VBAT), U1.E8 (VDDIO4), U1.E9 (VDDIO5), U1.F6 (VDDA18AON), U1.F8 (VDDIO4), U1.F9 (VDDIO5), U1.G1 (VDDA18PMU), U1.G13 (VDD), U1.H12 (VDD), U1.H13 (VDD), U1.J12 (VDD), U1.J13 (VDD), U1.K1 (VDDSMPS), U1.K2 (VDDSMPS), U1.K3 (VDDSMPS), U1.K4 (VDDSMPS), U1.K5 (VDDSMPS), U1.K6 (VDDSMPS), U1.K13 (VDD), U1.L13 (VDDIO2), U1.L14 (VDDIO2), U1.M5 (VDDA18PLL), U1.M14 (VDDIO2), U1.M15 (VDDIO2), U1.N6 (VDDA18ADC), U1.N13 (VDDIO3), U1.P13 (VDDIO3), U1.R5 (VDDA18CSI), U2.8 (VDD), U3.8 (VCC), U4.13 (VDD), U4.36 (VDD), U4.48 (VDD)
+1V8_AON: J1.5, R15.2, R20.2, R21.2, R22.2, R23.2, U6.5 (EN2)
+3V3: C65.1, C70.1, U8.5 (OUT), U9.5 (LEDA), U9.6 (VDD)
AMP_SD_MODE: U1.R12 (PA7), U5.4 (~SD_MODE)
BAT_NTC: J2.2, U6.1 (TS)
BLE_ANT: L4.1, U4.30 (ANT)
BLE_DCC: L2.1, U4.47 (DCC)
BLE_DCC_L: L2.2, L3.1
BLE_DEC1: C40.1, U4.1 (DEC1)
BLE_DEC2: C42.1, U4.32 (DEC2)
BLE_DEC3: C43.1, U4.33 (DEC3)
BLE_DEC4: C41.1, L3.2, U4.46 (DEC4)
BLE_IRQ: U1.U14 (PA4), U4.14 (P0.11)
BLE_RESET_N: U1.R8 (PA5), U4.24 (P0.21/~RESET)
BLE_RF: AE1.1 (FEED), C48.1, L4.2
BLE_SWCLK: R25.1, U4.25 (SWDCLK)
BLE_SWDIO: J4.6, U4.26 (SWDIO)
BLE_UART_CTS: U1.M2 (PF3), U4.9 (P0.07)
BLE_UART_RTS: U1.M4 (PG5), U4.7 (P0.05/AIN3)
BLE_UART_RX: U1.D14 (PD5), U4.10 (P0.08)
BLE_UART_TX: U1.D9 (PC2), U4.8 (P0.06)
BLE_XC1: C46.1, U4.34 (XC1), Y3.1
BLE_XC2: C47.1, U4.35 (XC2), Y3.3
BTN_PWR: R23.1, SW1.1, U1.R11 (PB1)
BUCK_FB: R13.2, R14.1, U7.2 (FB)
BUCK_SW: L5.1, U7.6 (SW)
CAM_MCU_CKN: J1.26, U1.U3 (CSI_CKN)
CAM_MCU_CKP: J1.25, U1.T3 (CSI_CKP)
CAM_MCU_D0N: J1.29, U1.U5 (CSI_D0N)
CAM_MCU_D0P: J1.28, U1.T5 (CSI_D0P)
CAM_MCU_D1N: J1.32, U1.U4 (CSI_D1N)
CAM_MCU_D1P: J1.31, U1.T4 (CSI_D1P)
CAM_SEL: J1.18, U1.U7 (PA12)
CELL_PWR_EN: J1.15, U1.T8 (PA2)
CHG_ILIM: R10.1, U6.12 (ILIM)
CHG_ISET: R11.1, U6.16 (ISET)
CHG_PGOOD_N: U1.U8 (PA8), U6.7 (~PGOOD)
CHG_STAT_N: U1.P7 (PA9), U6.9 (~CHG)
CHG_TMR: R12.1, U6.14 (TMR)
DISP_LS_CS: J1.22, U1.P9 (PA1)
DISP_LS_DC: J1.23, U1.R7 (PA10)
DISP_LS_MOSI: J1.21, U1.P6 (PG14)
DISP_LS_SCK: J1.20, U1.C8 (PC12)
DISP_SEL: J1.17, U1.T7 (PA11)
FLASH_CLK: U1.P15 (PN6), U3.6 (CLK)
FLASH_CS: U1.R17 (PN1), U3.1 (~CS)
FLASH_IO0: U1.T17 (PN2), U3.5 (DI/IO0)
FLASH_IO1: U1.R15 (PN3), U3.2 (DO/IO1)
FLASH_IO2: U1.N17 (PN4), U3.3 (~WP/IO2)
FLASH_IO3: U1.R16 (PN5), U3.7 (~HOLD/IO3)
GND: C1.2, C2.2, C3.2, C4.2, C5.2, C6.2, C11.2, C12.2, C13.2, C14.2, C15.2, C16.2, C17.2, C18.2, C21.2, C22.2, C23.2, C24.2, C25.2, C26.2, C30.2, C31.2, C40.2, C41.2, C42.2, C43.2, C44.2, C45.2, C46.2, C47.2, C48.2, C50.2, C51.2, C55.2, C56.2, C60.2, C61.2, C62.2, C63.2, C64.2, C65.2, C70.2, J1.3, J1.4, J1.6, J1.19, J1.24, J1.27, J1.30, J1.33, J1.39, J1.40, J2.3, J4.5, MK1.2 (SEL), MK1.3 (GND), MK2.3 (GND), R1.2, R2.2, R10.2, R11.2, R12.2, R14.2, R17.2, SW1.2, U1.A17 (VSS), U1.F2 (VSSAPMU), U1.F7 (VSS), U1.F10 (VSS), U1.F11 (VSS), U1.F12 (VSS), U1.G6 (VSSAON), U1.G12 (VSS), U1.H1 (VSSSMPS), U1.H2 (VSSSMPS), U1.H3 (VSSSMPS), U1.H4 (VSSSMPS), U1.H5 (VSSSMPS), U1.H6 (VSSSMPS), U1.K12 (VSS), U1.M6 (VSSA), U1.M8 (VSS), U1.M10 (VSS), U1.M12 (VSS), U1.M13 (VSS), U1.N5 (VSS), U1.N7 (VSS), U1.N9 (VSS), U1.N11 (VSS), U1.T2 (VREF-), U1.U1 (VSS), U1.U17 (VSS), U2.4 (VSS), U2.9 (EPAD), U3.4 (GND), U3.9 (EP), U4.31 (VSS), U4.45 (VSS), U4.49 (VSS), U5.3 (GND), U5.11 (GND), U5.15 (GND), U5.17 (PAD), U6.4 (~CE), U6.6 (EN1), U6.8 (VSS), U6.15 (SYSOFF), U6.17 (VSS), U7.3 (AGND), U7.5 (PGND), U8.2 (GND), U9.1 (GND), Y1.2 (G), Y1.4 (G), Y3.2 (G), Y3.4 (G)
HSE_IN: C23.1, U1.A7 (PH0-OSC_IN(PH0)), Y1.1
HSE_OUT: C24.1, U1.B7 (PH1-OSC_OUT(PH1)), Y1.3
I2C_PWR_SCL: J1.34, R20.1, U1.C11 (PE5), U9.8 (SCL)
I2C_PWR_SDA: J1.35, R21.1, U1.A9 (PC1), U9.7 (SDA)
I2S_BCLK: U1.E17 (PB6), U5.16 (BCLK)
I2S_DOUT: U1.C12 (PD2), U5.1 (DIN)
I2S_LRCLK: U1.E15 (PB0), U5.14 (LRCLK)
LED_K: D1.1 (K), R24.1
LED_STAT: R24.2, U1.U11 (PB10)
LSE_IN: C25.1, U1.D1 (PC14-OSC32_IN(OSC32_IN)), Y2.1
LSE_OUT: C26.1, U1.C1 (PC15-OSC32_OUT(OSC32_OUT)), Y2.2
MCU_IRQ_TO_SOC: J1.11, U1.R13 (PG0)
MIC_PDM_CLK: J1.37, MK1.4 (CLOCK), MK2.4 (CLOCK), U1.F15 (PE2)
MIC_PDM_DAT: J1.38, MK1.1 (DATA), MK2.1 (DATA), U1.A15 (PE8)
N6_BOOT0: R1.1, U1.G4 (BOOT0)
N6_CSI_REXT: R2.1, U1.P5 (CSI_REXT)
N6_NRST: C22.1, J4.3, U1.G3 (NRST)
N6_SMPS_LX: L1.1, U1.J1 (VLXSMPS), U1.J2 (VLXSMPS), U1.J3 (VLXSMPS), U1.J4 (VLXSMPS), U1.J5 (VLXSMPS), U1.J6 (VLXSMPS)
N6_SWCLK: J4.4, R25.2, U1.T6 (PA14(JTCK/SWCLK))
N6_SWDIO: J4.2, U1.U6 (PA13(JTMS/SWDIO))
N6_V08CAP: C21.1, U1.F1 (V08CAP)
PROX_LDR: U9.3 (LDR), U9.4 (LEDK)
PSRAM_CLK: U1.N16 (PO4), U2.6 (SCLK)
PSRAM_CS: U1.M17 (PO0), U2.1 (~CE)
PSRAM_IO0: U1.G17 (PP0), U2.5 (SI/SIO0)
PSRAM_IO1: U1.H16 (PP1), U2.2 (SO/SIO1)
PSRAM_IO2: U1.J17 (PP2), U2.3 (SIO2)
PSRAM_IO3: U1.J16 (PP3), U2.7 (SIO3)
SOC_PWR_EN: J1.14, U1.U13 (PG11)
SOC_RESET_N: J1.13, U1.T10 (PG10)
SOC_SPI_CS: J1.10, U1.B2 (PH6)
SOC_SPI_MISO: J1.8, U1.B15 (PD4)
SOC_SPI_MOSI: J1.9, U1.D2 (PH7)
SOC_SPI_SCK: J1.7, U1.A12 (PE15)
SOC_WAKE_REQ: J1.12, U1.R9 (PG1)
SPK_N: J3.2, U5.10 (OUTN)
SPK_P: J3.1, U5.9 (OUTP)
VBAT: C62.1, J2.1, R16.1, U6.2 (BAT), U6.3 (BAT)
VBAT_SENSE: R16.2, R17.1, U1.U10 (PA0)
VBUS: C60.1, J1.1, J1.2, U6.13 (IN)
VCORE_0V8: C1.1, C2.1, C3.1, C4.1, C5.1, C6.1, L1.2, U1.G2 (VFBSMPS), U1.L6 (VDDCORE), U1.L12 (VDDCORE), U1.M7 (VDDCORE), U1.M9 (VDDCORE), U1.M11 (VDDCORE), U1.N8 (VDDCORE), U1.N10 (VDDCORE), U1.N12 (VDDCORE), U1.P11 (VDDCORE), U1.R4 (VDDCSI)
VSYS: C55.1, C56.1, C61.1, C64.1, U5.7 (VDD), U5.8 (VDD), U6.10 (OUT), U6.11 (OUT), U7.1 (EN), U7.7 (VIN), U8.1 (IN), U8.3 (EN)
WEAR_DET: J1.36, R22.1, U1.P8 (PA6), U9.2 (INT)
WIFI_PWR_EN: J1.16, U1.R14 (PA3)

Notes on the sheet:
MCU 常驻板（小脑常驻 · 脚的 BLE · 耳朵和嘴巴） · 右镜腿形 78×16 mm，6 层，双面贴装 · MCU A 案：STM32N657 + nRF52832（常驻 BLE） · 去耦电容为初版代表值，须按各芯片手册补全 · 未布线：只有布局与飞线

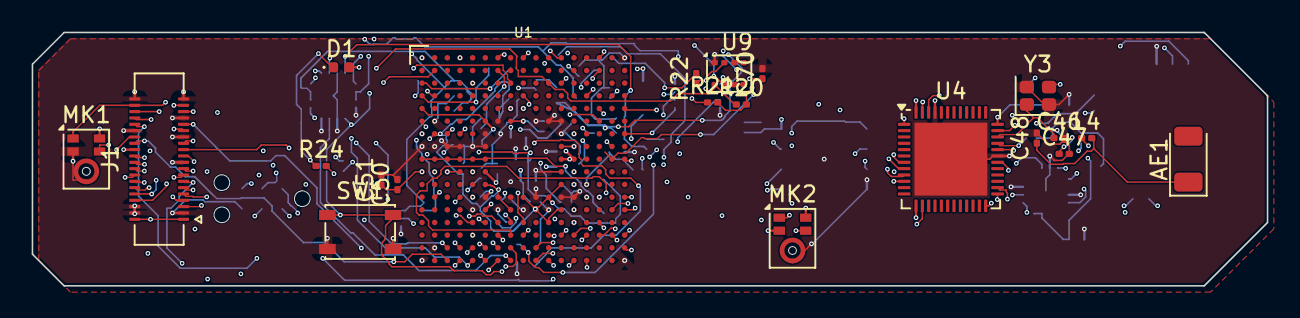
[picture p8: board mcu_board.kicad_pcb from above]

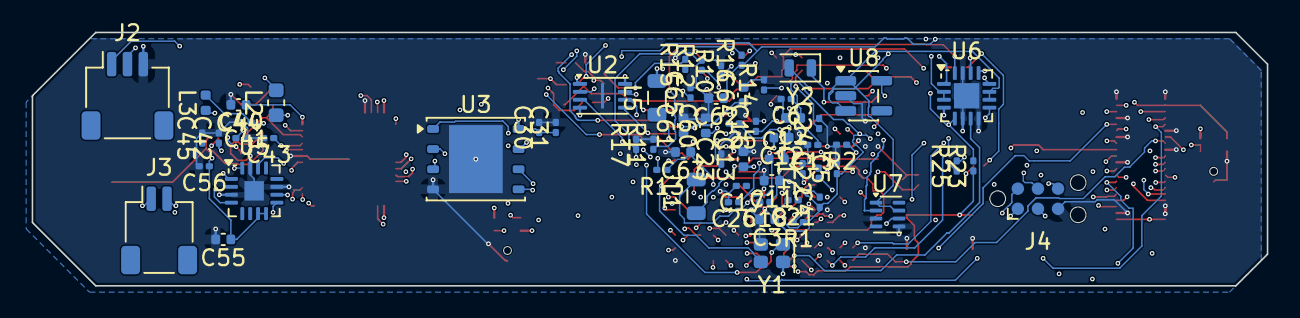
[picture p9: board mcu_board.kicad_pcb from below]

Board: 6 copper layers, 78.0 x 16.0 mm, 84 parts (63 on the bottom side), 95 nets.
