jodancain/independent-cellular-ai-glasses/(commit log)

2026-11-04 docs: 新增串流方向梳理（串流终端/投屏兼容/强休眠）
    - 新增 docs/streaming-direction.md：围绕三项目标的方向与技术要求梳理
    1. Quest 2 级设备的 AR 眼镜版（轻量眼镜 + 外部主机串流 + 5G 独立上网）
    2. 投屏/转化层对软件的兼容（目标非已验证结果，标注边界与待确认）
    3. 强休眠（低功耗休眠+快速唤醒解读，含义待确认）
    - README 增加文档索引链接
    - 全文区分方向/技术要求/可行性边界/待验证项，不含固件或私有实现细节
2026-11-04 docs: 串流终端方向 v0.2——有线/Wi-Fi 7/5G 架构、五层兼容、分级睡眠、芯片组合
2026-11-04 docs: 确认睡眠能力为低功耗待机+快速唤醒
2026-11-04 docs: 串流终端方向 v0.3——联网全功能/断网手表模式、6DoF 交互、四类主机、主+协处理器
2026-11-04 docs: 串流终端方向 v0.4——默认无线、视频通话拉满、同步接口、手表小程序、蜂窝最低要求
2026-11-04 docs: 串流终端方向 v0.5——虚拟形象、双运行时、8 小时续航预算、开放云
2026-11-04 docs: 确认 8 小时续航按机身混合使用计算，补充验收剖面
2026-11-04 docs: 串流终端方向 v0.6——重量对标主流与人体工学，冻结 8 小时剖面
2026-11-04 docs: 串流终端方向 v0.7——续航优先，重量后移实现佩戴无感
2026-11-04 docs: 新增现成硬件验证计划（6 组），方案 v0.7.1 明确并发时延取 50 ms
    第 1–3 组初稿由 DeepSeek（dsh-run）撰写，总框架、第 4–6 组与审核合并由 Claude 完成。
2026-11-04 第 1、3、6 组：设备准备清单与测试工具
    - docs/equipment-groups-1-3-6.md：候选设备（Quectel RedCap EVB + RG255C-GL、Otii Arc Pro / PPK2 等）与核实项
    - tools/：延迟计时页与统计、RedCap AT/测速/电流分析、人体工学统计（26 项单元测试通过）
    - 工具代码由 DeepSeek（dsh-run）编写，设备清单与审核由 Claude 完成
    [current_sample.csv, ergo_scores_sample.csv, ergo_weights_sample.csv, latency_drift_sample.csv, latency_sample.csv, redcap_at_log_sample.csv]
2026-11-04 docs: 新增技术路线 v0.1（四芯片结构、主备选与切换条件、软件栈与开放协议、M0–M3 阶段）；方案 v0.7.2 改正续航剖面算术与重量估算
    DeepSeek（dsh-run, DeepSeek-V4.1-Flash-1017）做了一致性交叉检查，已按其意见修订。
2026-11-04 docs: 系统架构图初版（9 张 Mermaid 图 + Remotion 信号流动动画单文件 HTML）与设计开发要求 v0.1（167 条）；统一手机 V1、手表功耗、AR1+ 门禁等口径
    设计开发要求由 DeepSeek（dsh-run, DeepSeek-V4.1-Flash-1017）起草，已审核。
2026-11-04 眼动改为当前版本只做预留（需求方决定 #20，方案 v0.7.3）；新增网页版站点生成脚本，公网发布于 glasses.youngtuo.win
    眼动相关文档同步由 DeepSeek（dsh-run, DeepSeek-V4.1-Flash-1017）完成，已审核。
2026-11-04 显示改为只用光波导（决定 #21，方案 v0.7.4）；新增视频与显示处理器可选路线；网站、9 张动态架构图与宣传片按定稿视觉重做
    - 定稿视觉：暗场 + 暖白单色信号、Barlow + 思源黑体、直角走线框图、慢速光束
    - 动态架构图：ELK 直角走线排版（硬件框图手工排版），Remotion 播放页
    - 宣传片：112 s，配乐由代码合成（scripts/make_music.py）
    - 文档同步由 DeepSeek（dsh-run, DeepSeek-V4.1-Flash-1017）完成，已审核
2026-11-05 交互架构定为脑 / 小脑 / 手（决定 #22–#24，方案 v0.7.5）
    - 新增六种显示模式与小脑调度、手的统一接入（Mika 改造、BLE 控制面）
    - 硬件跟随调整：MCU 常驻 BLE（A/B 两案）、看板态、常驻听音、新使用剖面；HW-DP-06 降为 P2
    - 设计要求增至 191 条，验证计划第 4 组新增三项；MCU 框图与站点同步
2026-11-05 框图、宣传片与网站全部按脑 / 小脑 / 手更新
    - 9 张框图重画并新增第 10 张“显示模式与小脑调度”：全景加脑与 BLE 控制面，硬件图加 MCU 常驻听音，数据通路与状态机加看板态，软件栈加 Mika 手与云端 LLM，协议加看板描述与 BLE，部署加自建 LLM
    - 架构图文档 v0.2 同步全部 Mermaid 图；芯片候选补 BES2800BP 的 B 案角色；手机主机描述改为 Mika 改造版
    - 宣传片重做愿景、架构、连接、显示模式、续航、一天体验、路线与结尾；首页文案同步
2026-11-05 宣传片改为以图为主：脑 / 手 / 器官图标、眼镜视野里的“打开 QQ”演示、一天七幅插画、续航与路线图标
2026-11-05 网站宣传片链接带内容哈希，换片后不被 CDN 旧缓存挡住
2026-11-05 宣传片 v3「她的进化」：拟人化眼镜第一人称讲述；与传统 AI 眼镜强对比（看 / 做 / 连 / 手）；Agent 替你操作手机；手渲染再投屏；Say No to AI 手机
2026-11-05 更新宣传片成片（v3「她的进化」，112 秒）
2026-11-05 新增技术全解片（24 章，约 8 分 34 秒）：设计、架构、链路、功耗、协议、验证与路线逐章讲解；网站视频页并列宣传片与技术片
2026-11-05 新增硬件初版 v0.1：两块板的 KiCad 原理图与初版布局（MCU 常驻板全真实器件，主板主 SoC 等为占位，未布线），网站硬件页用 three.js 查看原理图、三维 PCB 与装进眼镜示意
    [BOM_JLCPCB.csv, kicad-bom.csv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]
2026-11-05 脑、小脑、手、脚贯穿全方案（决定 #25，方案 v0.7.6）：连接正式定为脚；方案加四角色对照表，路线标芯片角色，设计开发要求 194 条加角色映射与脑的需求，验证计划按角色，10 张图与硬件初版标角色；技术全解与宣传片同步
    [main_board-B_Courtyard.gbr, main_board-B_Cu.gbl, main_board-B_Fab.gbr, main_board-B_Mask.gbs, main_board-B_Paste.gbp, main_board-B_Silkscreen.gbo, main_board-Edge_Cuts.gm1, main_board-F_Courtyard.gbr]
2026-11-05 投屏与多路信号：方案新增 §3.11 多路信号与并发、§4.5 投屏处理链路；路线加主 SoC 并发门禁、显示处理器多层叠加、输入回传；设计开发要求增至 202 条；验证计划加多屏与操作回传基线；第 11 张图；硬件 FPGA 加叠加层输入；技术全解加第 16 章
    [main_board-B_Courtyard.gbr, main_board-B_Cu.gbl, main_board-B_Fab.gbr, main_board-B_Mask.gbs, main_board-B_Paste.gbp, main_board-B_Silkscreen.gbo, main_board-Edge_Cuts.gm1, main_board-F_Courtyard.gbr]
2026-11-05 检查完善：路线 M1 出口补全流程 / 投屏 / 并发三项，供应商问题加并发、叠加、WMM 与音频；设计开发要求角色映射覆盖全部 202 条；供应商回复模板加串流终端方向补充表；硬件查看页适配手机
2026-11-05 MCU 常驻板自动布线：Freerouting 扇出 + 三遍布线，约 96% 连通、0 短路，剩 12 处待人工；6 层叠层与嘉立创规则写入工程；导出、Gerber 与 three.js 查看页同步
    [CPL_JLCPCB.csv, kicad-pos.csv, mcu_board-B_Courtyard.gbr, mcu_board-B_Cu.gbl, mcu_board-B_Fab.gbr, mcu_board-B_Mask.gbs, mcu_board-B_Paste.gbp, mcu_board-B_Silkscreen.gbo]
2026-11-05 MCU 常驻板补线：自写网格迷宫布线器补 5 条、清掉间距与悬空短线；剩 4 处断线待人工，0 短路、0 间距
    [mcu_board-B_Courtyard.gbr, mcu_board-B_Cu.gbl, mcu_board-B_Fab.gbr, mcu_board-B_Mask.gbs, mcu_board-B_Paste.gbp, mcu_board-B_Silkscreen.gbo, mcu_board-Edge_Cuts.gm1, mcu_board-F_Courtyard.gbr]
2026-11-09 主板去占位：RG255C-GL 换真实引脚与 LGA-204 焊盘，LT7911UXC 定封装与外围；方案补开源样机、嘉立创打样分工
    硬件（hardware/v0.1）
    - RG255C-GL：204 个引脚名与 LGA-204（32×29 mm）焊盘来自立创 EDA 公开库 C22437156（generator/vendor/），接好电源、PCIe、USIM1、天线与控制脚；PWRKEY / RESET_N 经 Q1 / Q2 开集驱动；USB_BOOT、调试串口、USB 引到 TP1–TP6
    - LT7911UXC：按龙迅公开产品简介改为 BGA169 9×9 mm、3.3 V + 1.1 V（新增 U19 TPS62823 降压）、25 MHz 晶振 Y1；球位仍为占位
    - 主板占位 13 → 12；ERC 仍为 2 条已知项，DRC 无新增硬错误；MCU 常驻板布线未动
    - 查看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
    [BOM_JLCPCB.csv, kicad-bom.csv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]
2026-11-09 方案：结合应用原型补投屏、远程视频与端侧视觉算法（原型经验 v0.1，要求 218 条）
    - 新增 docs/prototype-learnings.md：第一视角投屏（PIN 配对、≤3 人、无人观看不编码、只发最新帧、分析优先降档）与专家标注回传；远程视频通话路线收敛、六档带宽自适应、会议编号与短时票据、眼镜三种入会方式；头姿缓冲与相机–IMU 时间对齐、9 参数显示–相机标定、质量门与静止门、CLAHE + ORB + 单应投影；Agent 边界与来源标注。两张 Mermaid 图
    - 技术路线 v0.1.4：新增 §2.4 原型验证过的链路与算法
    - 设计开发要求 v0.3.3：新增 CALL-19–22、SW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
